TUFRG/LSF-Rig-GT2026-176284/Latest Assembly/Probe Holder Handoff/Documentation/BOM.xls

Bill of Material: Probe Holder Assy
Quantity | Part Number
2 | 94459A769_Heat-Set Inserts for Plastic
2 | Top Clamp
1 | Plunger Holder
1 | 4232N22_Press-Fit Ball-Nose Spring Plunger
1 | Brace
1 | Probe Holder/Turner
8 | 90128A217_Zinc-Plated Alloy Steel Socket Head Screw
8 | 90591A255_Zinc-Plated Steel Hex Nut
Recapitulation of: Probe Holder Assy
Different parts: 8
Total parts: 24
Quantity | Part Number
2 | 94459A769_Heat-Set Inserts for Plastic
2 | Top Clamp
1 | Plunger Holder
1 | 4232N22_Press-Fit Ball-Nose Spring Plunger
1 | Brace
1 | Probe Holder/Turner
8 | 90128A217_Zinc-Plated Alloy Steel Socket Head Screw
8 | 90591A255_Zinc-Plated Steel Hex Nut
