TUFRG/LSF-Rig-GT2026-176284/Latest Assembly/Probe Holder Handoff/90128A217_Zinc-Plated Alloy Steel Socket Head Screw.STEP

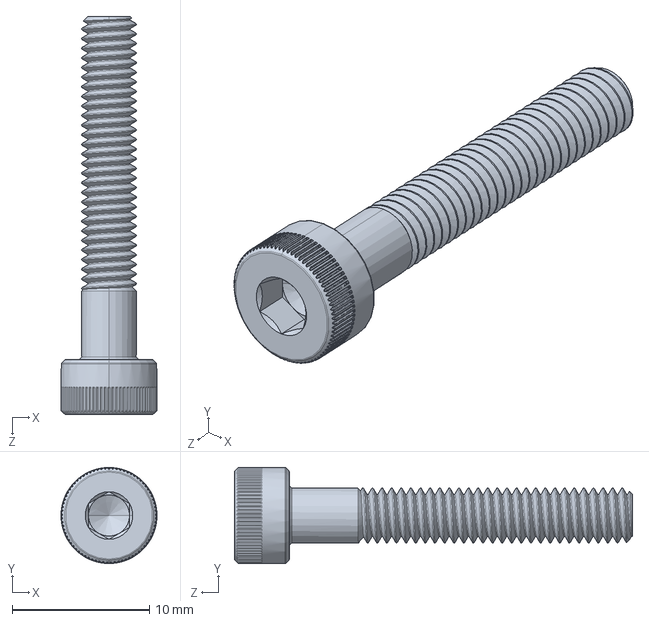
[picture p10: CAD file, 2026-10-14]
Latest Assembly/Probe Holder Handoff/90128A217_Zinc-Plated Alloy Steel Socket Head Screw.STEP
7.00 x 7.00 x 29.0 mm
