TUFRG/LSF-Rig-GT2026-176284/Latest Assembly/Probe Holder Handoff/94459A769_Heat-Set Inserts for Plastic.STEP

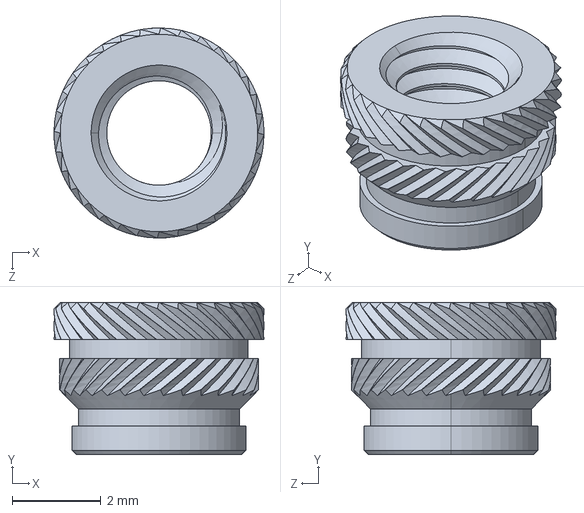
[picture p11: CAD file, 2026-10-14]
Latest Assembly/Probe Holder Handoff/94459A769_Heat-Set Inserts for Plastic.STEP
4.72 x 3.43 x 4.72 mm
