TUFRG/LSF-Rig-GT2026-176284/Latest Assembly/Probe Holder Handoff/90591A255_Zinc-Plated Steel Hex Nut.STEP

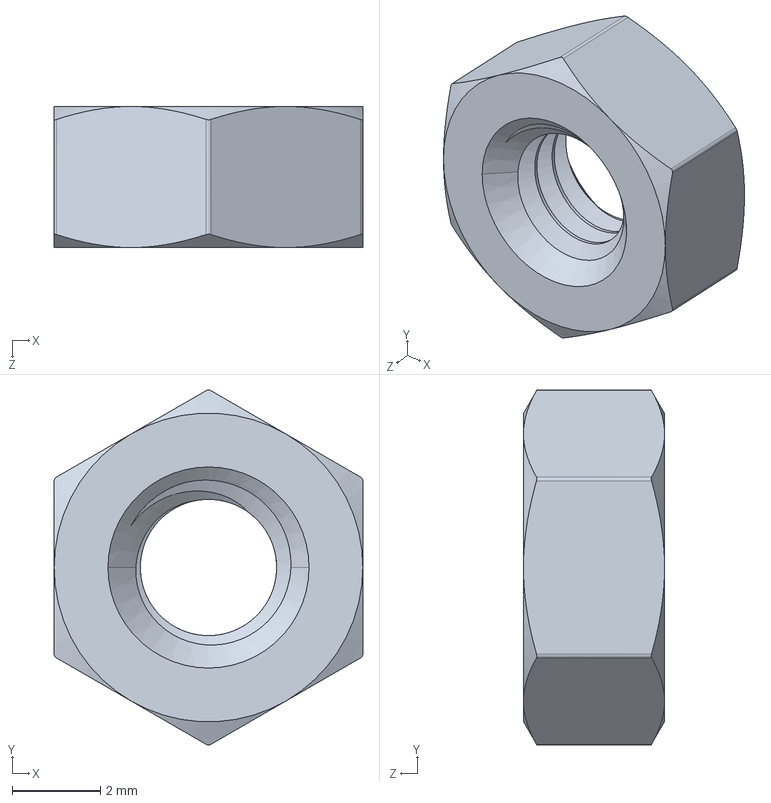
[picture p12: CAD file, 2026-10-14]
Latest Assembly/Probe Holder Handoff/90591A255_Zinc-Plated Steel Hex Nut.STEP
7.00 x 8.05 x 3.20 mm
