TUFRG/LSF-Rig-GT2026-176284/Latest Assembly/Probe Holder Handoff/4232N22_Press-Fit Ball-Nose Spring Plunger.STEP

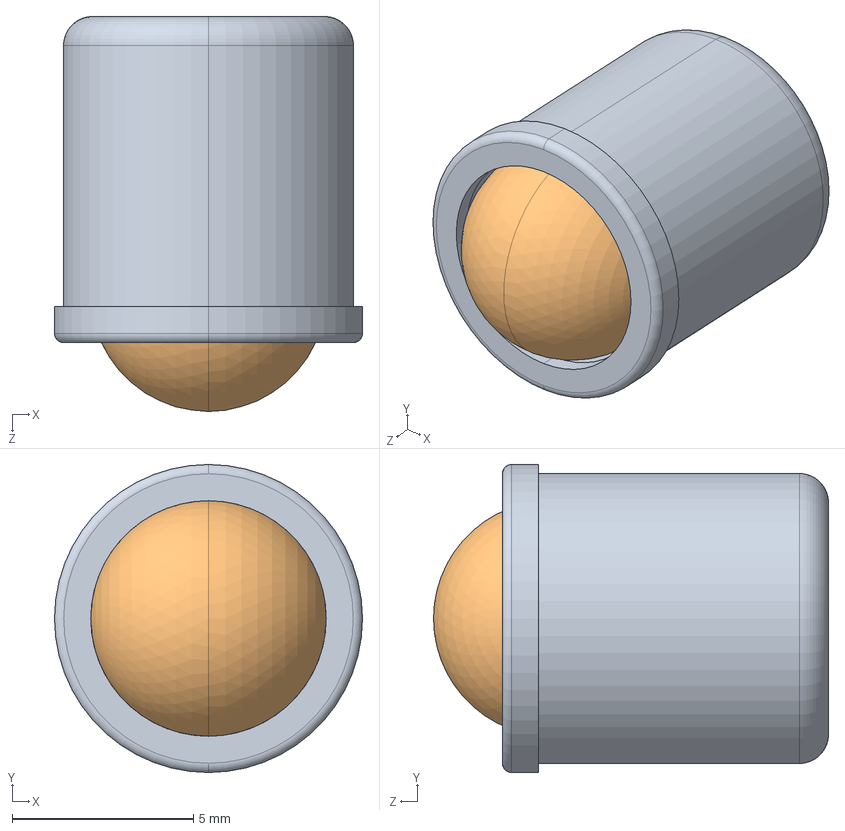
[picture p13: CAD file, 2026-10-14]
Latest Assembly/Probe Holder Handoff/4232N22_Press-Fit Ball-Nose Spring Plunger.STEP
8.50 x 8.50 x 10.9 mm
