TUFRG/LSF-Rig-GT2026-176284/(list of files, cad)

Other CAD files:
Latest Assembly/0_ISO-Bell Mouth.CATPart
Latest Assembly/10_Helical Rack.CATPart
Latest Assembly/11-Traverse Sliding Ring.CATPart
Latest Assembly/13-Rotor Hub Abradable - 2.CATPart
Latest Assembly/13-Rotor Hub Abradable 1.CATPart
Latest Assembly/14-Strut Hub Abradable - 2.CATPart
Latest Assembly/14-Strut Hub Abradable 1.CATPart
Latest Assembly/15-Upstream Traverse Plugs.CATPart
Latest Assembly/16-Downstream Traverse Plugs.CATPart
Latest Assembly/1_Distortion Screen Casing Ring.CATPart
Latest Assembly/2_Rotor Casing Ring.CATPart
Latest Assembly/3_Stator_Casing_Ring.CATPart
Latest Assembly/4_Strut Casing Ring.CATPart
Latest Assembly/5_Hub.CATPart
Latest Assembly/6391K332_Oil-Embedded 841 Bronze Sleeve Bearing.1.CATPart
Latest Assembly/6627T923_Stepper Motor.CATPart
Latest Assembly/6_Spinner.CATPart
Latest Assembly/8-Stator Sector 1.CATPart
Latest Assembly/8-Stator Sector 2.CATPart
Latest Assembly/8-Stator Sector 3.CATPart
Latest Assembly/9-Traverse Base Plate.CATPart
Latest Assembly/91860A030_17-7 PH Stainless Steel Washer.1.CATPart
Latest Assembly/92620A540_Zinc Yellow-Chromate Plated Hex Head Screw.3.CATPart
Latest Assembly/94033A426_Male-Female Pillar Post.1.CATPart
Latest Assembly/9657K495_Compression Spring.1.CATPart
Latest Assembly/97042A172_18-8 Stainless Steel Threaded on One End Stud.2.CATPart
Latest Assembly/Assembly.CATProduct
Latest Assembly/Base.CATPart
Latest Assembly/Collar Thrsut Bearing.CATPart
Latest Assembly/Delrin Sheet.CATPart
Latest Assembly/Extrusion Support/Motor Support/1000.CATPart
Latest Assembly/Extrusion Support/Motor Support/1000mm.CATPart
Latest Assembly/Extrusion Support/Motor Support/460.CATPart
Latest Assembly/Extrusion Support/Motor Support/5537T946_T-Slotted Framing.CATPart
Latest Assembly/Extrusion Support/Motor Support/Base for Extrusion.CATPart
Latest Assembly/Extrusion Support/Motor Support/Motor Support base.CATPart
Latest Assembly/Extrusion Support/Motor Support/Motor Support.CATProduct
Latest Assembly/Extrusion Support/Motor Support/Motor base.CATPart
Latest Assembly/Extrusion Support/Motor Support/Motor.CATPart
Latest Assembly/Extrusion Support/Motor Support/Part1.CATPart
Latest Assembly/Extrusion Support/Motor Support/Plenum Leg Block.CATPart
Latest Assembly/Extrusion Support/Motor Support/QF100AssemblyWRed.CATPart
Latest Assembly/Extrusion Support/Motor Support/Support Leg Block.CATPart
Latest Assembly/Extrusion Support/Motor Support/Support Mockup.CATPart
Latest Assembly/Extrusion Support/Support 1 Base/12in brace.CATPart
Latest Assembly/Extrusion Support/Support 1 Base/200mm.CATPart
Latest Assembly/Extrusion Support/Support 1 Base/23595T17_Zinc-Plated Steel Wheel Axle (1).CATPart
Latest Assembly/Extrusion Support/Support 1 Base/2781T52_Polypropylene Wheel (1).CATPart
Latest Assembly/Extrusion Support/Support 1 Base/440mm.CATPart
Latest Assembly/Extrusion Support/Support 1 Base/5537T201_T-Slotted Framing.CATPart
Latest Assembly/Extrusion Support/Support 1 Base/570mm.CATPart
Latest Assembly/Extrusion Support/Support 1 Base/6in Brace.CATPart
Latest Assembly/Extrusion Support/Support 1 Base/94639A263_Off-White Nylon Unthreaded Spacer (1).CATPart
Latest Assembly/Extrusion Support/Support 1 Base/960mm.CATPart
Latest Assembly/Extrusion Support/Support 1 Base/Base Plate.CATPart
Latest Assembly/Extrusion Support/Support 1 Base/Connector.CATPart
Latest Assembly/Extrusion Support/Support 1 Base/Feet.CATPart
Latest Assembly/Extrusion Support/Support 1 Base/Gusset.CATPart
Latest Assembly/Extrusion Support/Support 1 Base/Part1.CATPart
Latest Assembly/Extrusion Support/Support 1 Base/Part2.CATPart
Latest Assembly/Extrusion Support/Support 1 Base/Support-1.CATProduct
Latest Assembly/Extrusion Support/Support 2/340mm.CATPart
Latest Assembly/Extrusion Support/Support 2/5537T373_T-Slotted Framing.CATPart
Latest Assembly/Extrusion Support/Support 2/5537T621_T-Slotted Framing.CATPart
Latest Assembly/Extrusion Support/Support 2/5537T671_T-Slotted Framing.CATPart
Latest Assembly/Extrusion Support/Support 2/560.CATPart
Latest Assembly/Extrusion Support/Support 2/650.CATPart
Latest Assembly/Extrusion Support/Support 2/760.CATPart
Latest Assembly/Extrusion Support/Support 2/90 connect.CATPart
Latest Assembly/Extrusion Support/Support 2/90 dbl feet.CATPart
Latest Assembly/Extrusion Support/Support 2/Connectpor.CATPart
Latest Assembly/Extrusion Support/Support 2/Part1.CATPart
Latest Assembly/Extrusion Support/Support 2/Part2.CATPart
Latest Assembly/Extrusion Support/Support 2/Support 2.CATProduct
Latest Assembly/Extrusion Support/Support 2/feet 45.CATPart
Latest Assembly/Extrusion Support/Support 3/12in brace.CATPart
Latest Assembly/Extrusion Support/Support 3/210mm.CATPart
Latest Assembly/Extrusion Support/Support 3/23595T17_Zinc-Plated Steel Wheel Axle (1).CATPart
Latest Assembly/Extrusion Support/Support 3/2781T52_Polypropylene Wheel (1).CATPart
Latest Assembly/Extrusion Support/Support 3/340mm.CATPart
Latest Assembly/Extrusion Support/Support 3/460mm.CATPart
Latest Assembly/Extrusion Support/Support 3/47065T121_T-Slotted Framing.CATPart
Latest Assembly/Extrusion Support/Support 3/47065T121_T-Slotted Framing_1.CATPart
Latest Assembly/Extrusion Support/Support 3/47065T121_T-Slotted Framing_2.CATPart
Latest Assembly/Extrusion Support/Support 3/47065T121_T-Slotted Framing_3.CATPart
Latest Assembly/Extrusion Support/Support 3/47065T121_T-Slotted Framing_4.CATPart
Latest Assembly/Extrusion Support/Support 3/47065T329_T-Slotted Framing.CATPart
Latest Assembly/Extrusion Support/Support 3/47065T841_T-Slotted Framing.CATPart
Latest Assembly/Extrusion Support/Support 3/4844N136_T-Slotted Framing Structural Bracket.CATPart
Latest Assembly/Extrusion Support/Support 3/570mm.CATPart
Latest Assembly/Extrusion Support/Support 3/6in Brace.CATPart
Latest Assembly/Extrusion Support/Support 3/760mm.CATPart
Latest Assembly/Extrusion Support/Support 3/94639A263_Off-White Nylon Unthreaded Spacer (1).CATPart
Latest Assembly/Extrusion Support/Support 3/BASE.CATPart
Latest Assembly/Extrusion Support/Support 3/BAse palte.CATPart
Latest Assembly/Extrusion Support/Support 3/Base mount.CATPart
Latest Assembly/Extrusion Support/Support 3/Connector.CATPart
Latest Assembly/Extrusion Support/Support 3/Feet.CATPart
Latest Assembly/Extrusion Support/Support 3/Gusset.CATPart
Latest Assembly/Extrusion Support/Support 3/RS BASE PLATE.CATPart
Latest Assembly/Extrusion Support/Support 3/Support Structure.CATProduct
Latest Assembly/Extrusion Support/Support 3/Support-3.CATProduct
Latest Assembly/Extrusion Support/Support Structure Updates/1.5ft.CATPart
Latest Assembly/Extrusion Support/Support Structure Updates/100.CATPart
Latest Assembly/Extrusion Support/Support Structure Updates/1000.CATPart
Latest Assembly/Extrusion Support/Support Structure Updates/1000mm.CATPart
Latest Assembly/Extrusion Support/Support Structure Updates/12in brace.CATPart
Latest Assembly/Extrusion Support/Support Structure Updates/18in brace.CATPart
Latest Assembly/Extrusion Support/Support Structure Updates/210mm.CATPart
Latest Assembly/Extrusion Support/Support Structure Updates/2ft.CATPart
Latest Assembly/Extrusion Support/Support Structure Updates/2x1_Frame.CATPart
Latest Assembly/Extrusion Support/Support Structure Updates/2x4_Slit_Frame.CATPart
Latest Assembly/Extrusion Support/Support Structure Updates/340mm.CATPart
Latest Assembly/Extrusion Support/Support Structure Updates/420.CATPart
Latest Assembly/Extrusion Support/Support Structure Updates/460.CATPart
Latest Assembly/Extrusion Support/Support Structure Updates/460mm.CATPart
Latest Assembly/Extrusion Support/Support Structure Updates/47065T121_T-Slotted Framing.CATPart
Latest Assembly/Extrusion Support/Support Structure Updates/47065T121_T-Slotted Framing_1.CATPart
Latest Assembly/Extrusion Support/Support Structure Updates/47065T121_T-Slotted Framing_2.CATPart
Latest Assembly/Extrusion Support/Support Structure Updates/47065T121_T-Slotted Framing_3.CATPart
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
