TUFRG/LSF-Rig-GT2026-176284/Latest Assembly/Probe Holder Handoff/Documentation/Drawings/Proble Holder-Turner.pdf

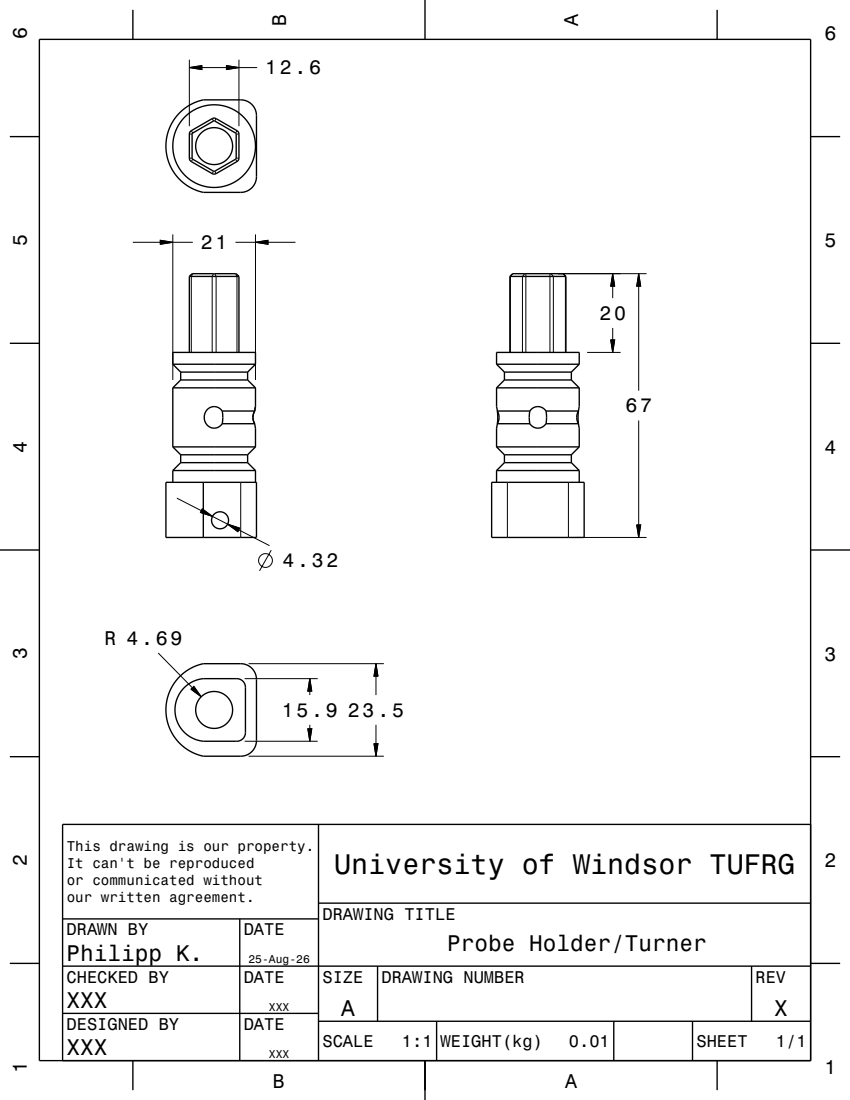
[picture p14: page 1]
DRAWING TITLE

This drawing is our property.
It can't be reproduced
or communicated without
our written agreement.

University of Windsor TUFRG

DRAWN BY Philipp K. | DATE 25-Aug-26

Probe Holder/Turner

CHECKED BY XXX | DATE XXX | SIZE A | DRAWING NUMBER | REV X

DESIGNED BY XXX | DATE XXX

SCALE 1:1 | WEIGHT(kg) 0.01 | SHEET 1/1
