TUFRG/LSF-Rig-GT2026-176284/Engineering Drawings/12-Venturi Meter.pdf

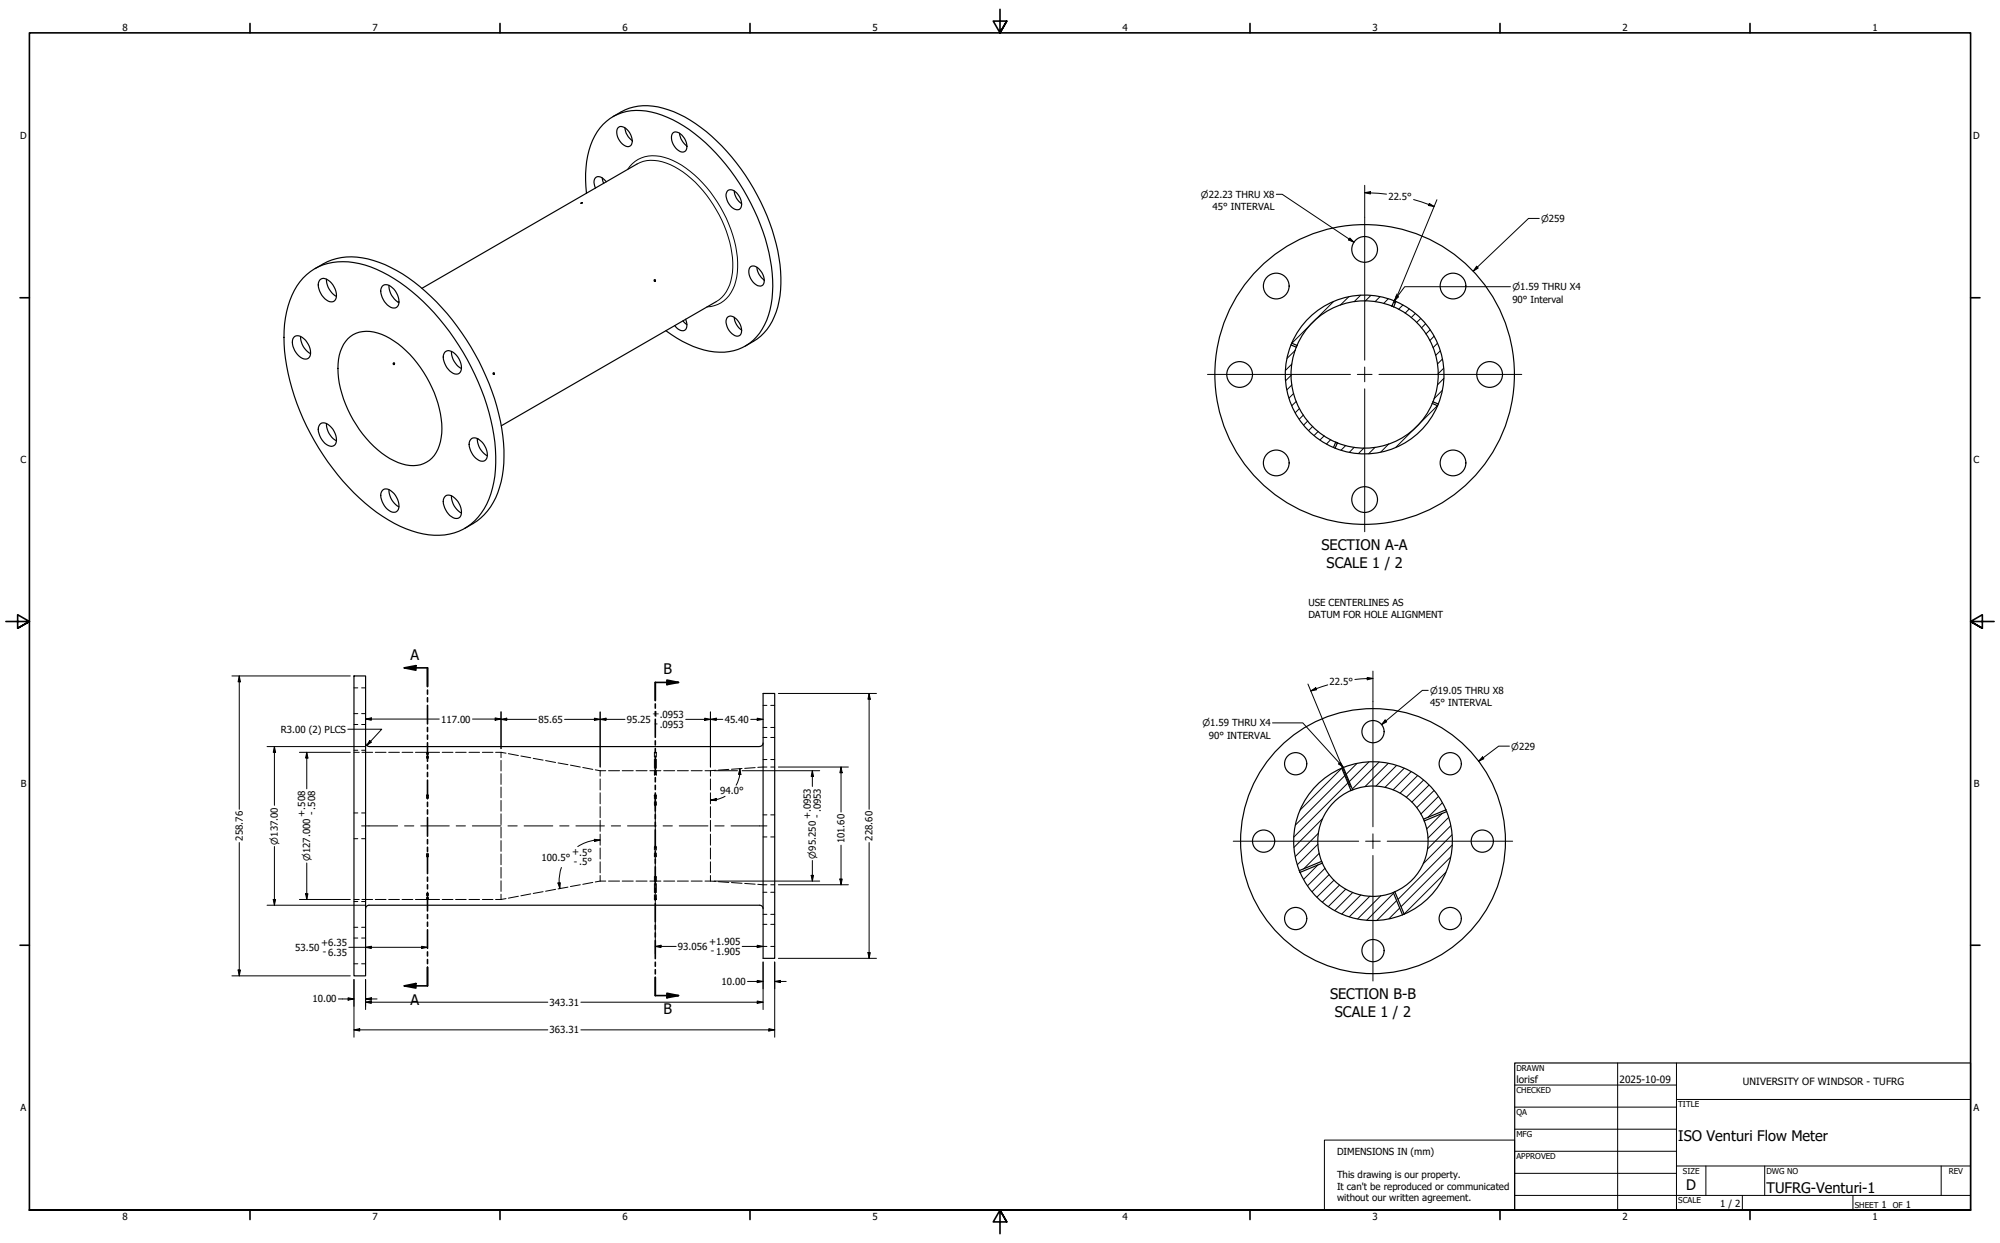
[picture p16: page 1]
SECTION A-A SCALE 1 / 2; SECTION B-B SCALE 1 / 2; R3.00 (2) PLCS; ⌀1.59 THRU X4; 90° Interval; 90° INTERVAL; ⌀22.23 THRU X8; 45° INTERVAL; ⌀19.05 THRU X8

USE CENTERLINES AS
DATUM FOR HOLE ALIGNMENT

DRAWN lorisf | 2025-10-09 | UNIVERSITY OF WINDSOR - TUFRG

CHECKED

MFG

ISO Venturi Flow Meter

DIMENSIONS IN (mm)

APPROVED

SIZE D | DWG NO TUFRG-Venturi-1 | REV

This drawing is our property.
It can't be reproduced or communicated
without our written agreement.

SCALE 1 / 2 | | SHEET 1 OF 1
