TUFRG/LSF-Rig-GT2026-176284/Engineering Drawings/PlexiStrip.pdf

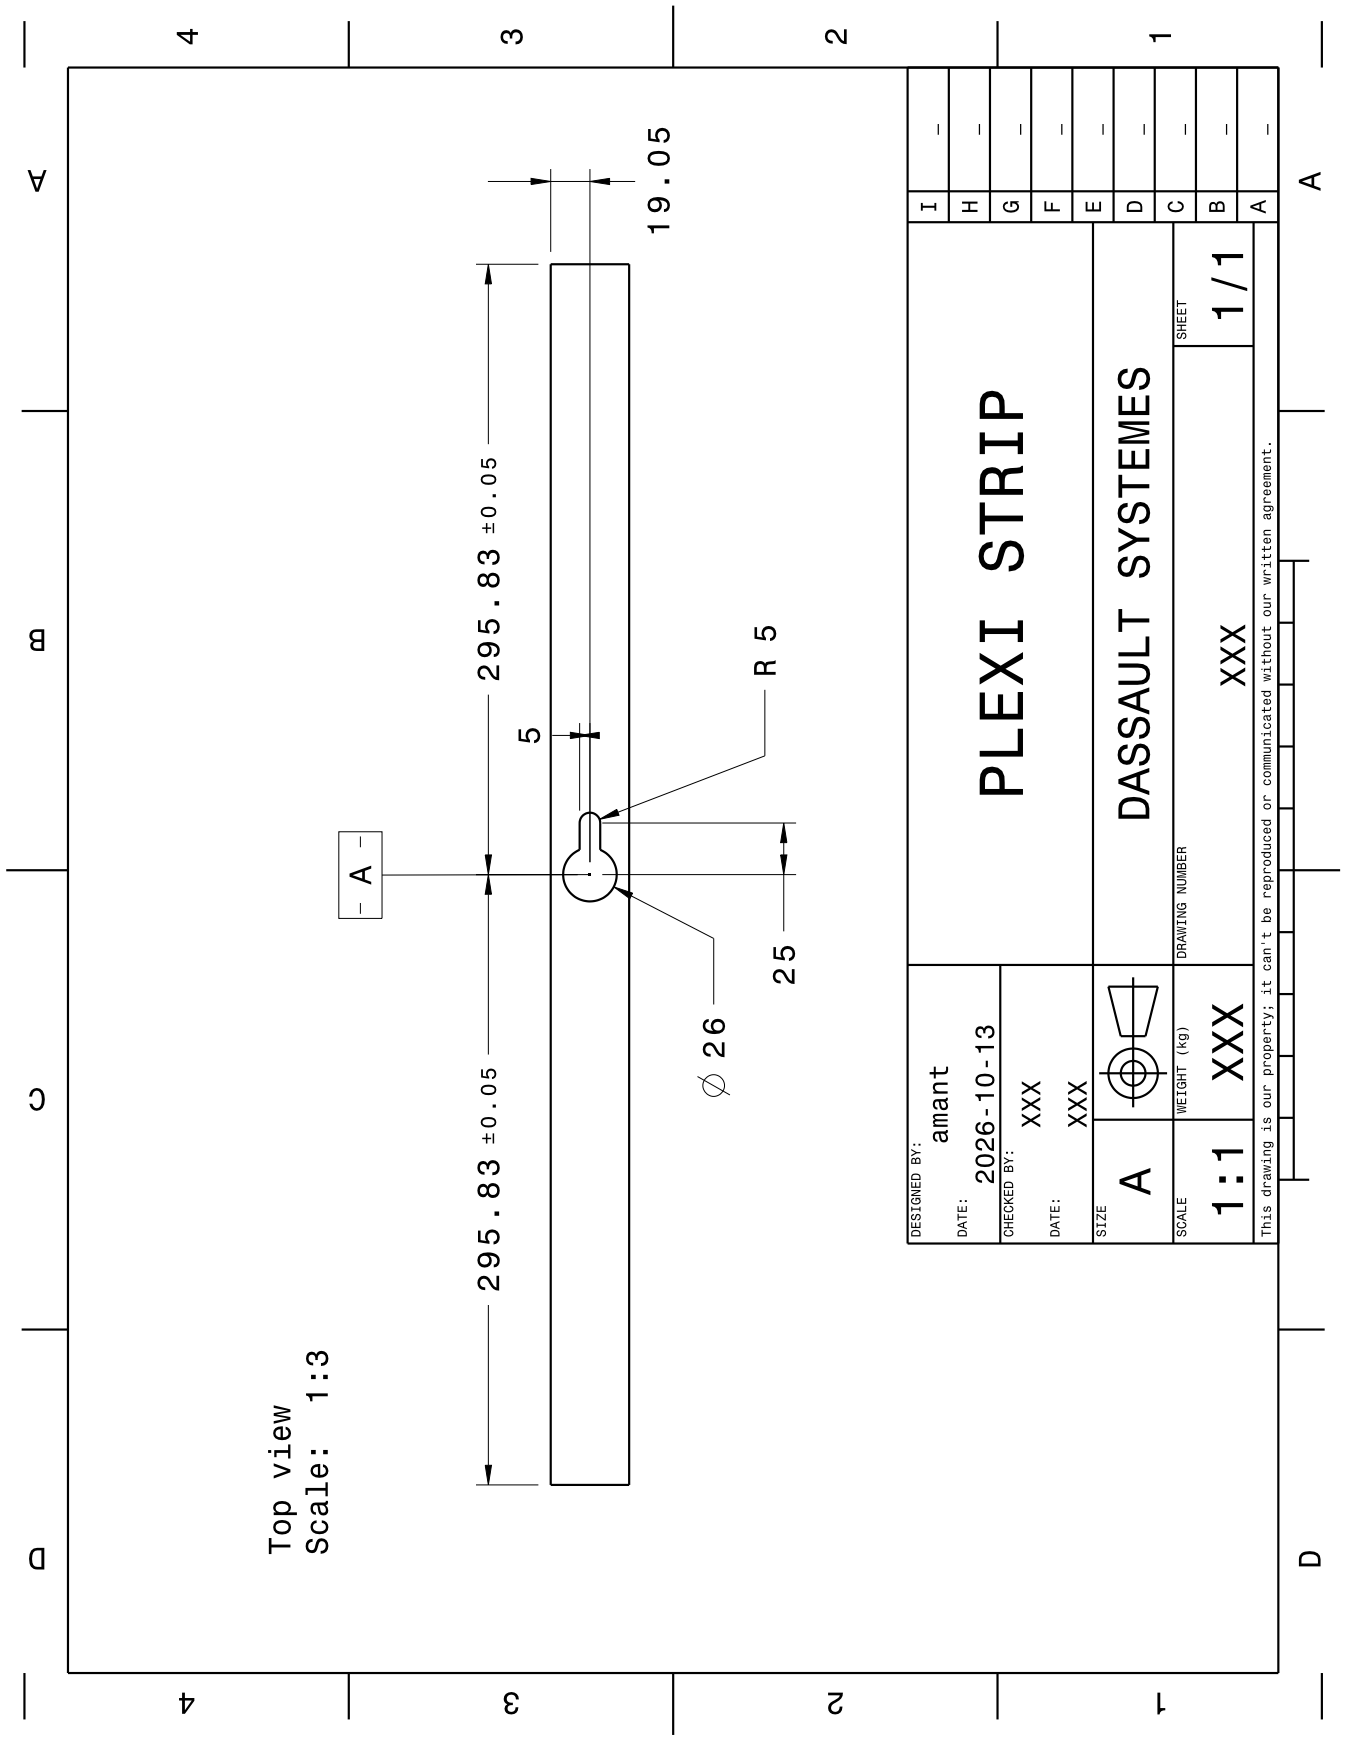
[picture p17: page 1]
