TUFRG/LSF-Rig-GT2026-176284/Engineering Drawings/Axial Support Base Plate Drawing.pdf

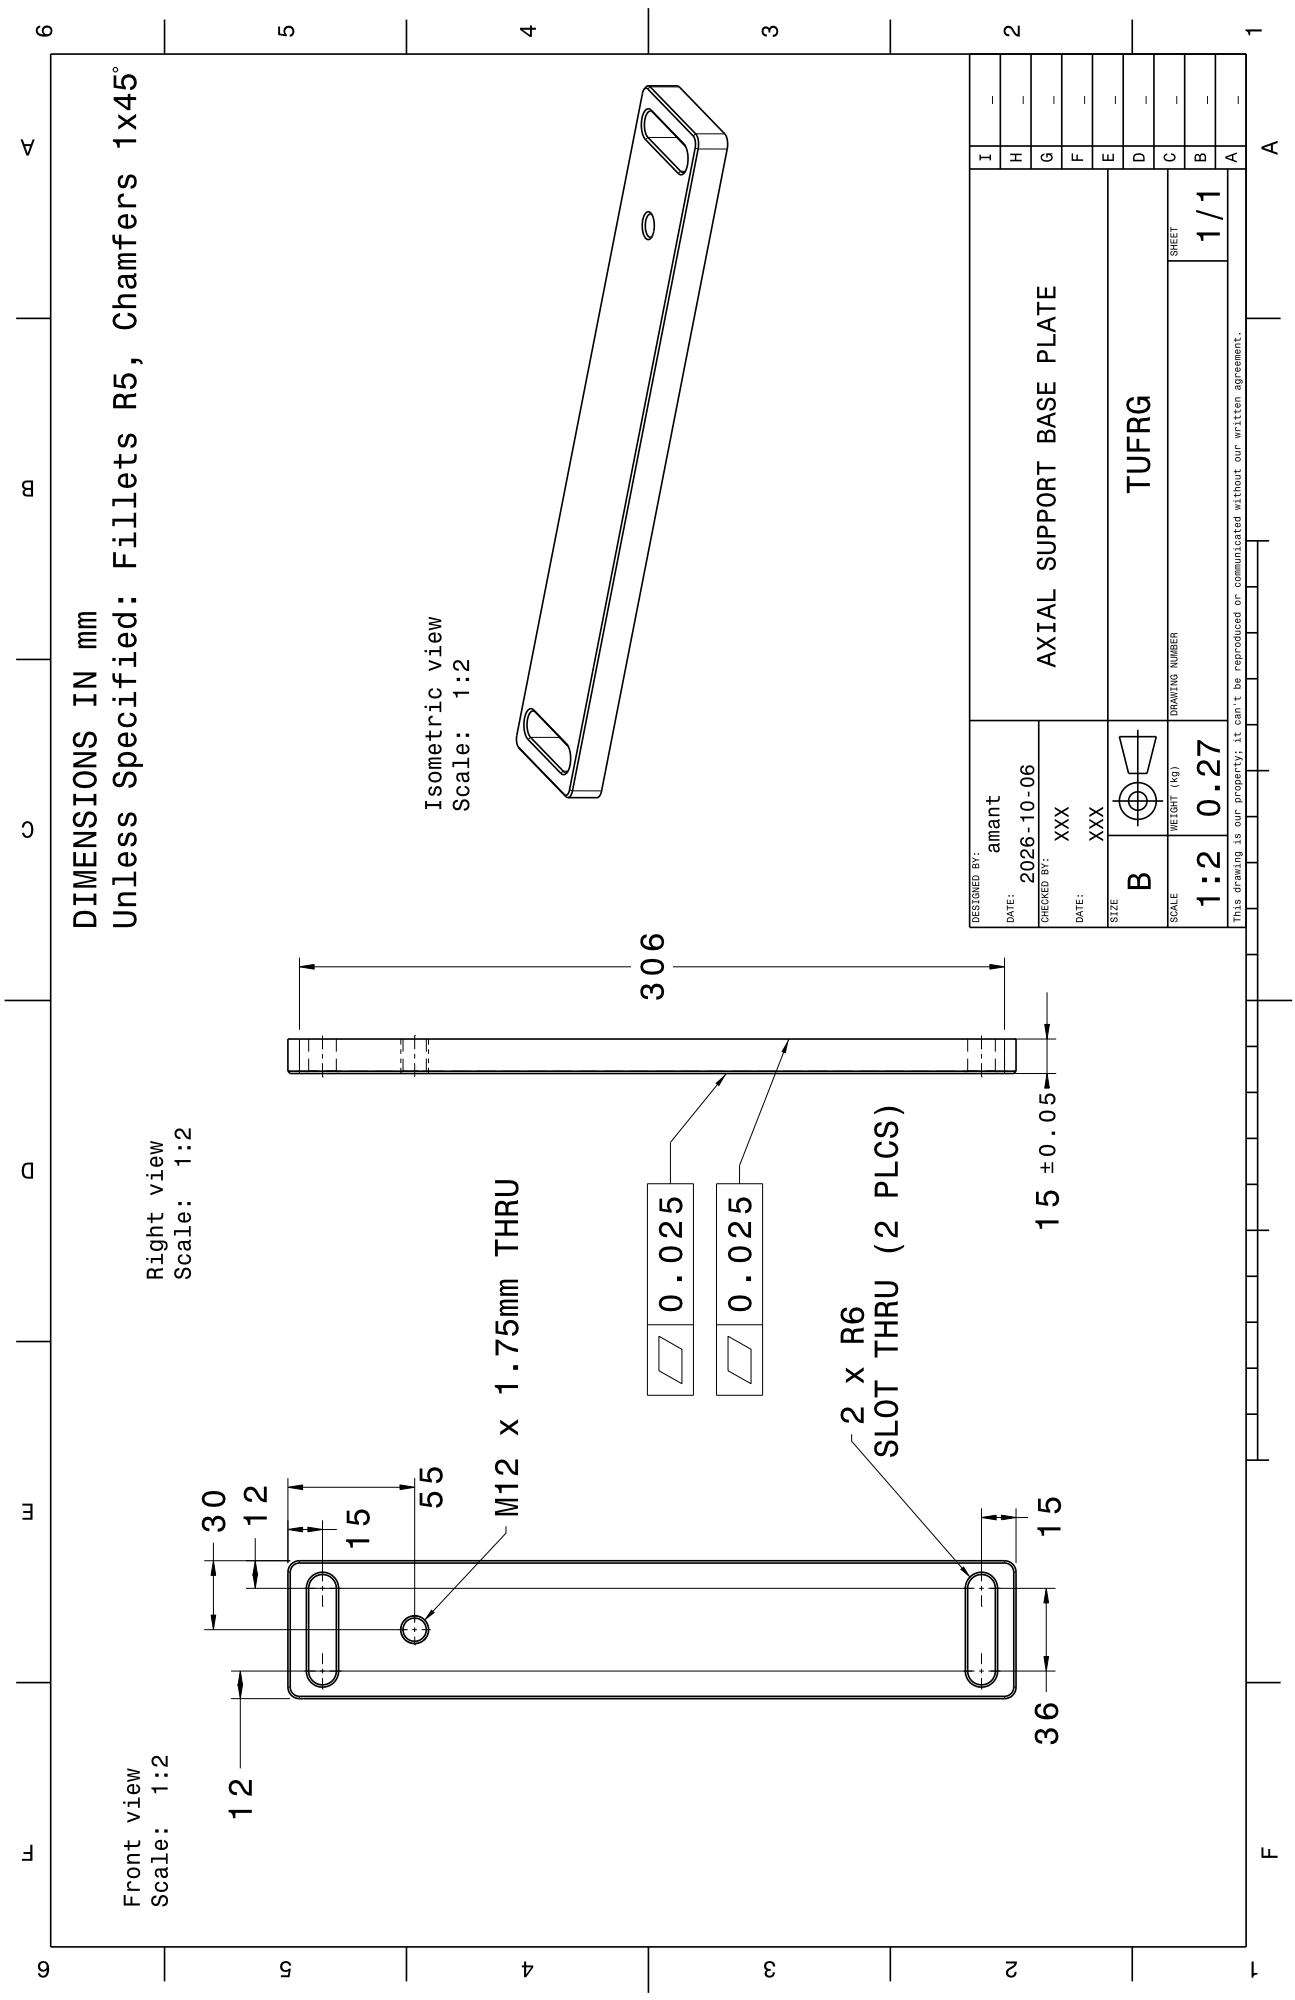
[picture p18: page 1]
