TUFRG/LSF-Rig-GT2026-176284/Engineering Drawings/Lateral Support Base Plate Drawing.pdf

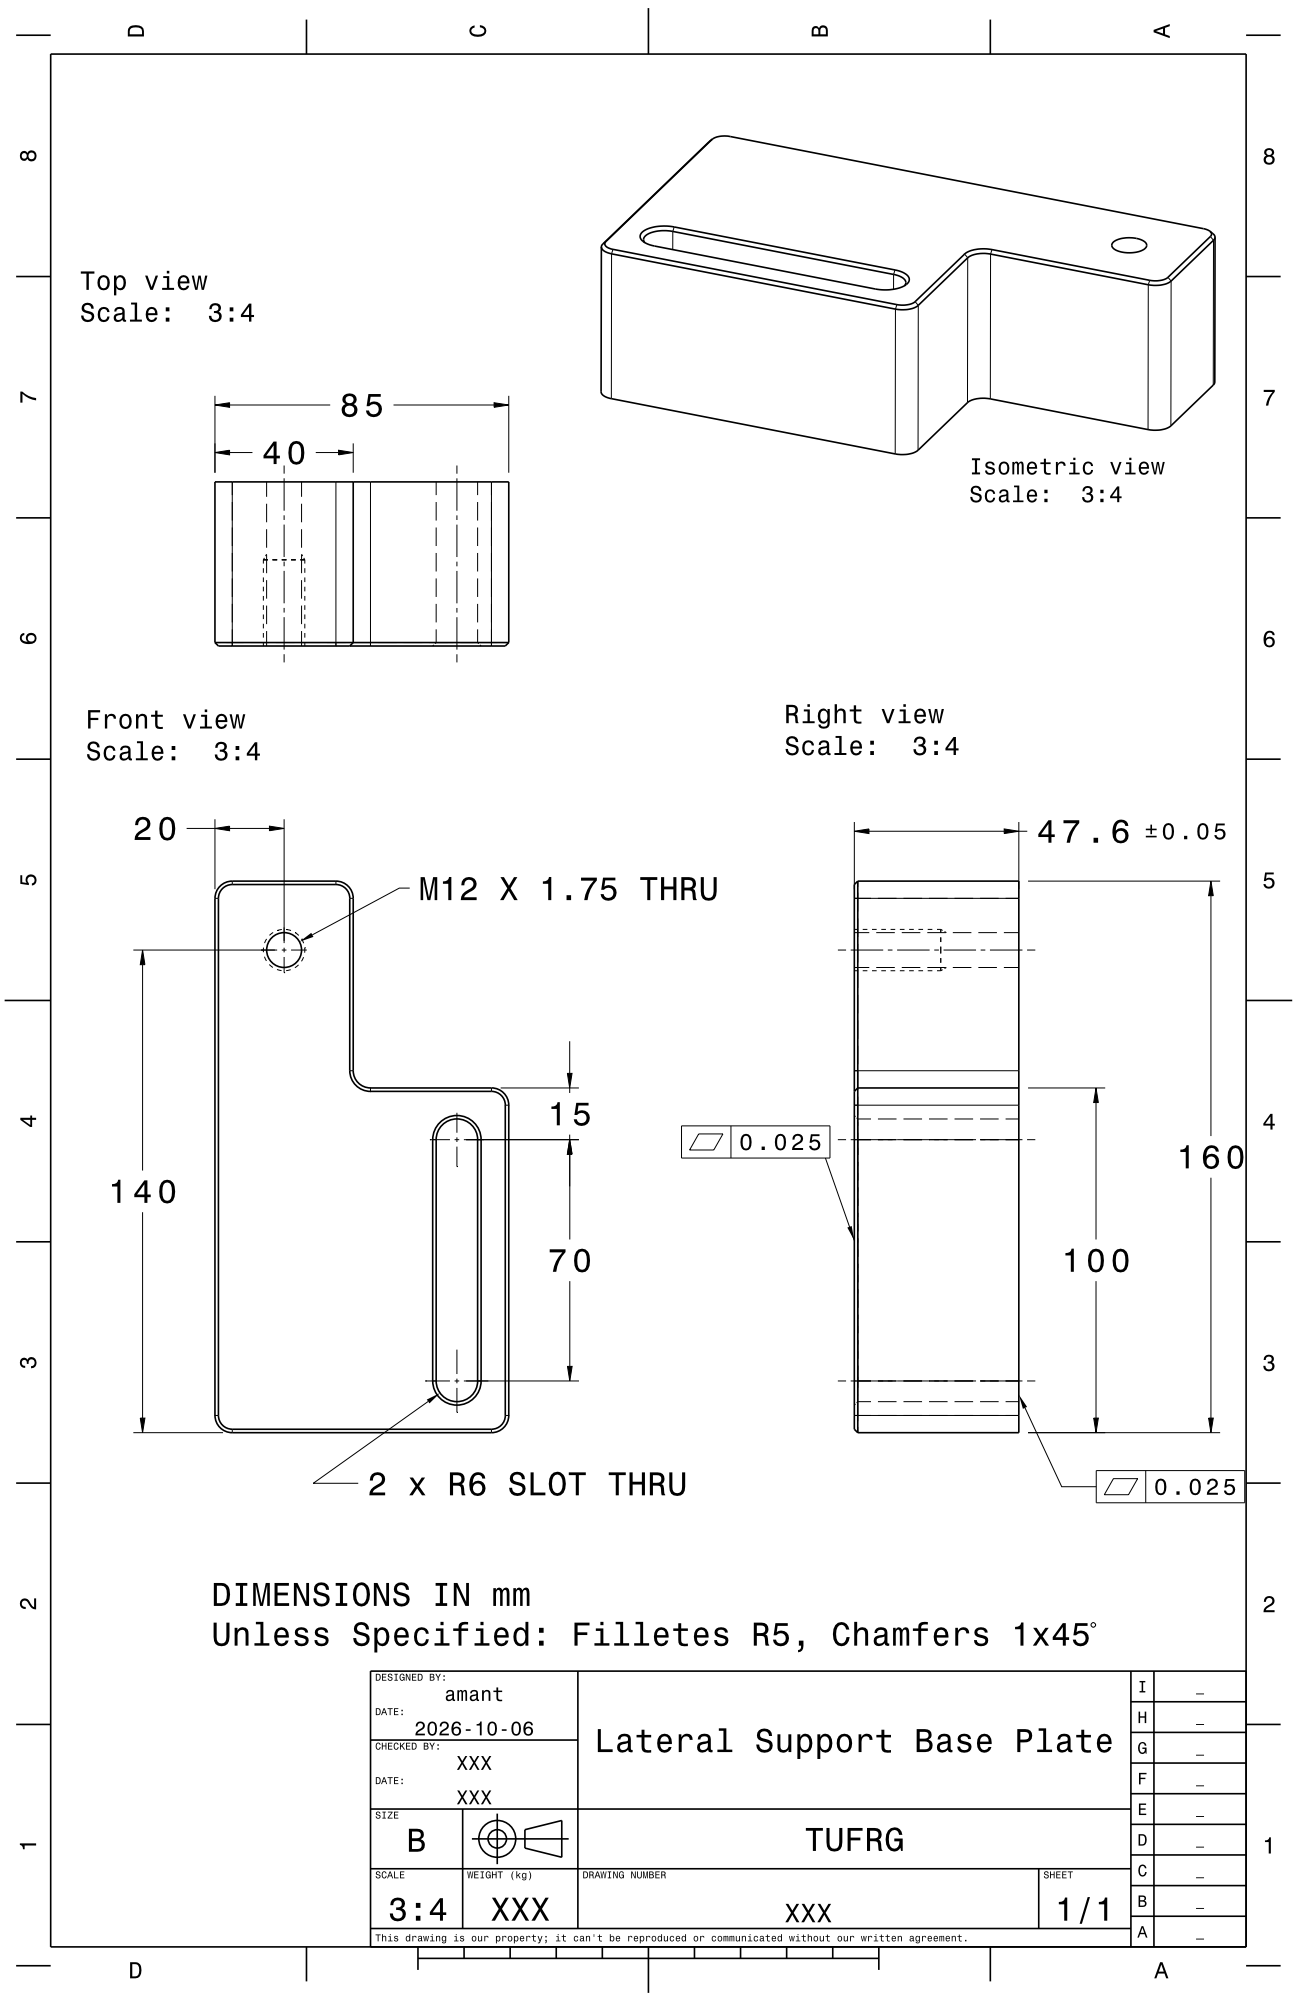
[picture p19: page 1]
