TUFRG/LSF-Rig-GT2026-176284/Engineering Drawings/Lateral Support Base Plate Updated Drawing.pdf

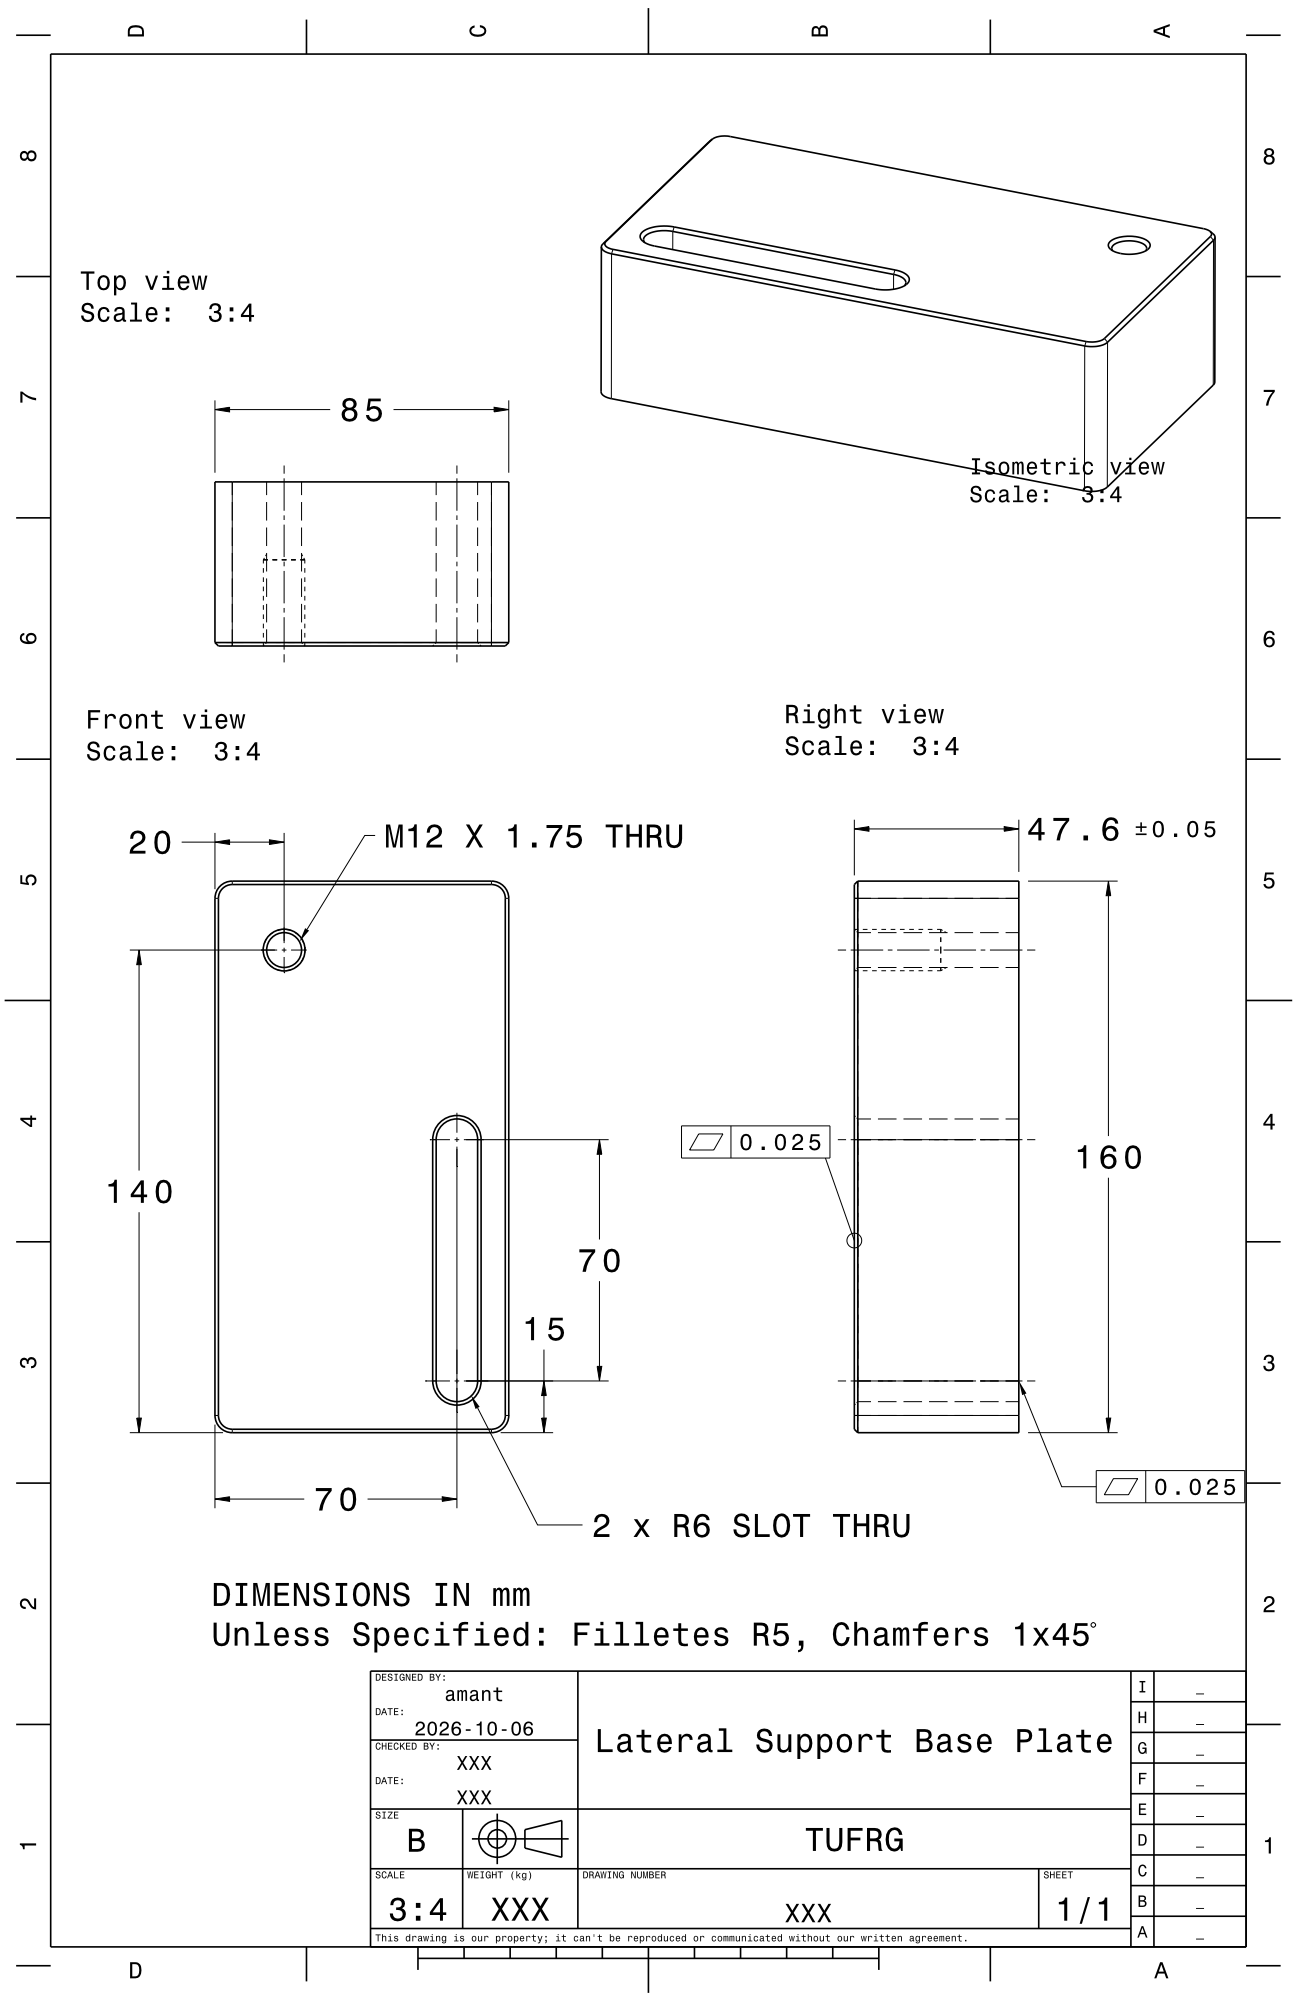
[picture p20: page 1]
