TUFRG/LSF-Rig-GT2026-176284/Engineering Drawings/Wood Base Replacement.pdf

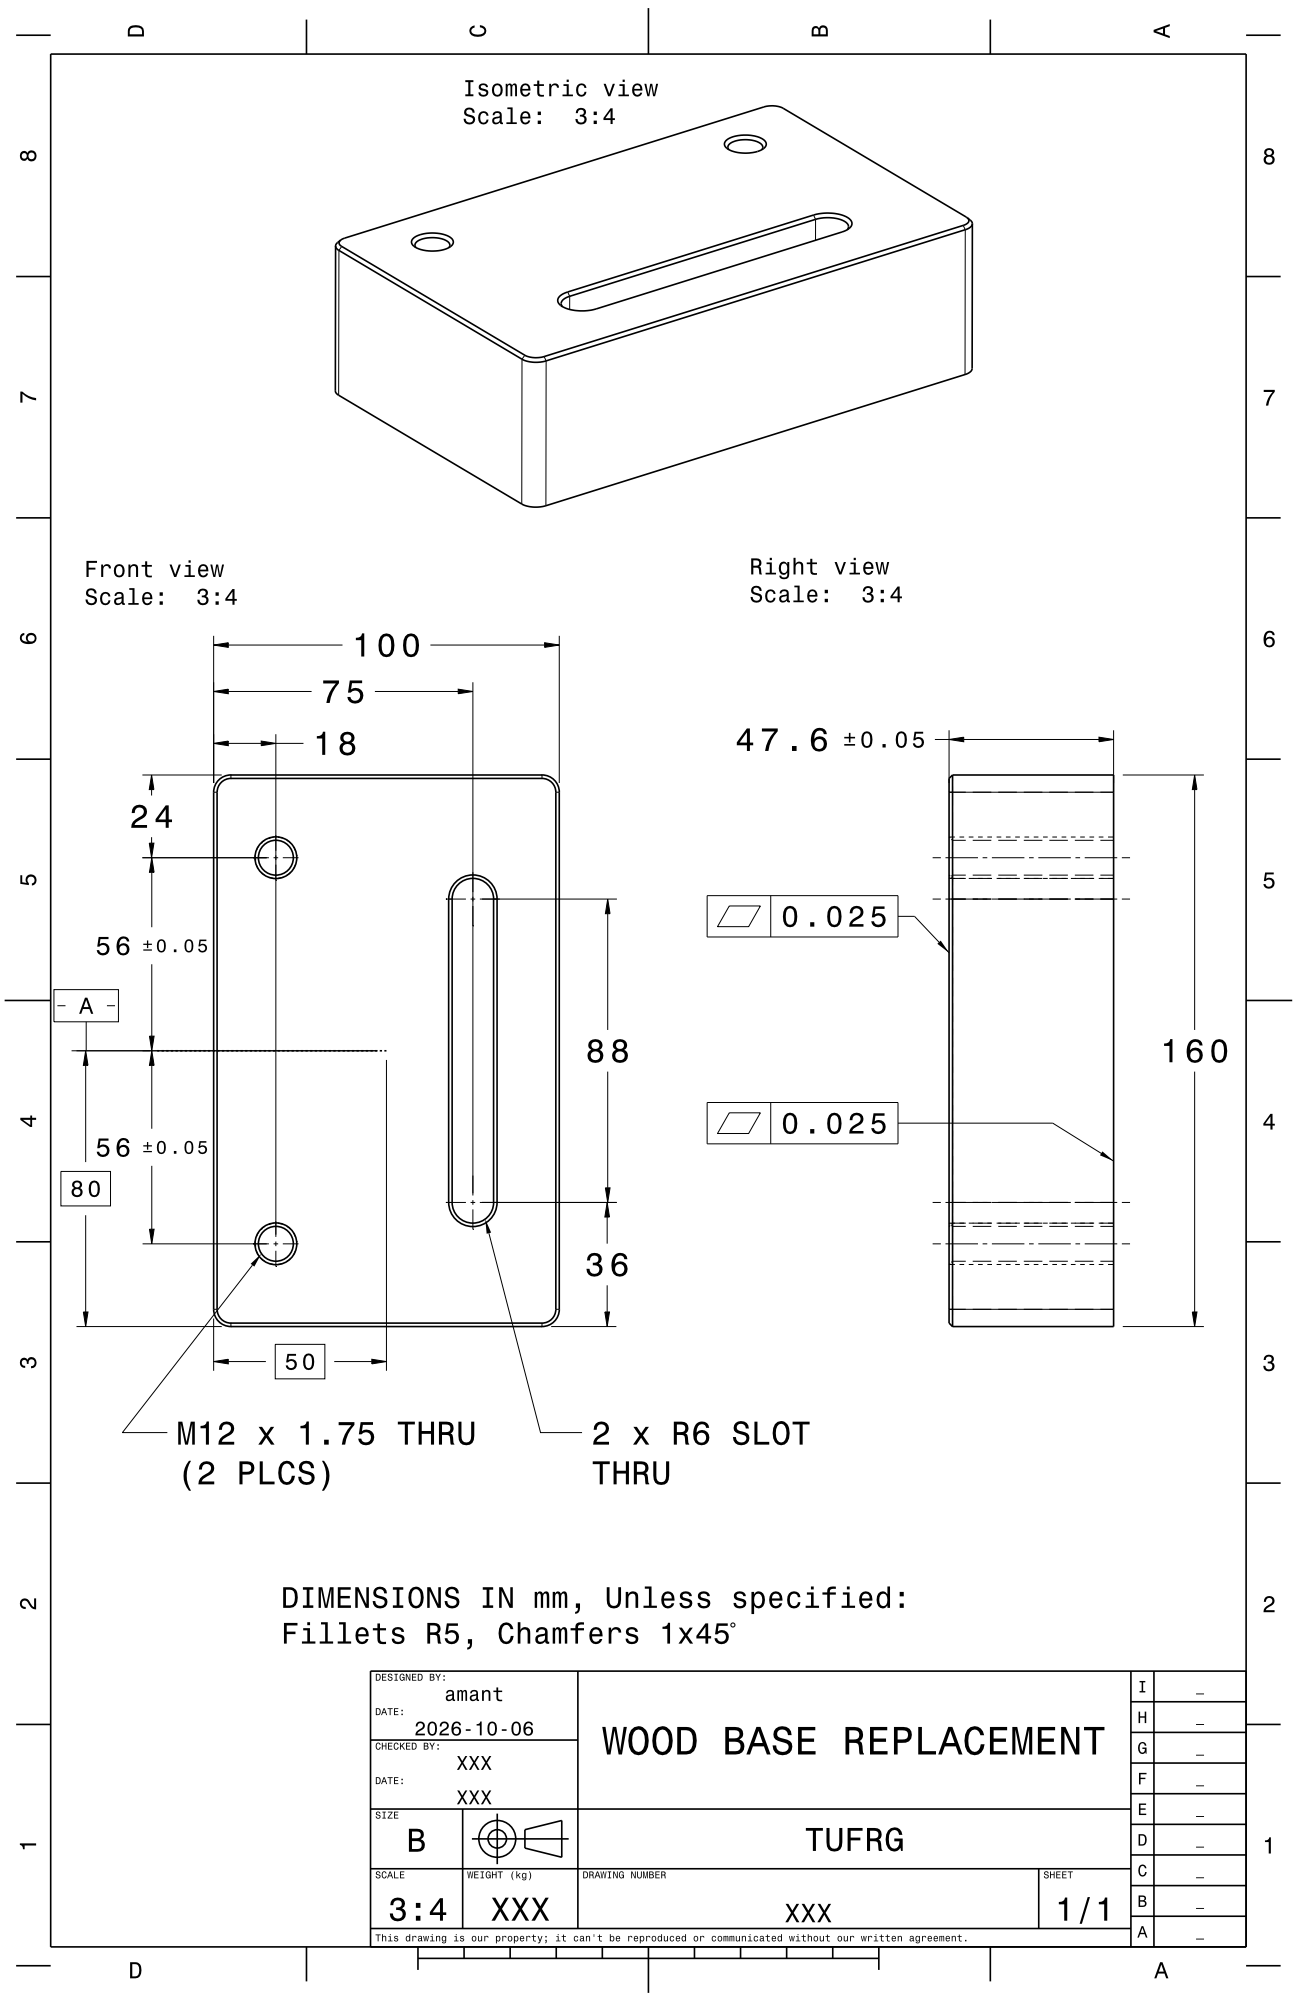
[picture p21: page 1]
