TUFRG/LSF-Rig-GT2026-176284/Engineering Drawings/0-BELLMOUTH.pdf

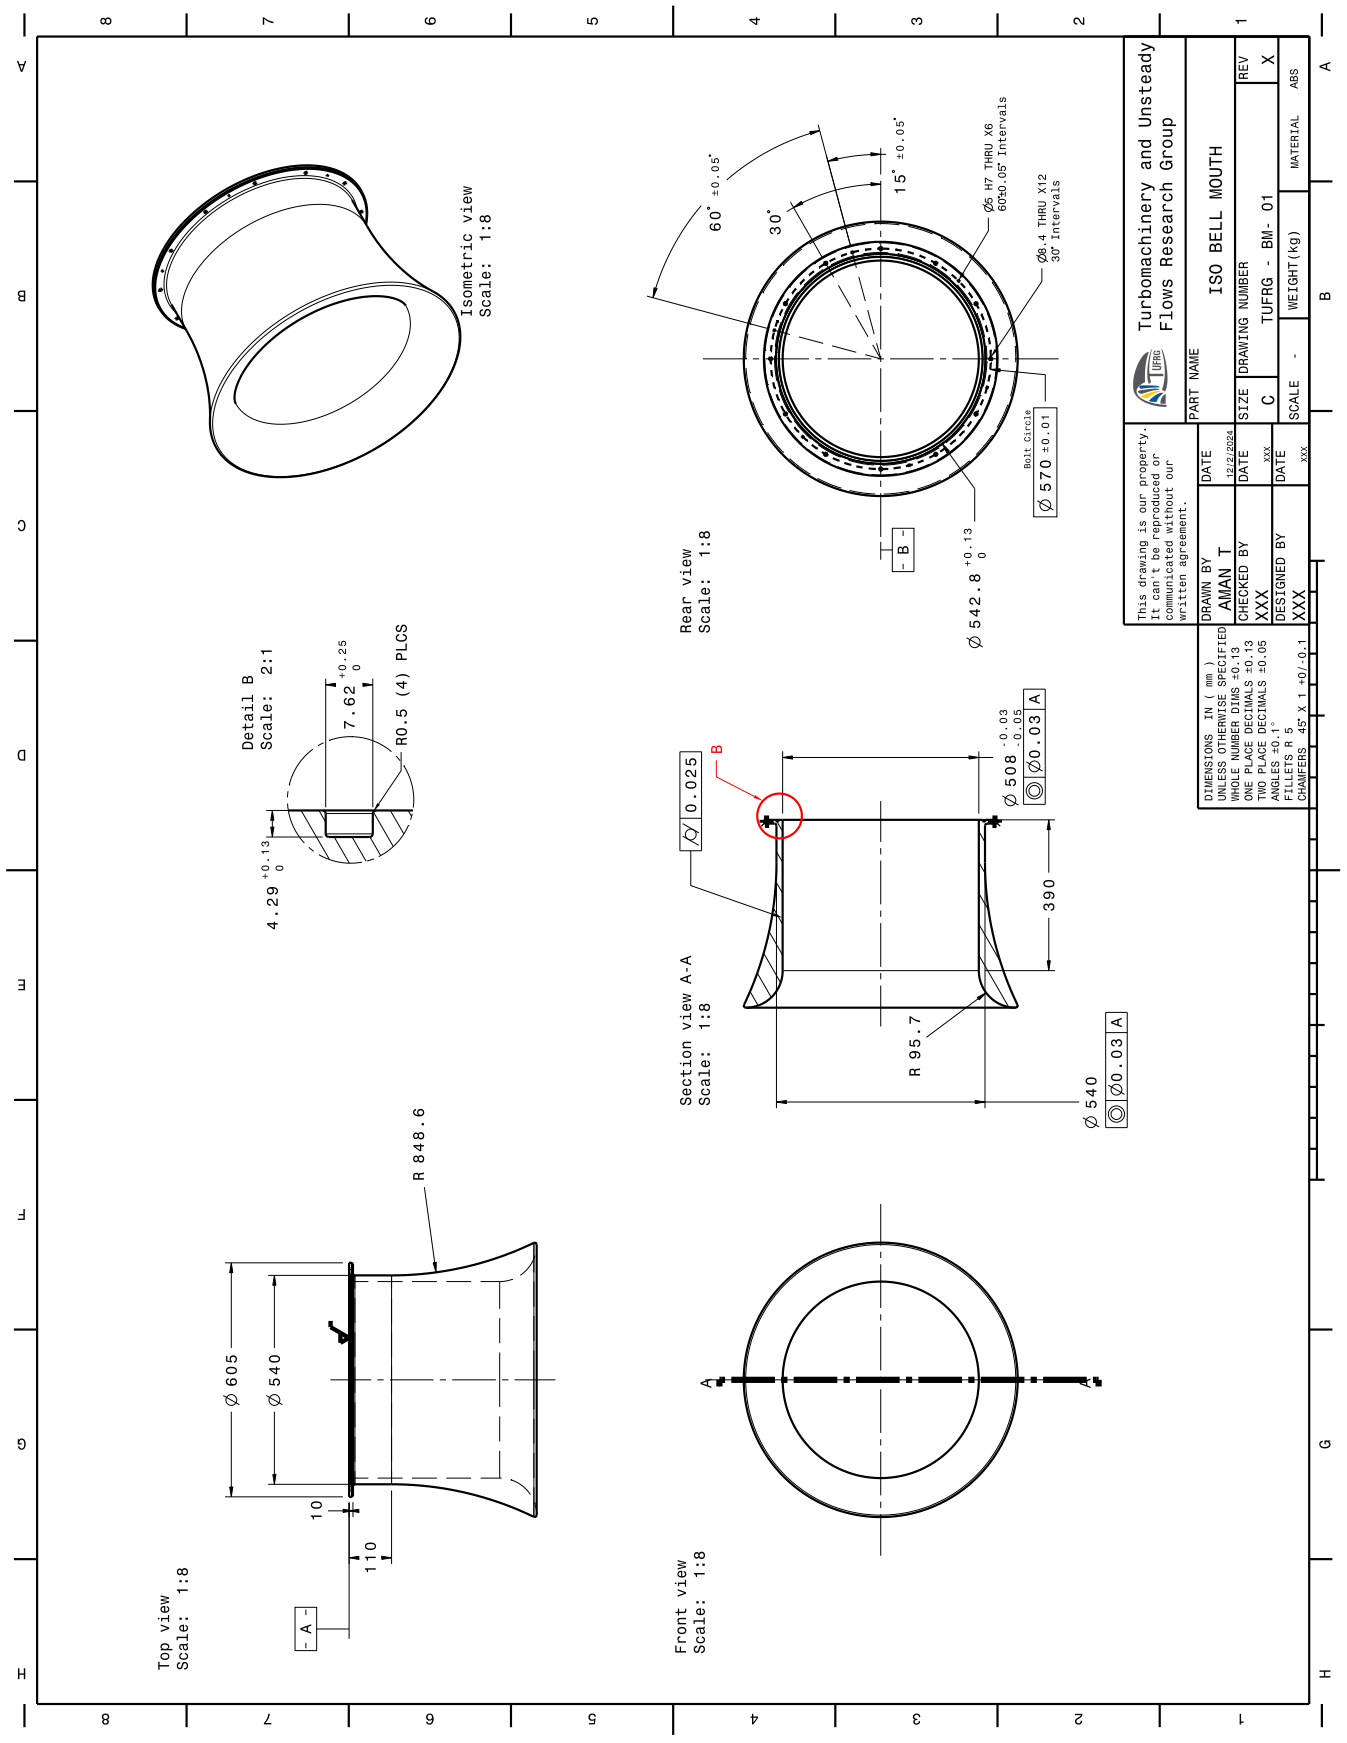
[picture p22: page 1]
