TUFRG/LSF-Rig-GT2026-176284/Engineering Drawings/1-CASING RING.pdf

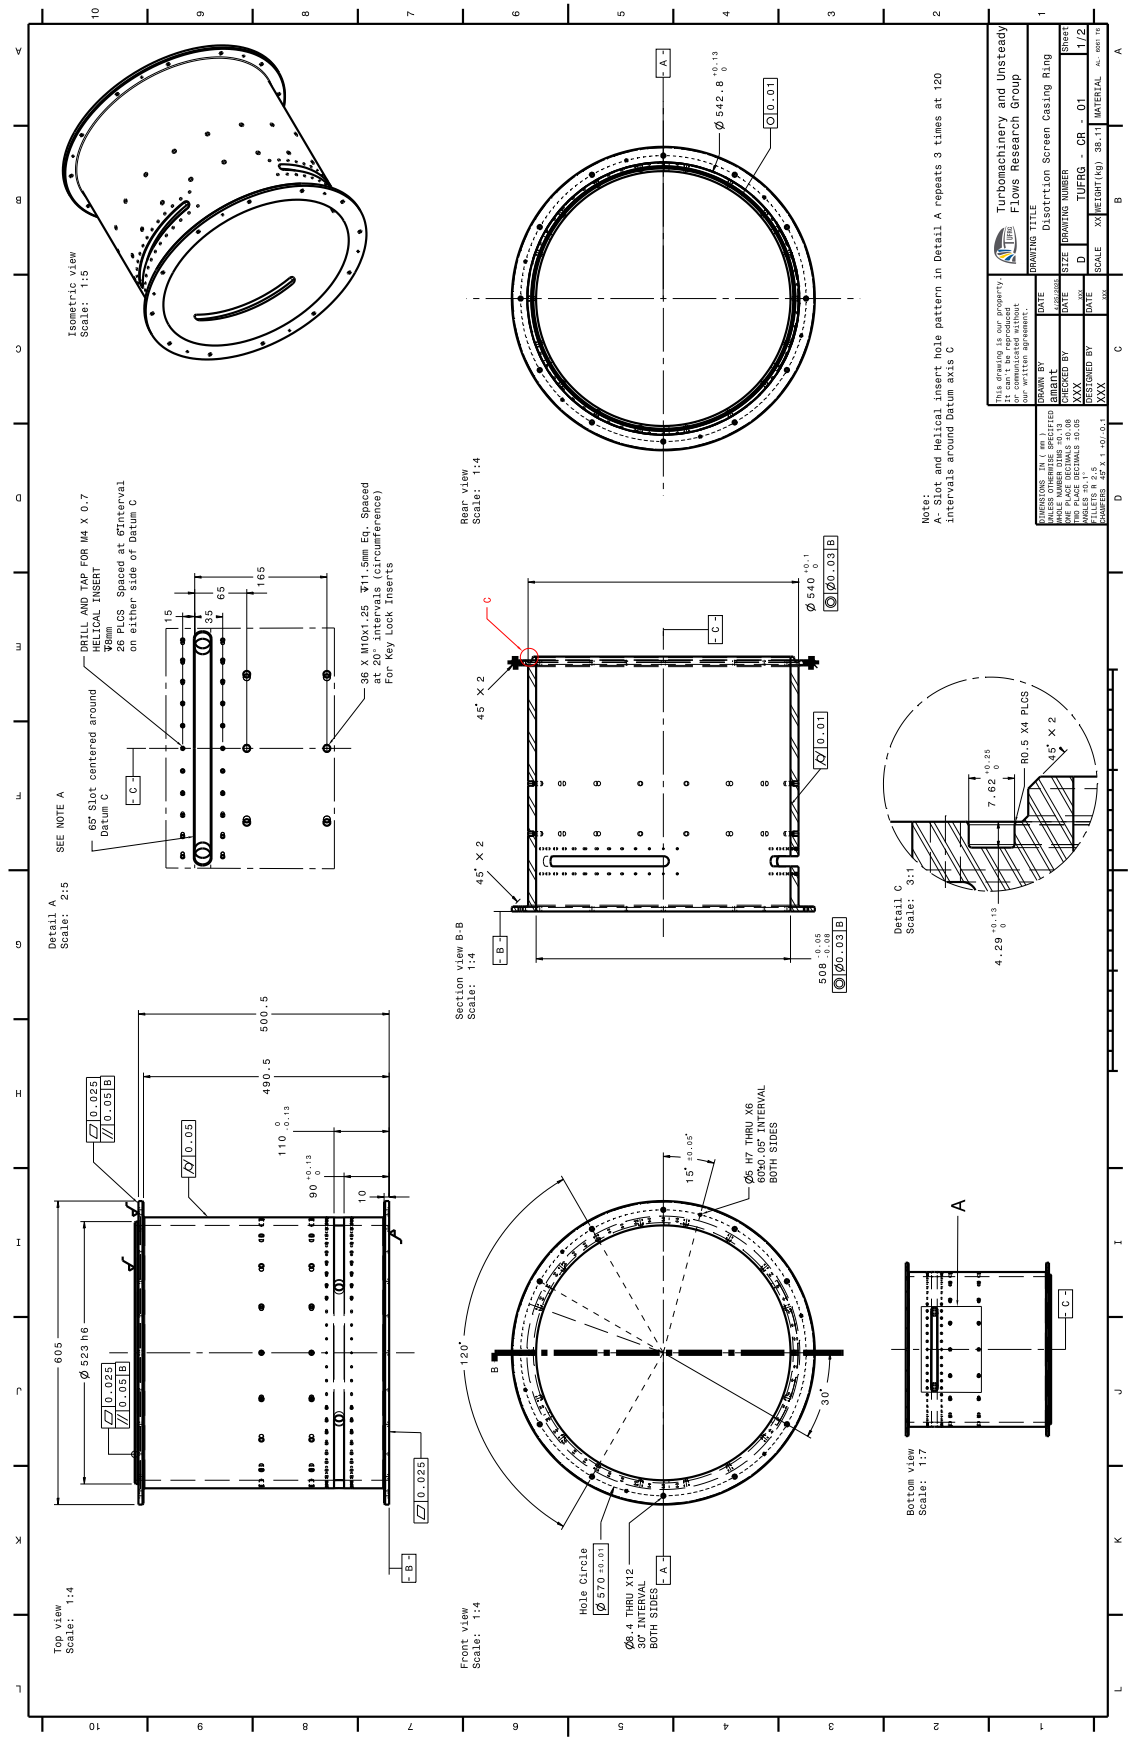
[picture p23: page 1]

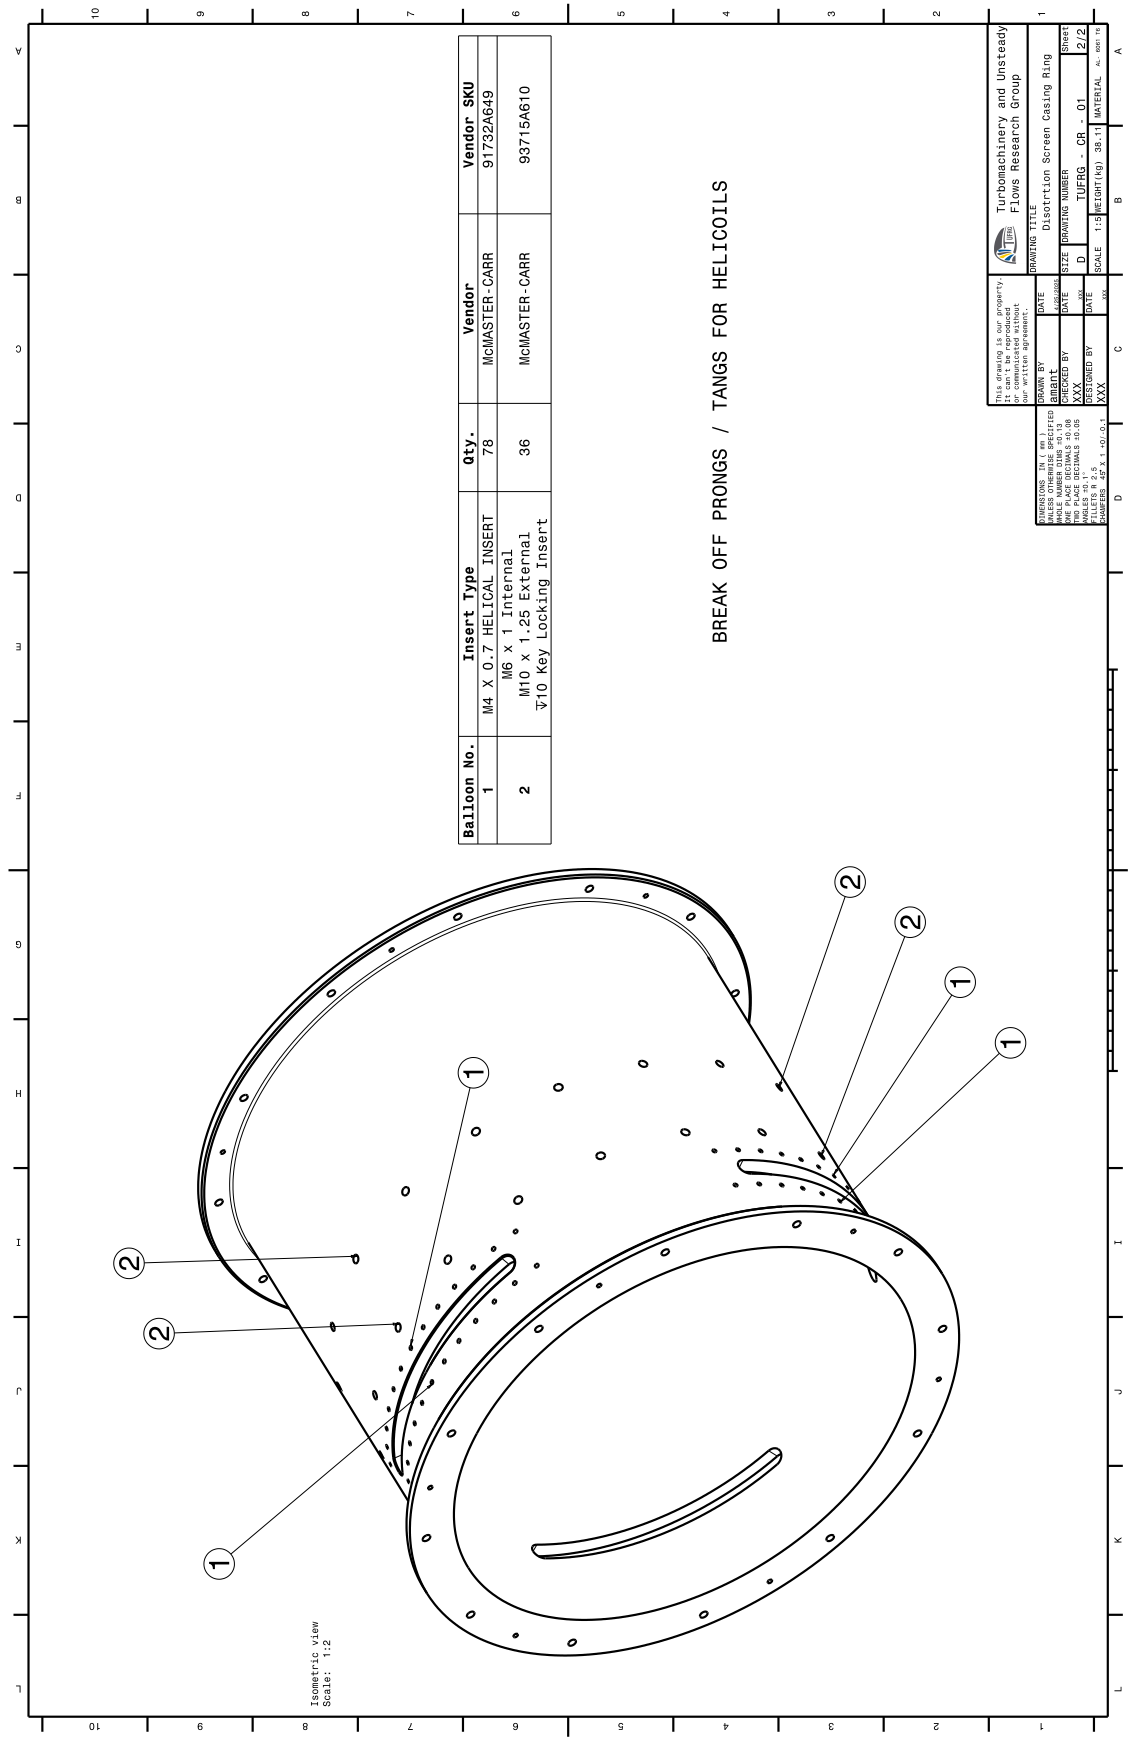
[picture p24: page 2]
