TUFRG/LSF-Rig-GT2026-176284/Engineering Drawings/10-HELICAL RACK.pdf

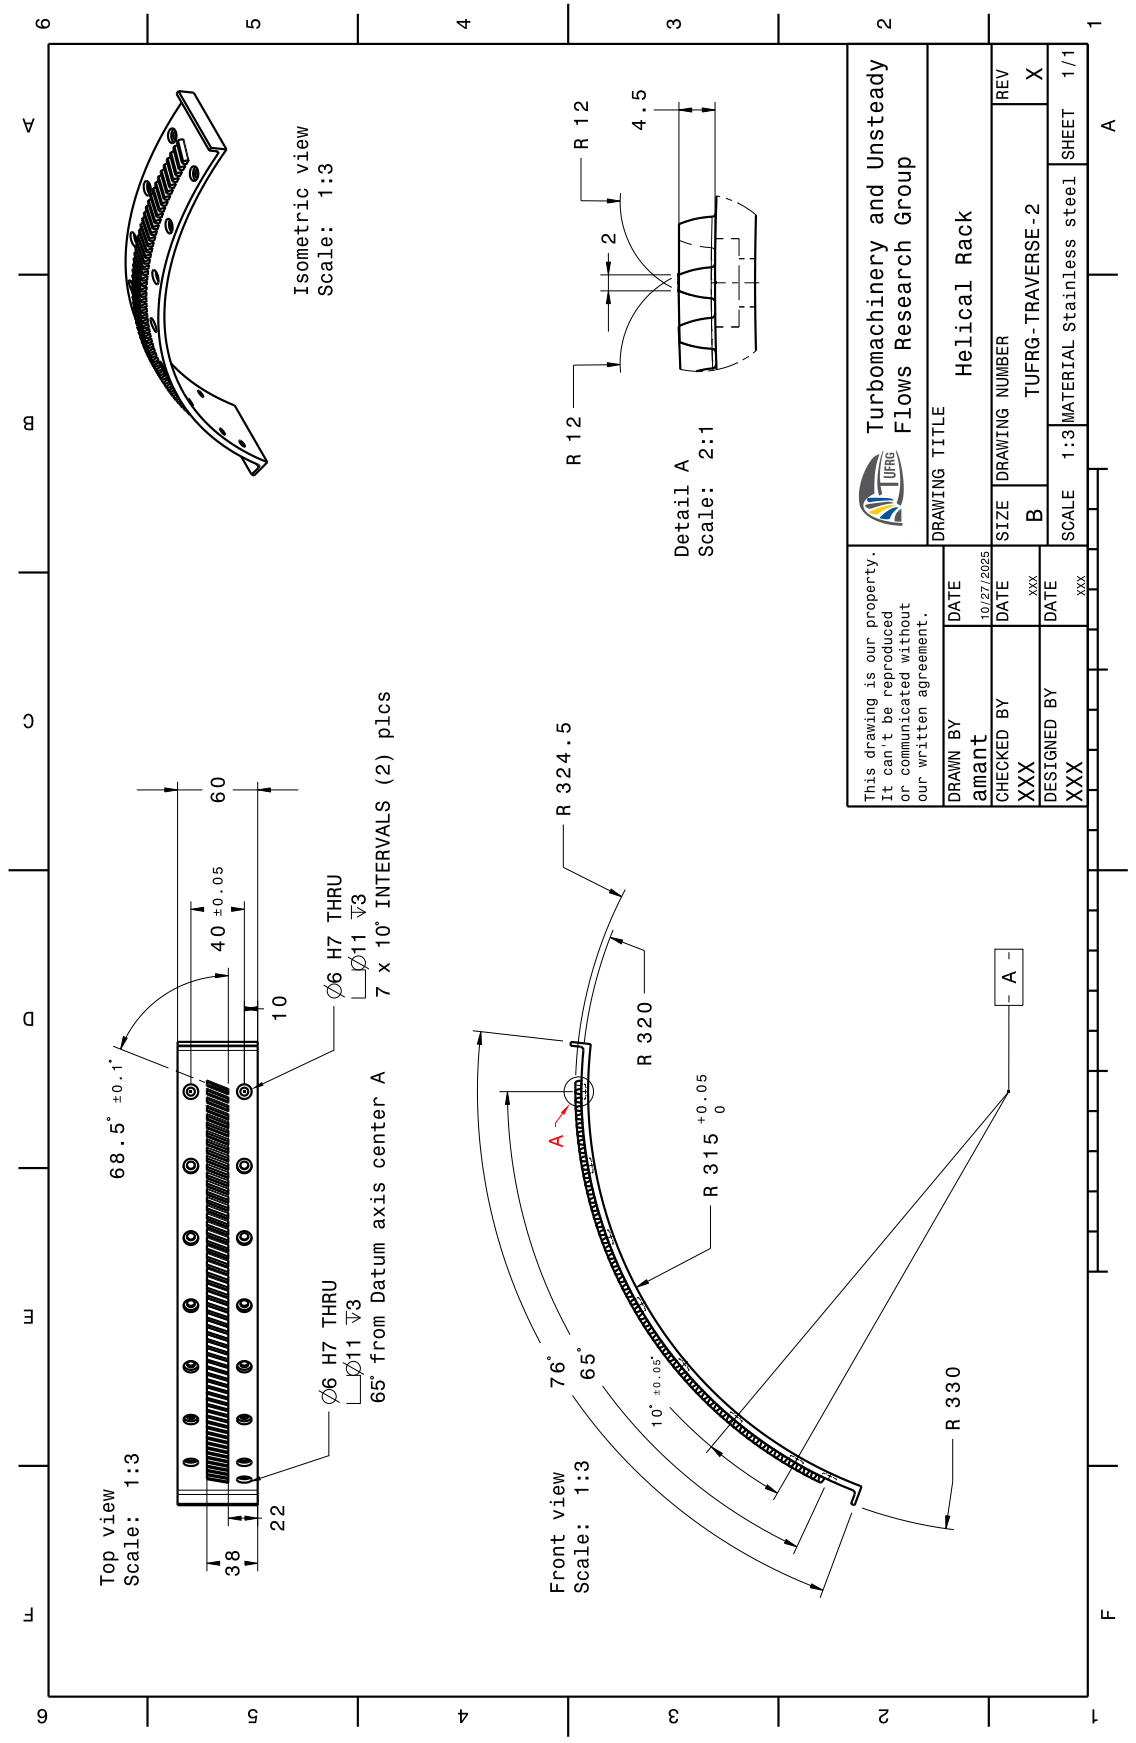
[picture p25: page 1]
