TUFRG/LSF-Rig-GT2026-176284/Engineering Drawings/11-TRAVERSE SLIDING RING.pdf

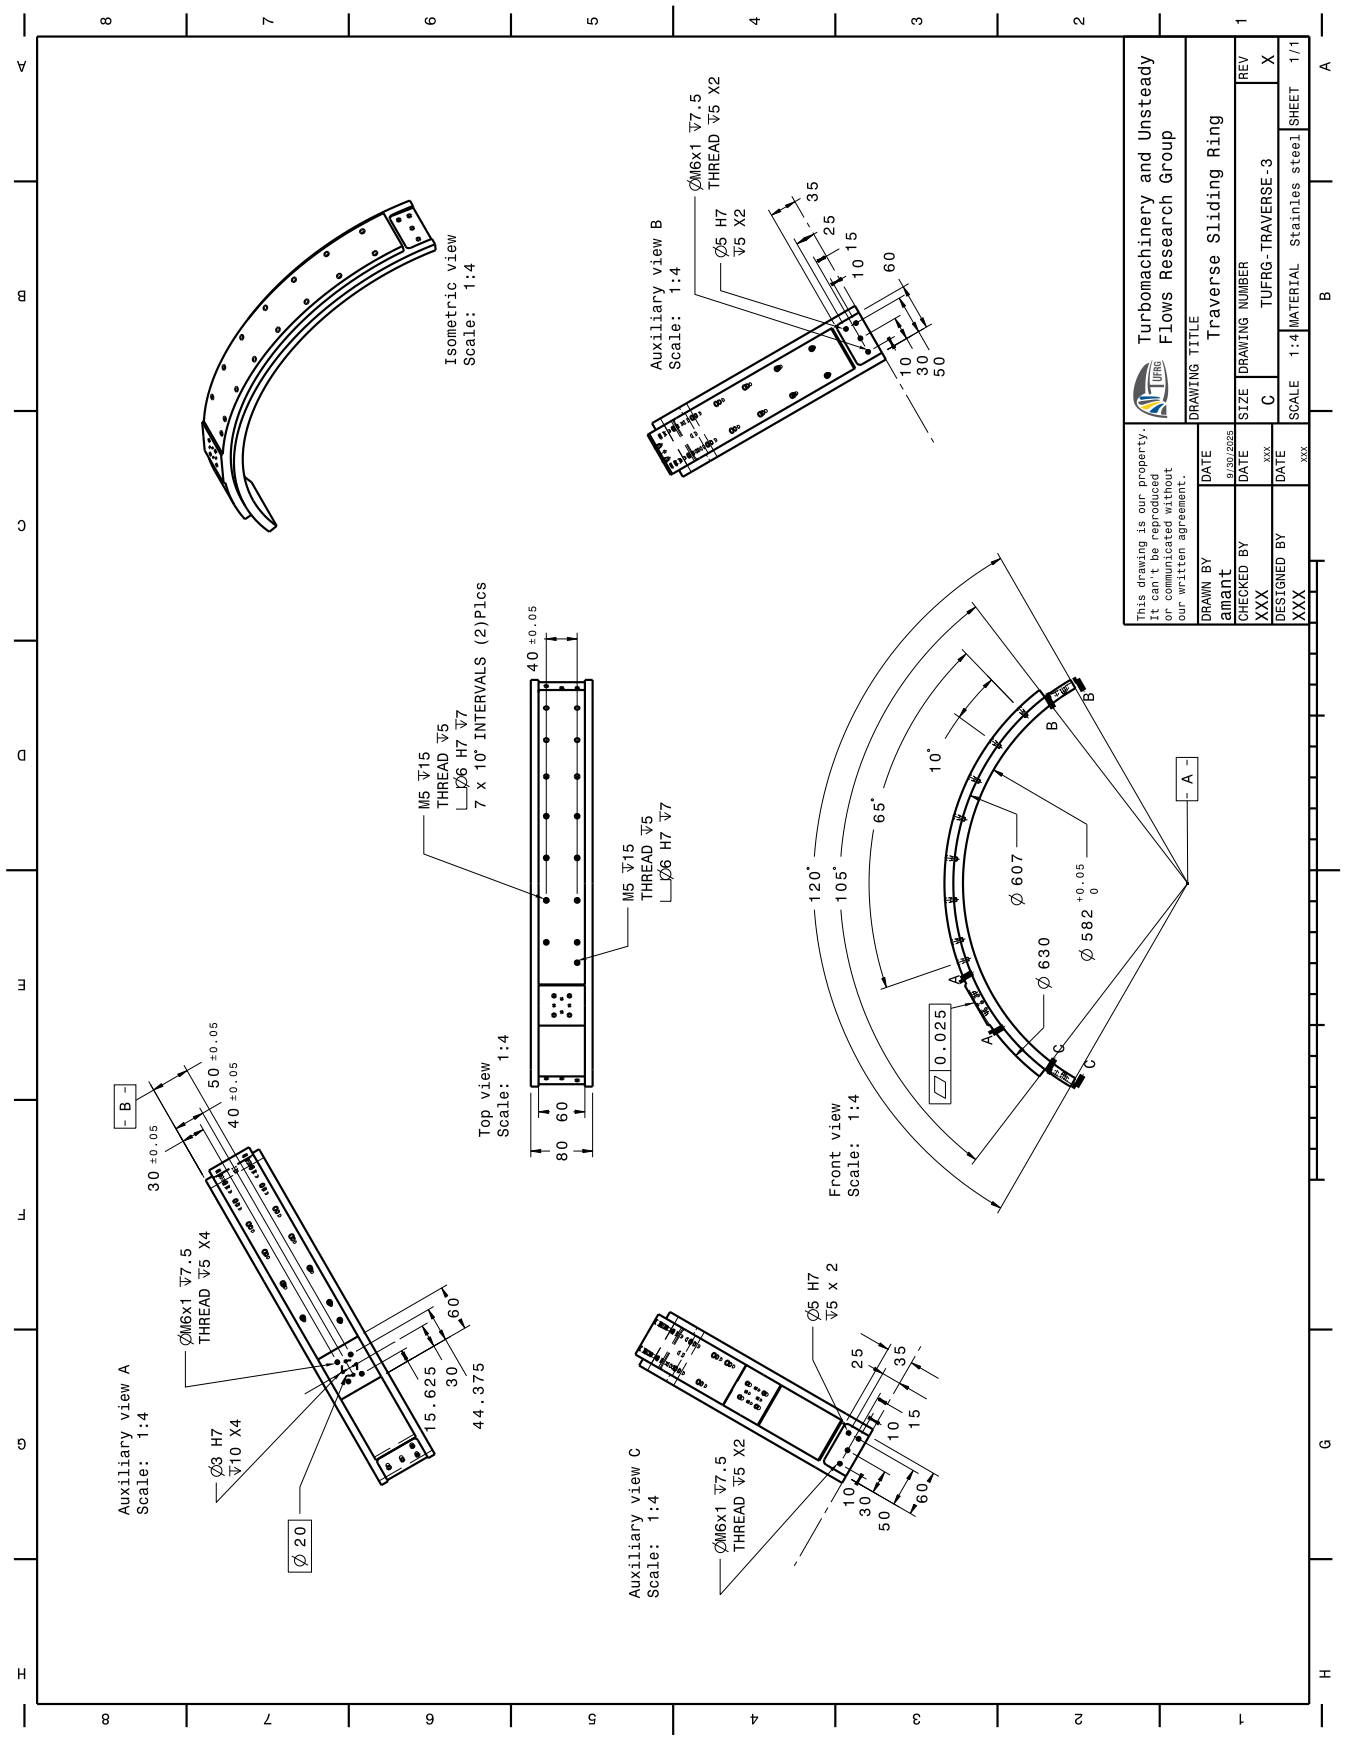
[picture p26: page 1]
