TUFRG/LSF-Rig-GT2026-176284/Engineering Drawings/13-Rotor Hub Abradable.pdf

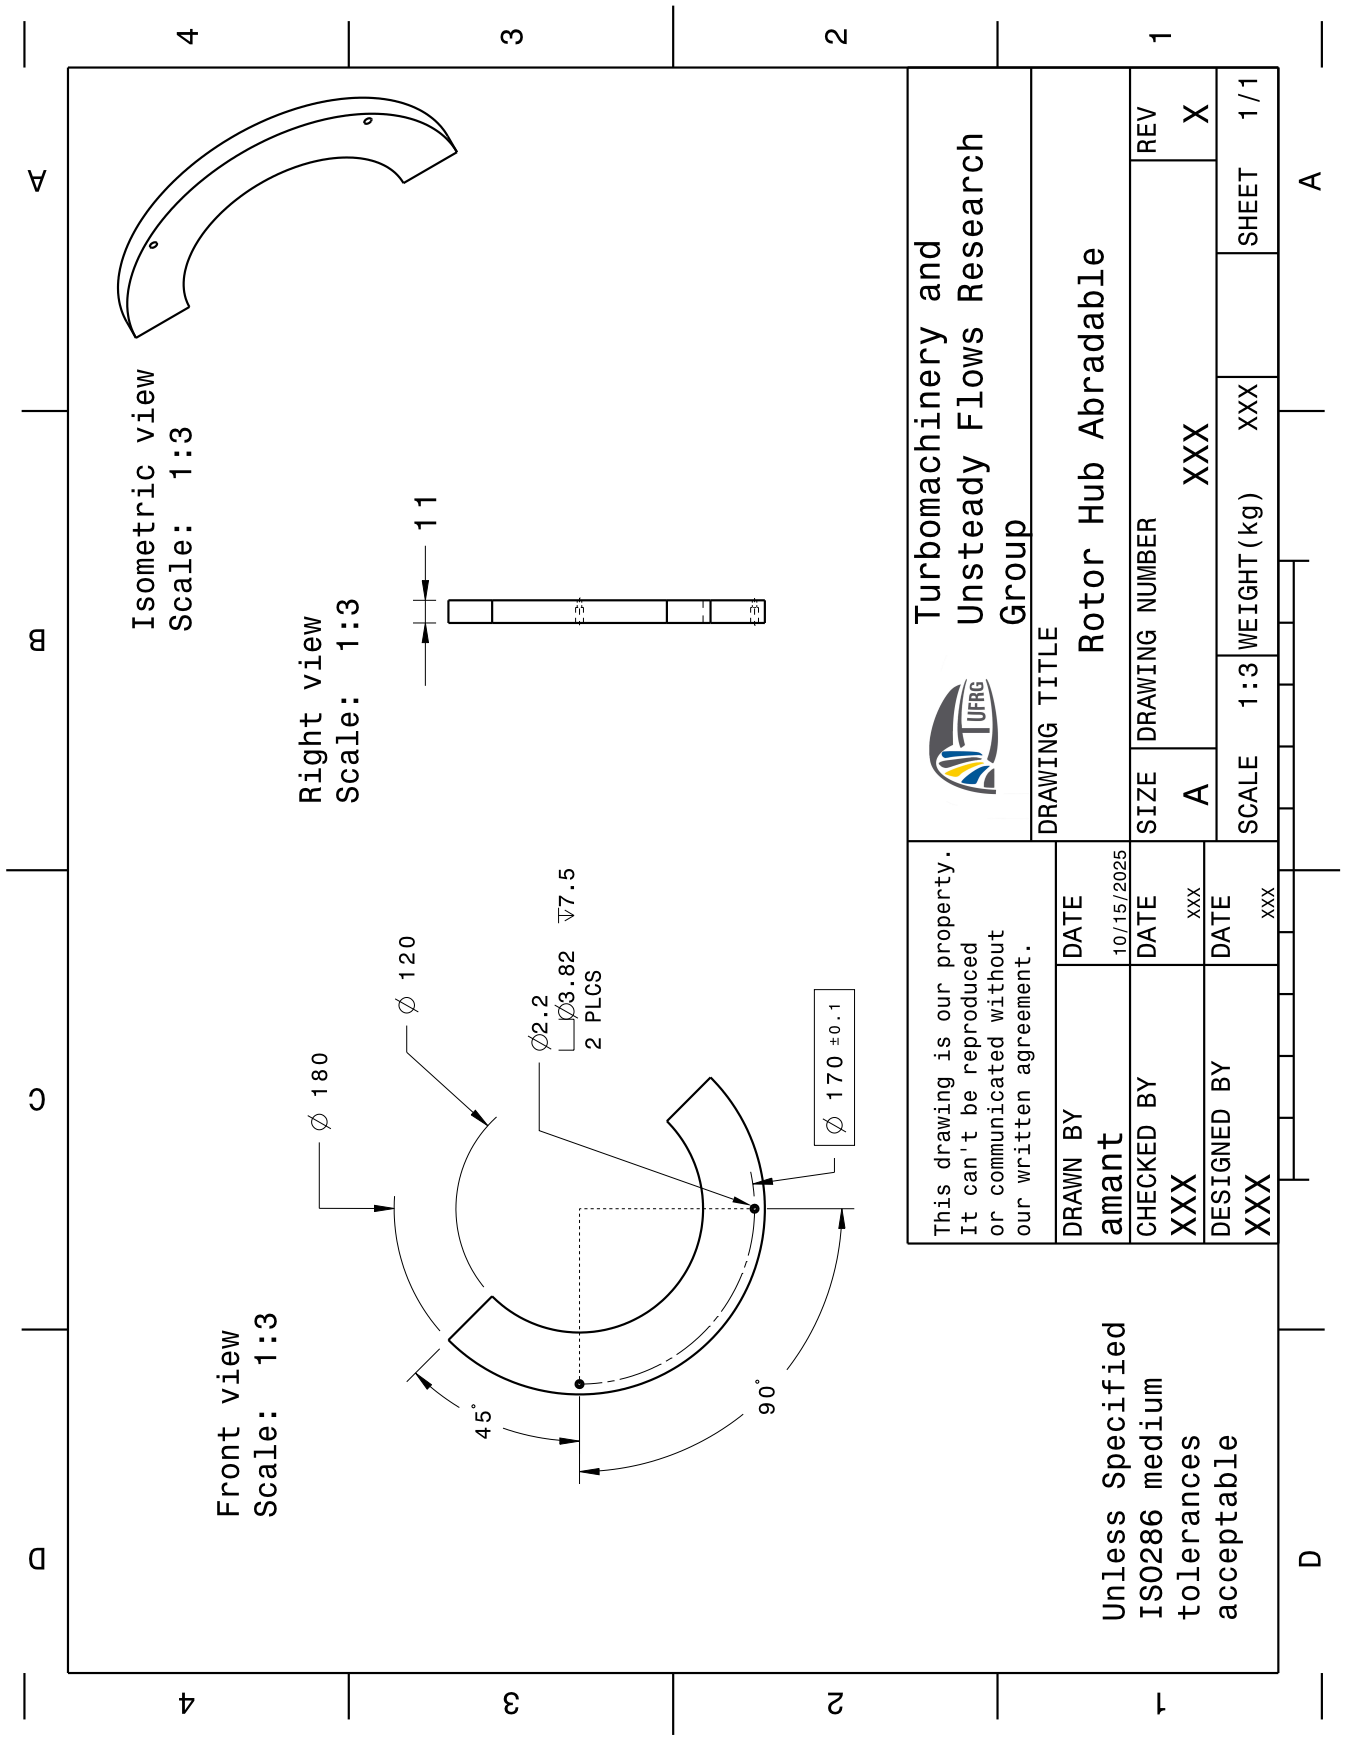
[picture p27: page 1]
