TUFRG/LSF-Rig-GT2026-176284/Engineering Drawings/14-Strut Hub Abradable.pdf

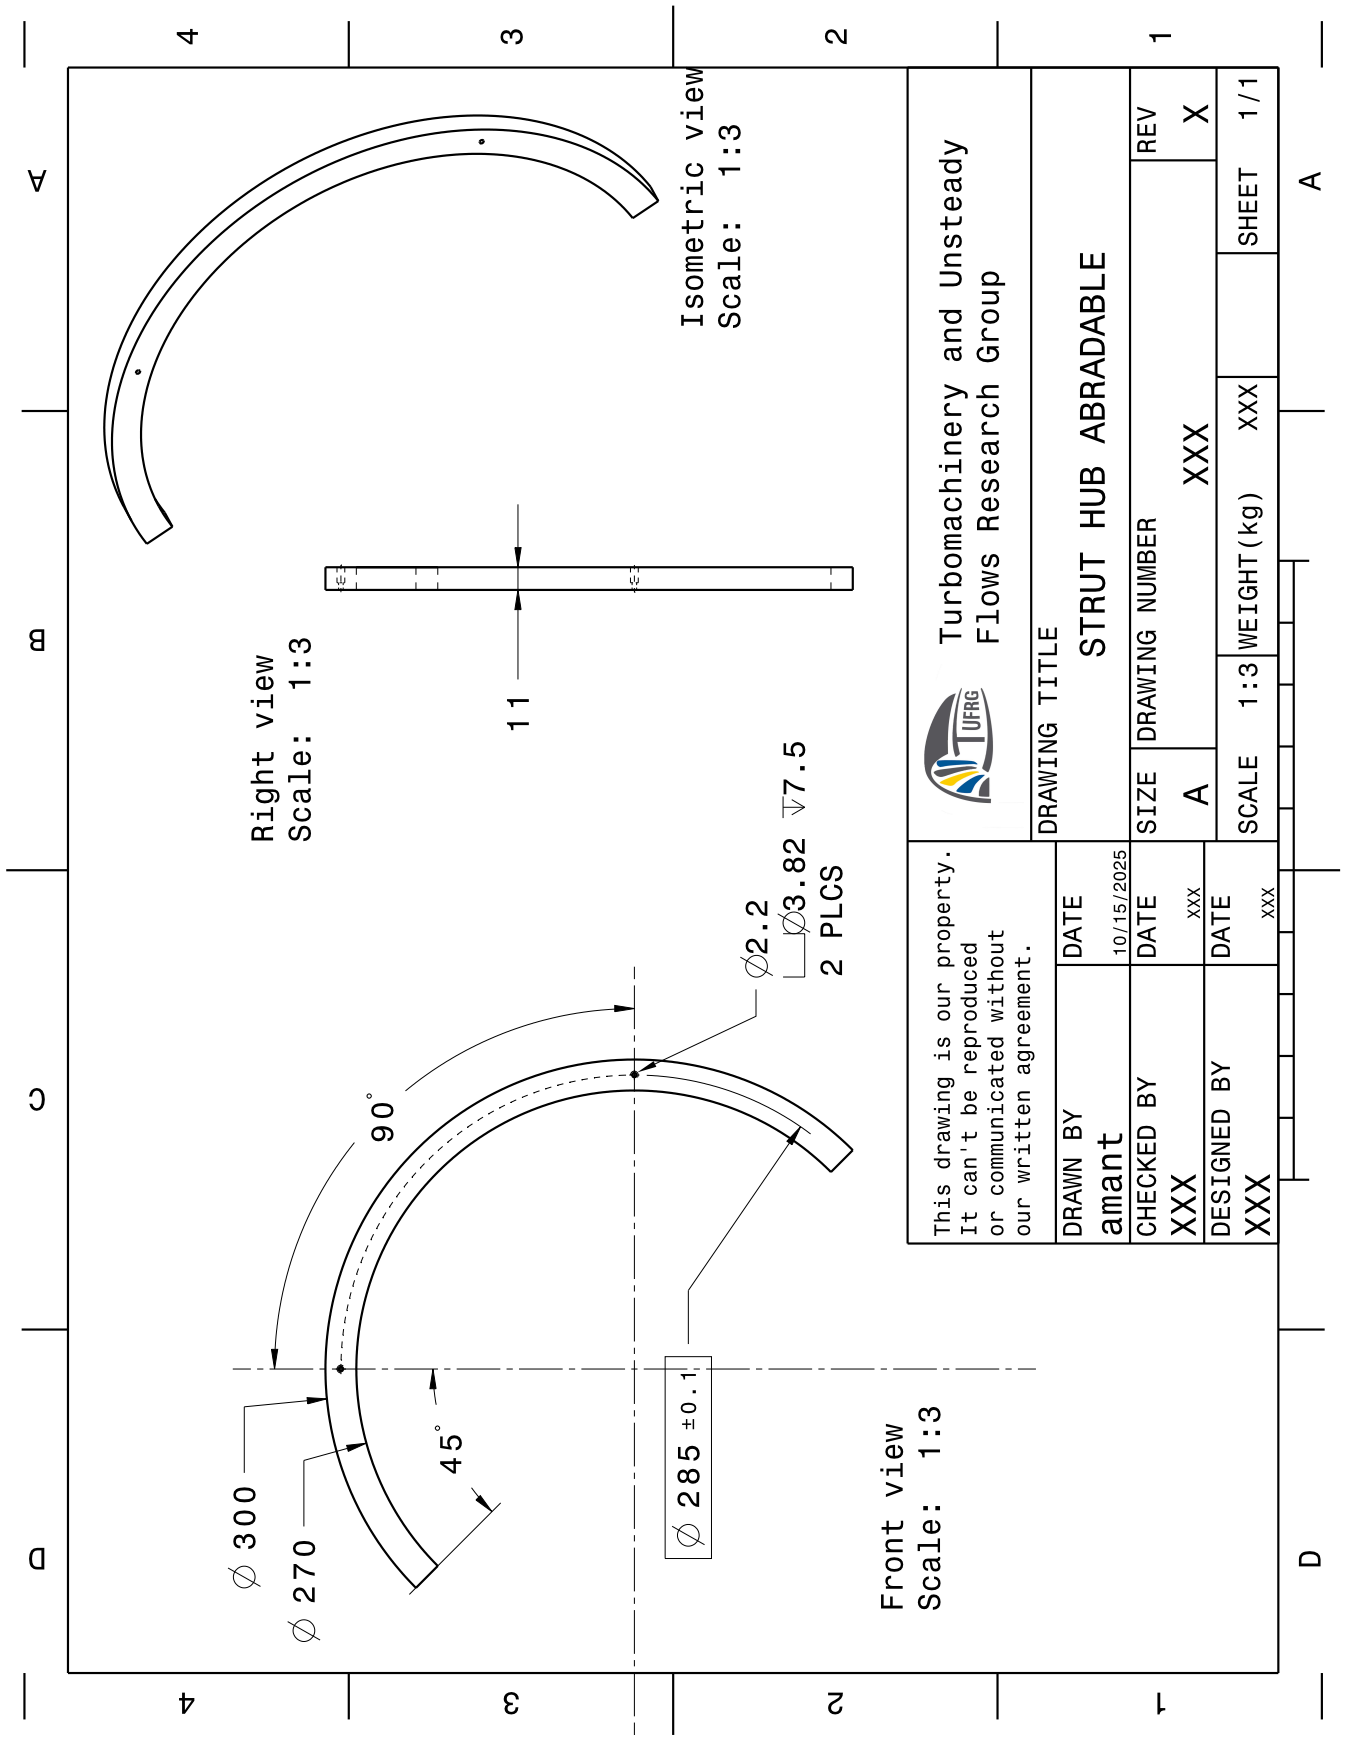
[picture p28: page 1]
