TUFRG/LSF-Rig-GT2026-176284/Engineering Drawings/15-Upstream Traverse Plugs.pdf

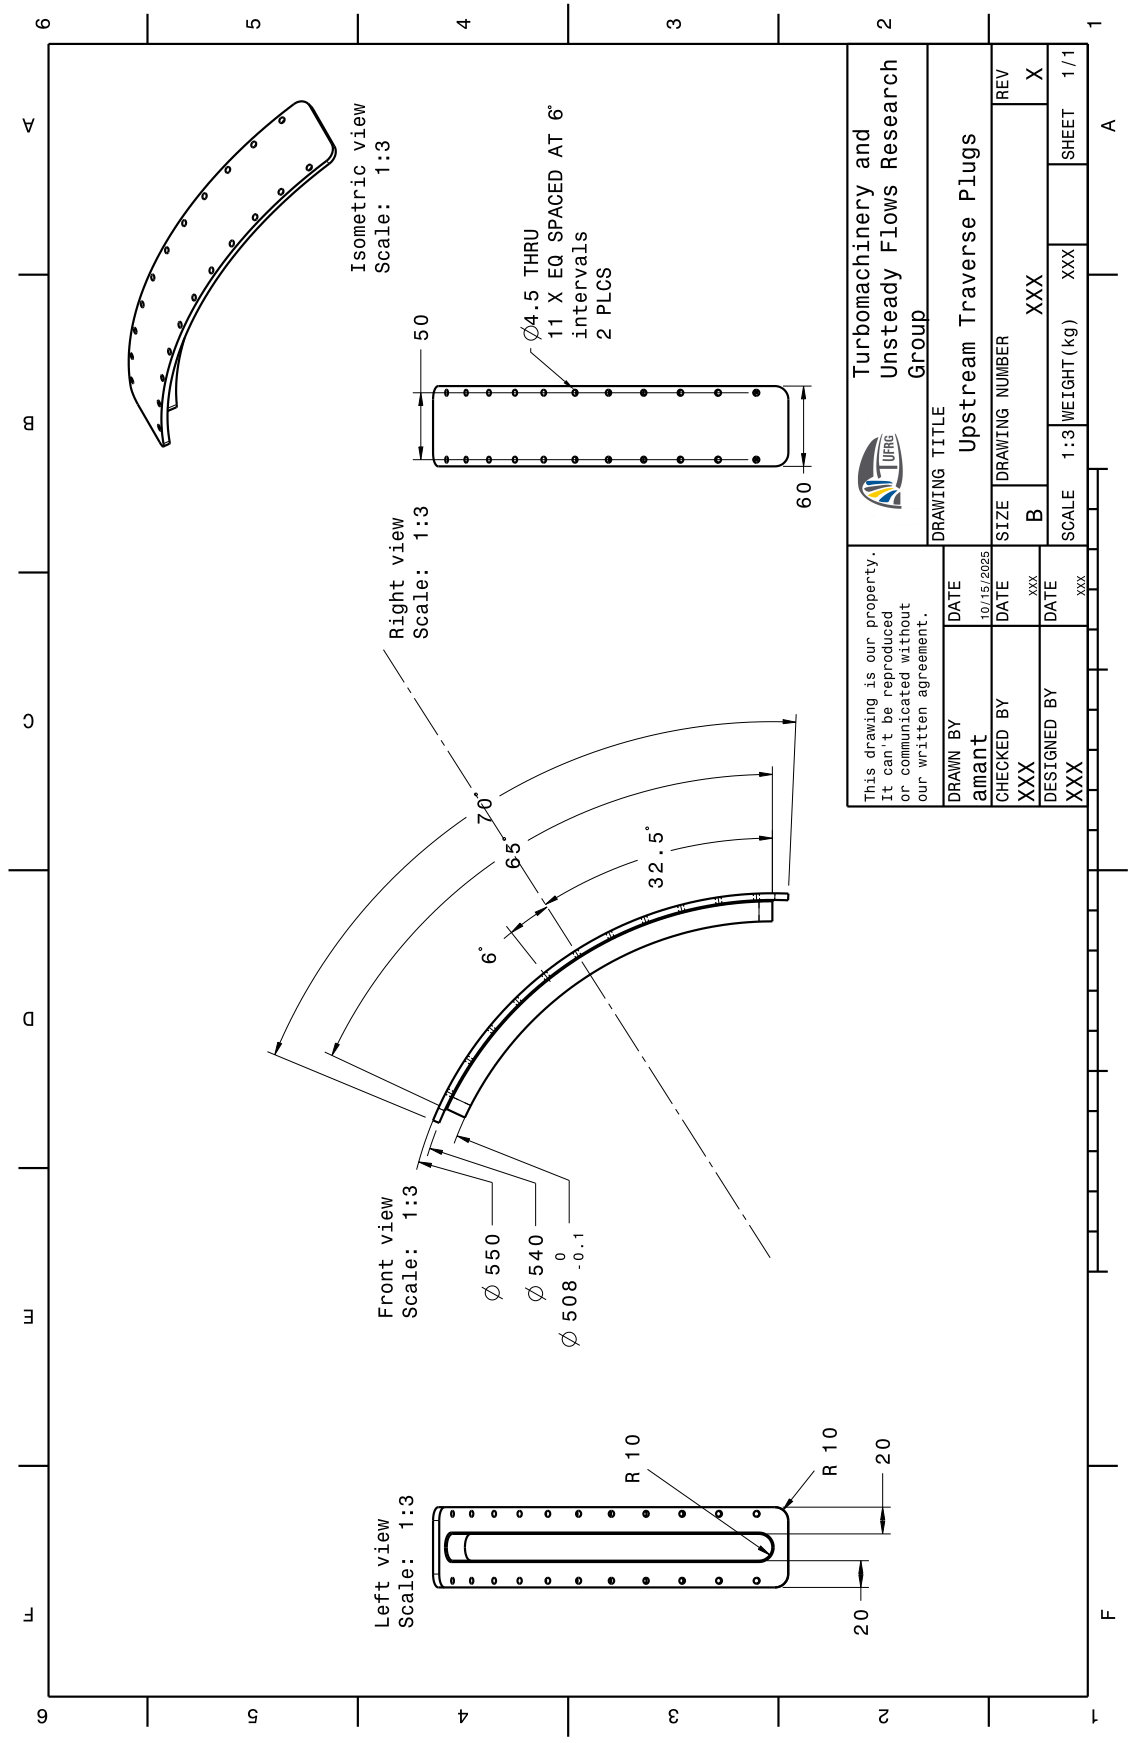
[picture p29: page 1]
