TUFRG/LSF-Rig-GT2026-176284/Engineering Drawings/16-Downstream Traverse Plugs.pdf

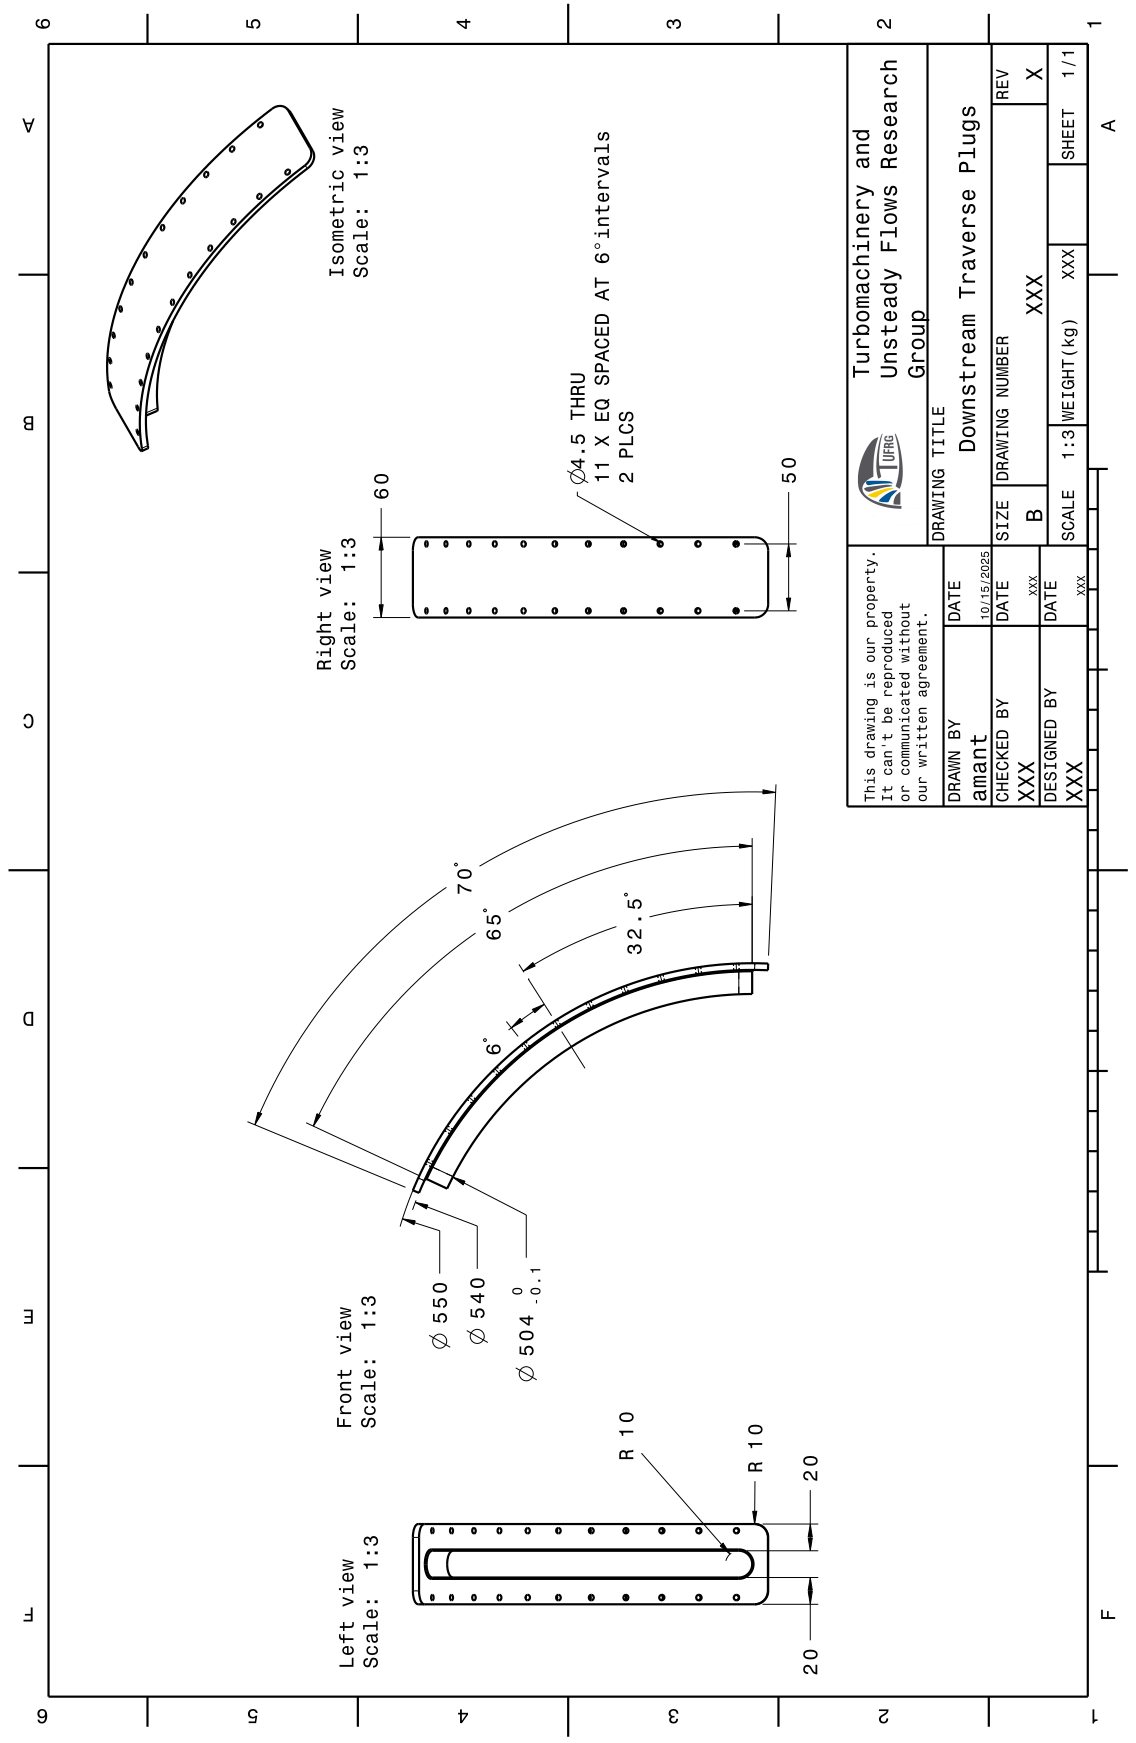
[picture p30: page 1]
