TUFRG/LSF-Rig-GT2026-176284/Engineering Drawings/2- ROTOR CASING RING.pdf

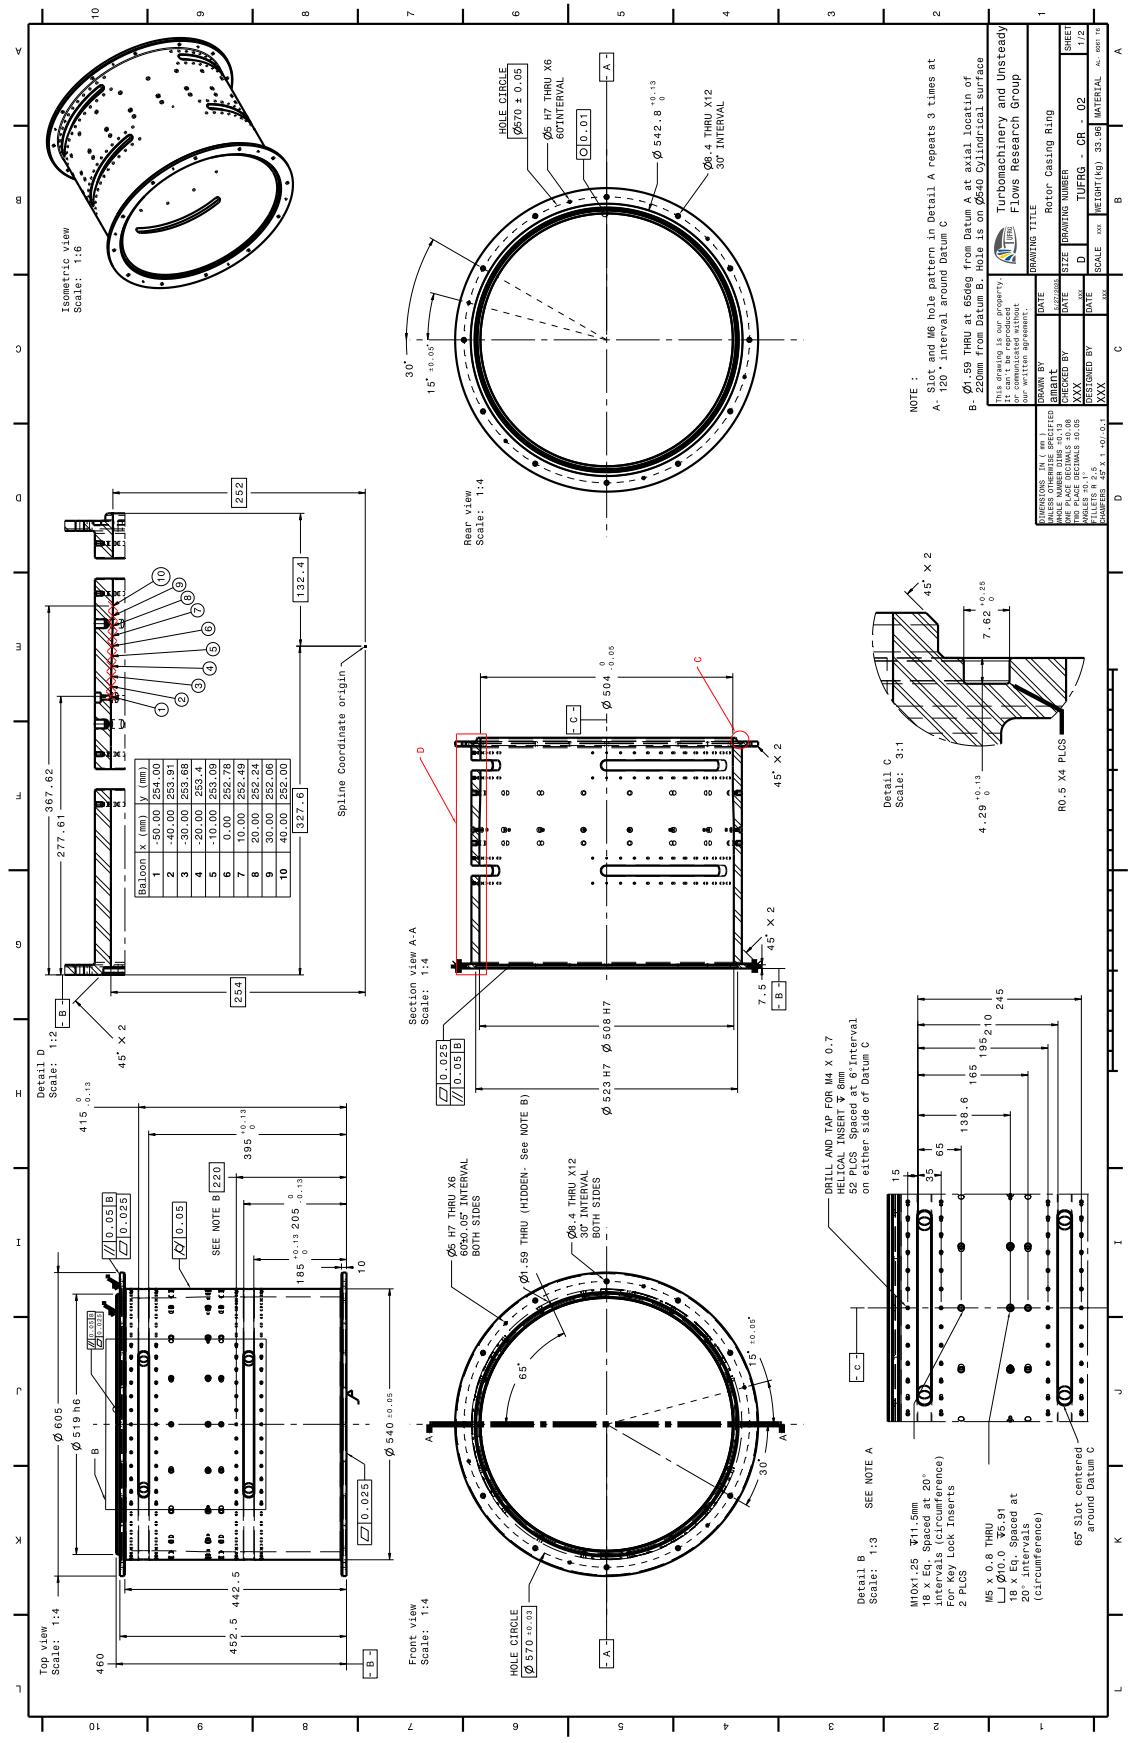
[picture p31: page 1]

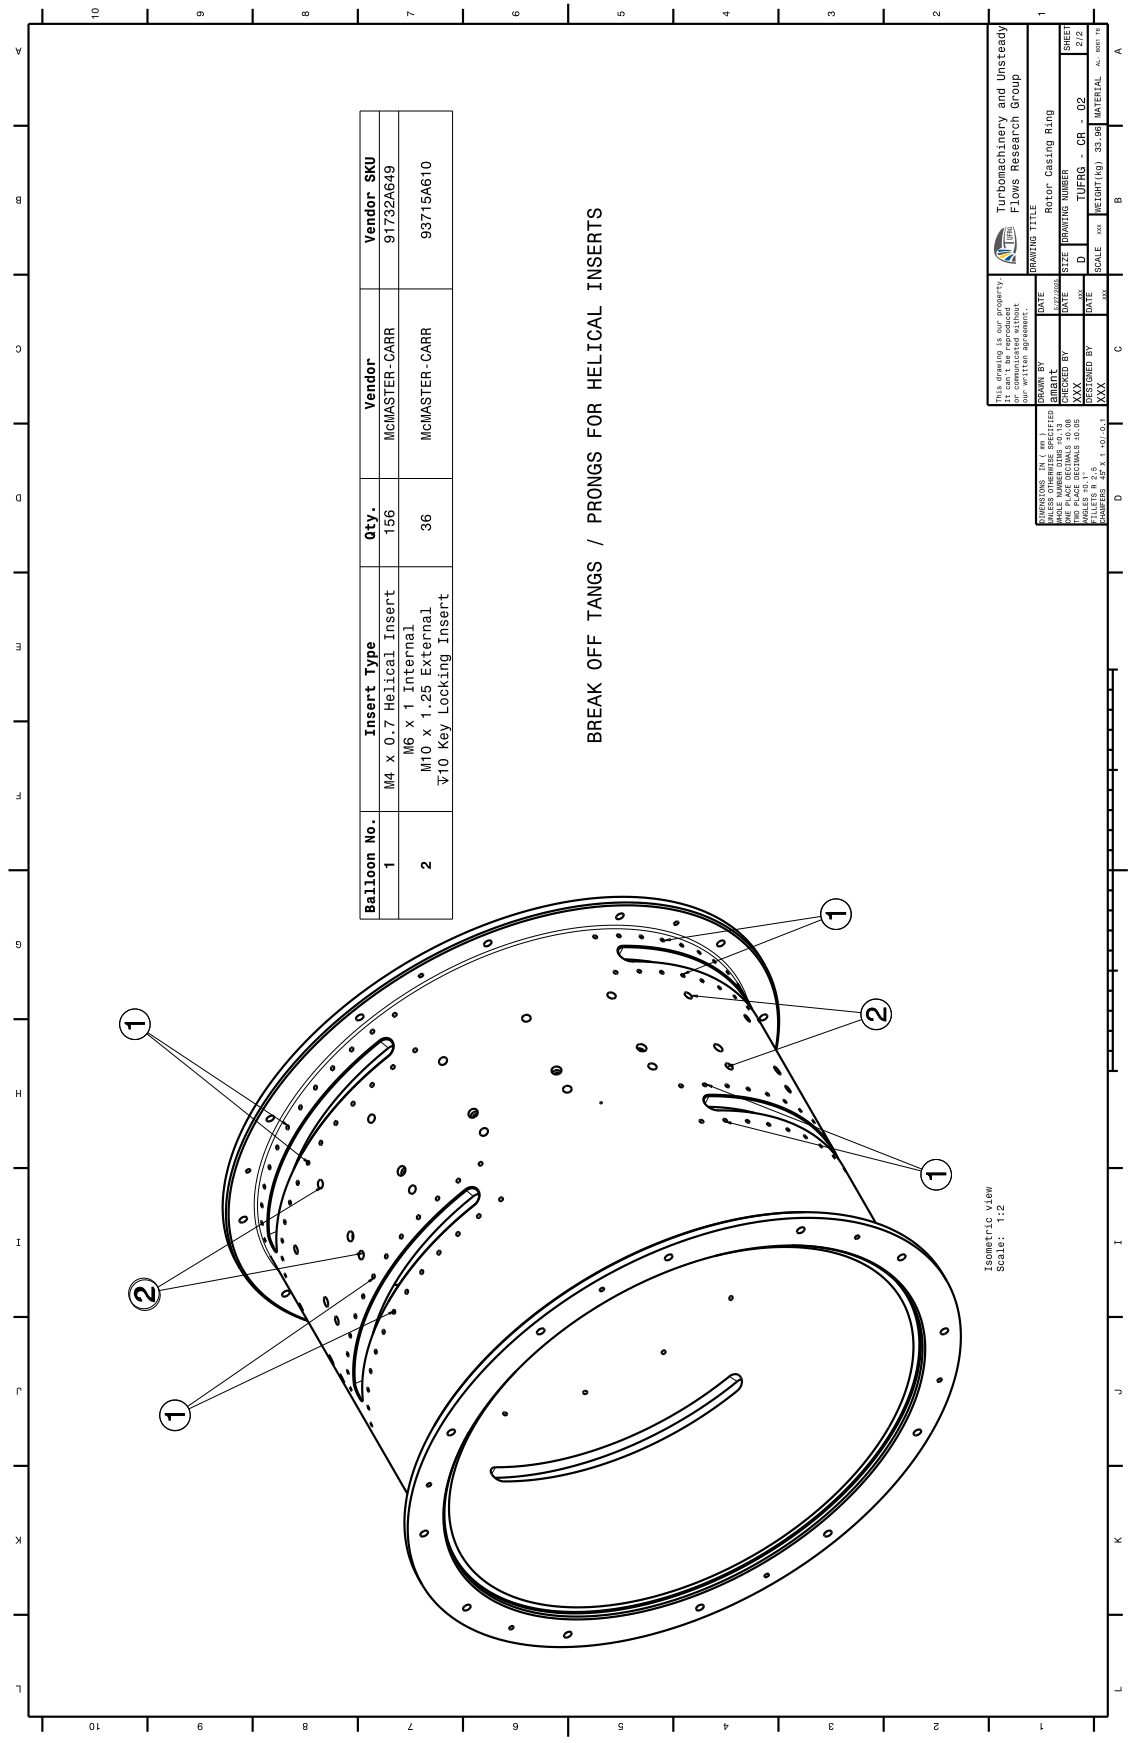
[picture p32: page 2]
