TUFRG/LSF-Rig-GT2026-176284/Engineering Drawings/3-STATOR CASING RING.pdf

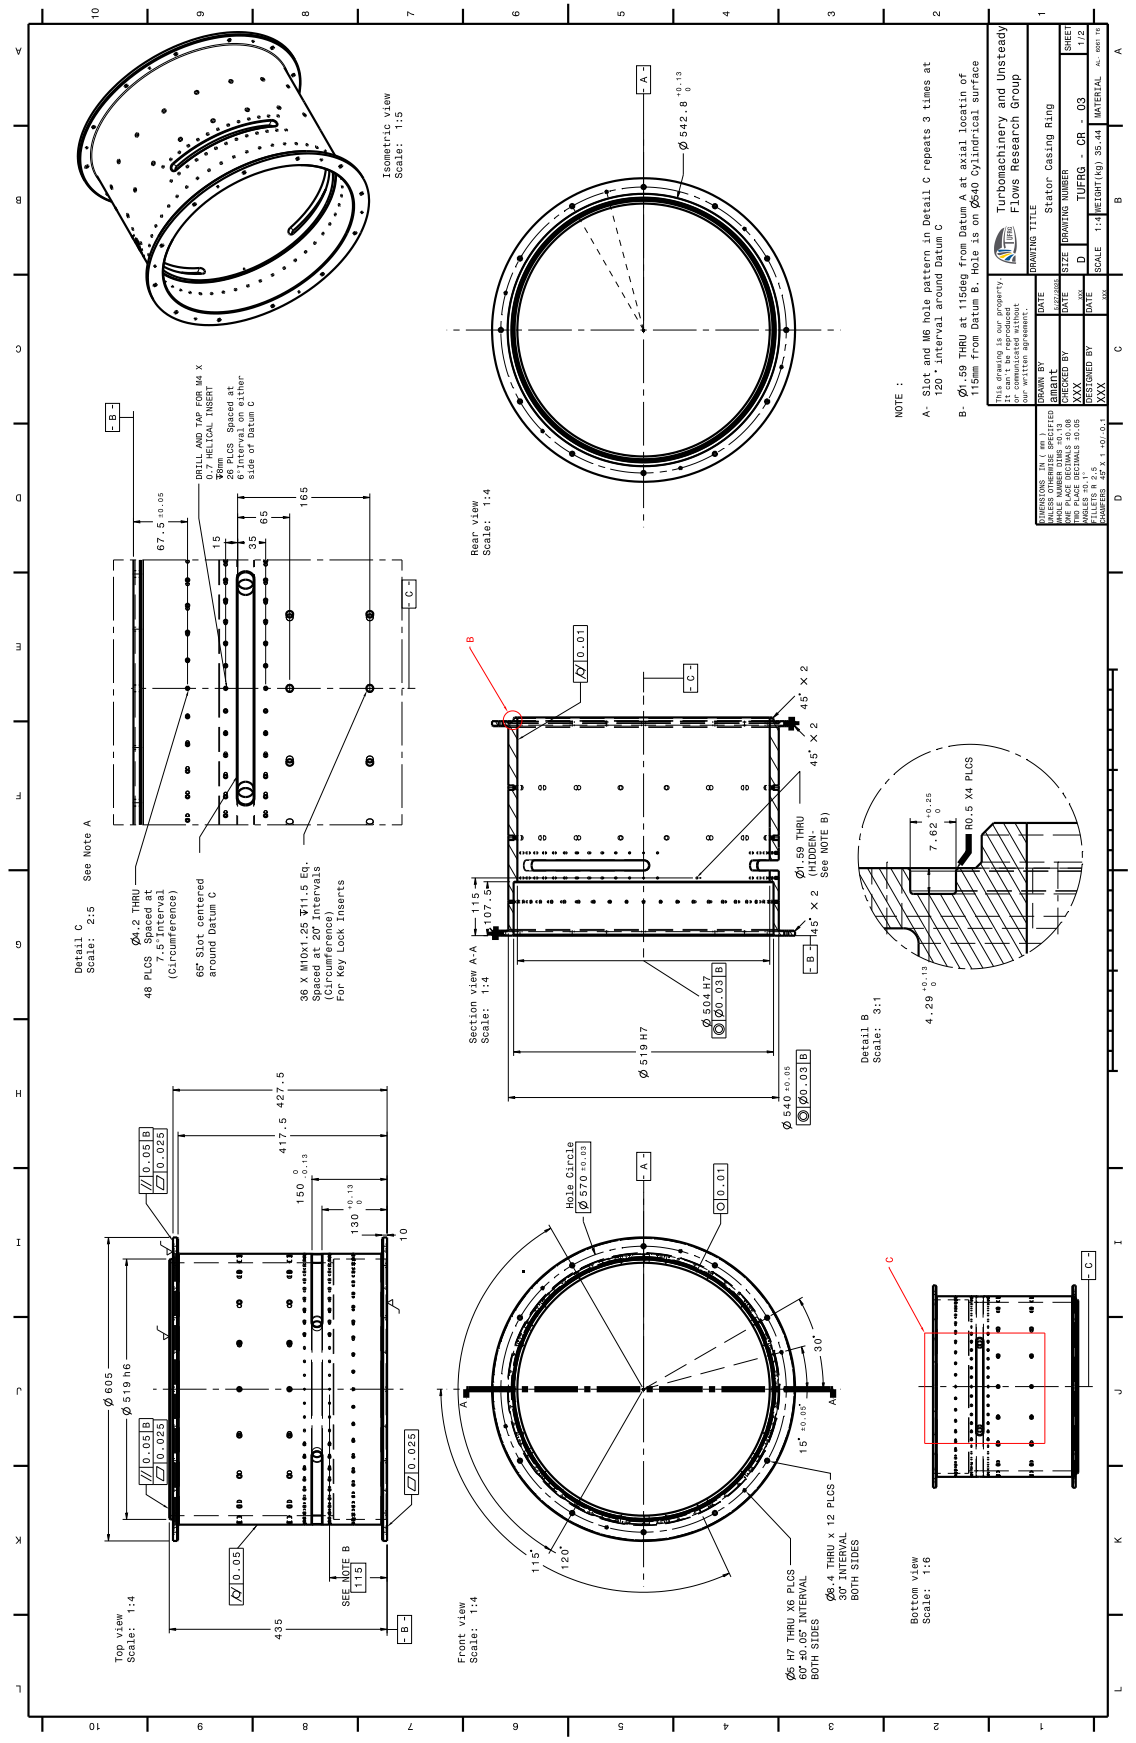
[picture p33: page 1]

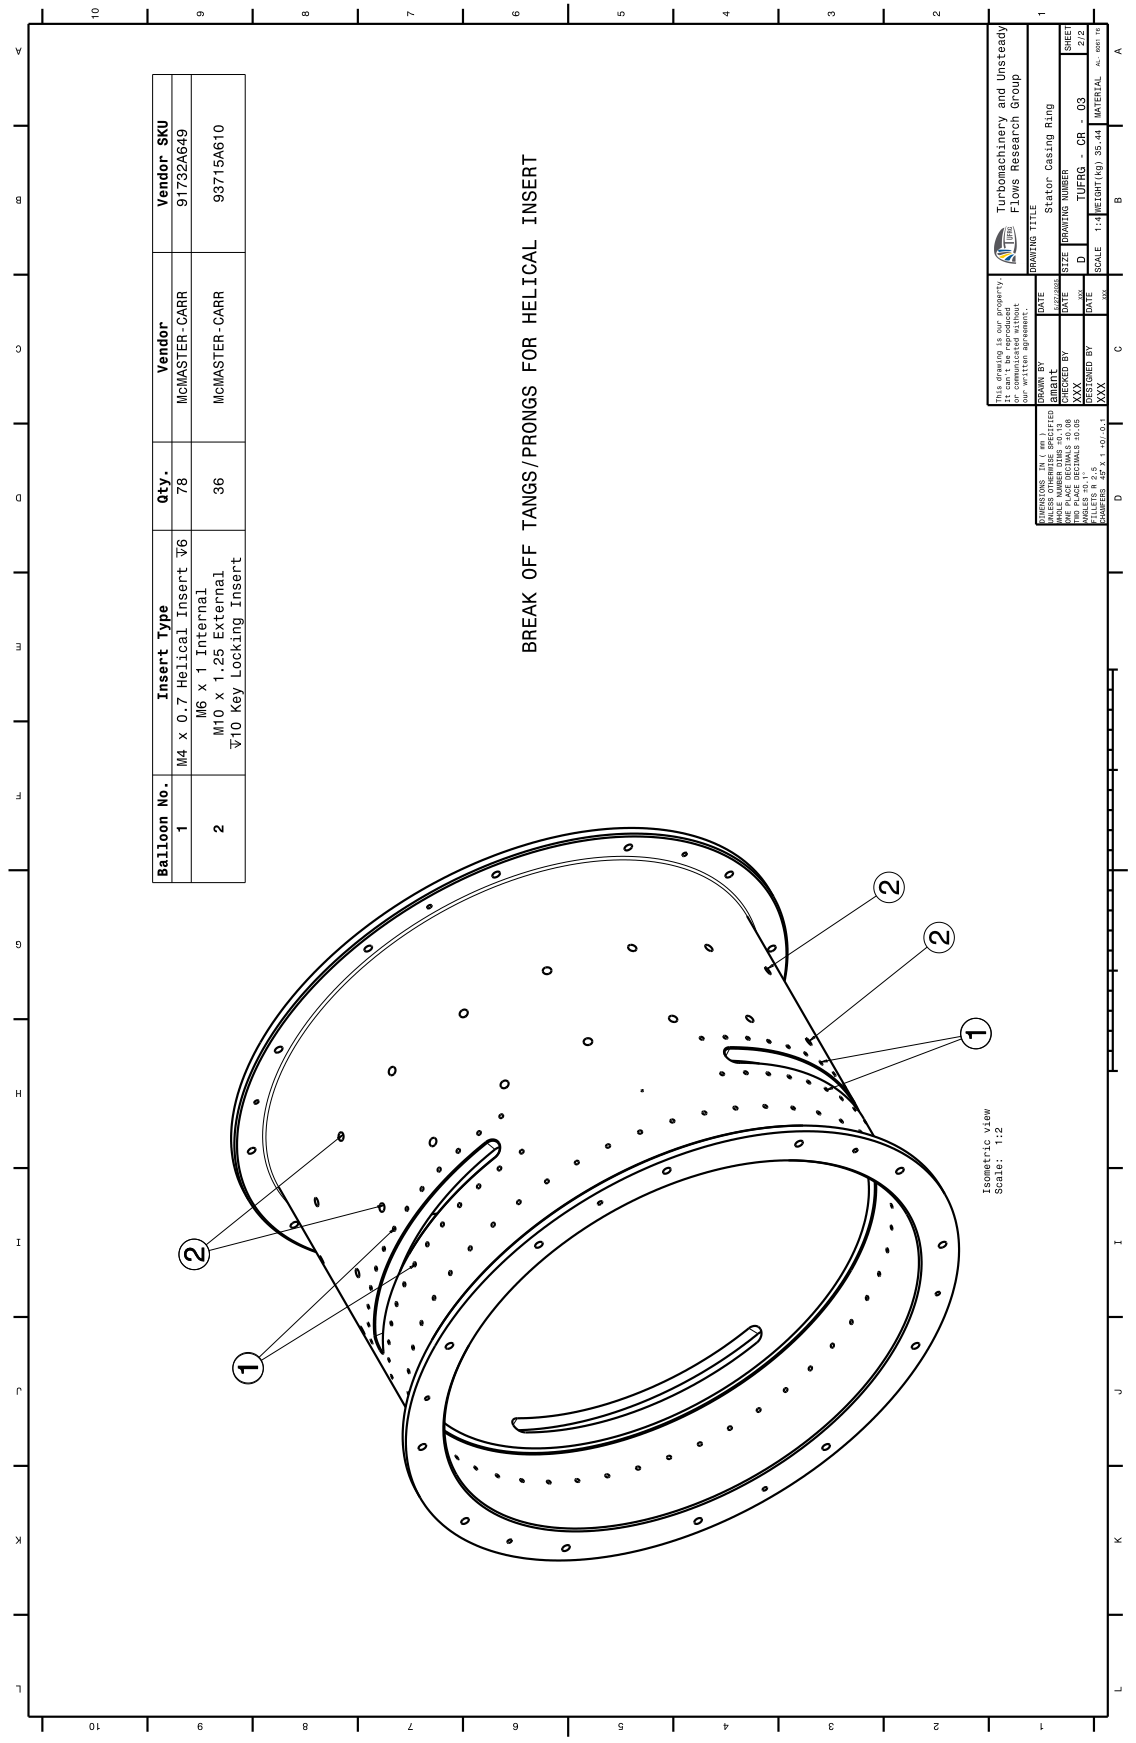
[picture p34: page 2]
