TUFRG/LSF-Rig-GT2026-176284/Engineering Drawings/6-SPINNER NOSE.pdf

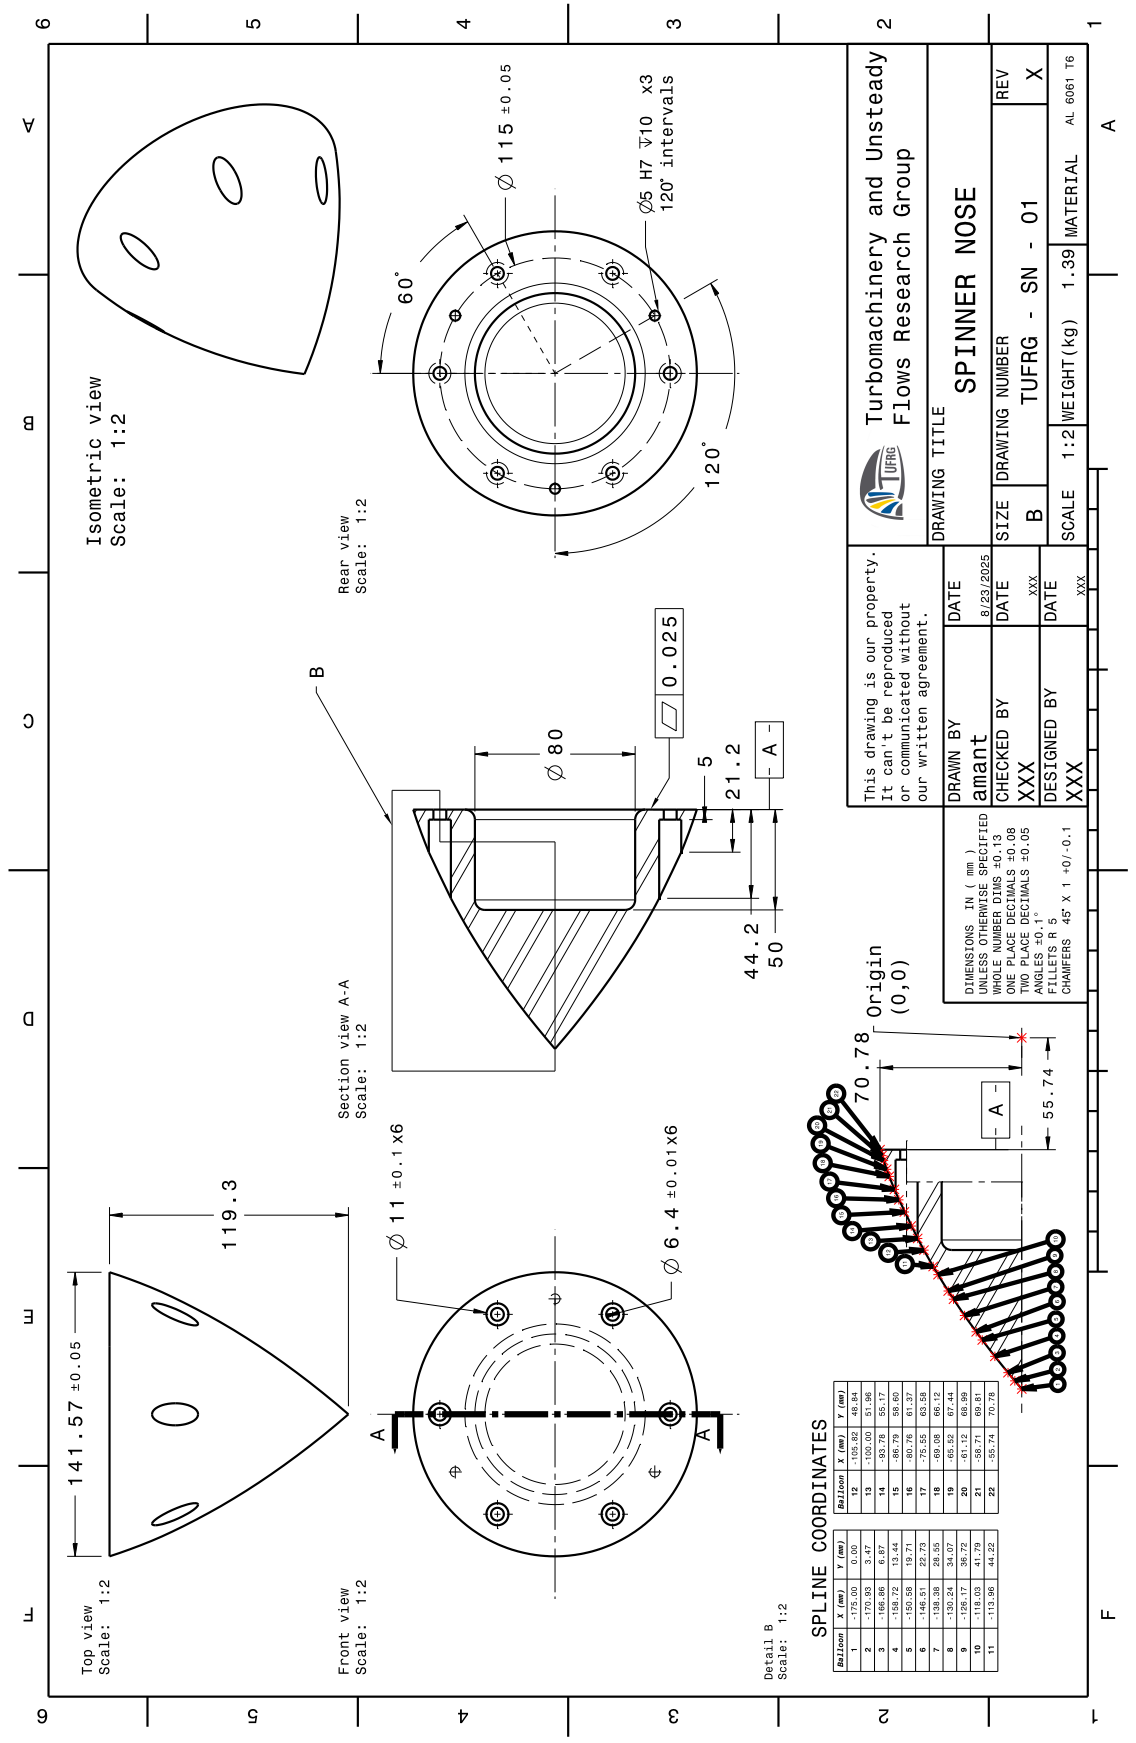
[picture p35: page 1]
