TUFRG/LSF-Rig-GT2026-176284/Engineering Drawings/8-STATOR SECTOR.pdf

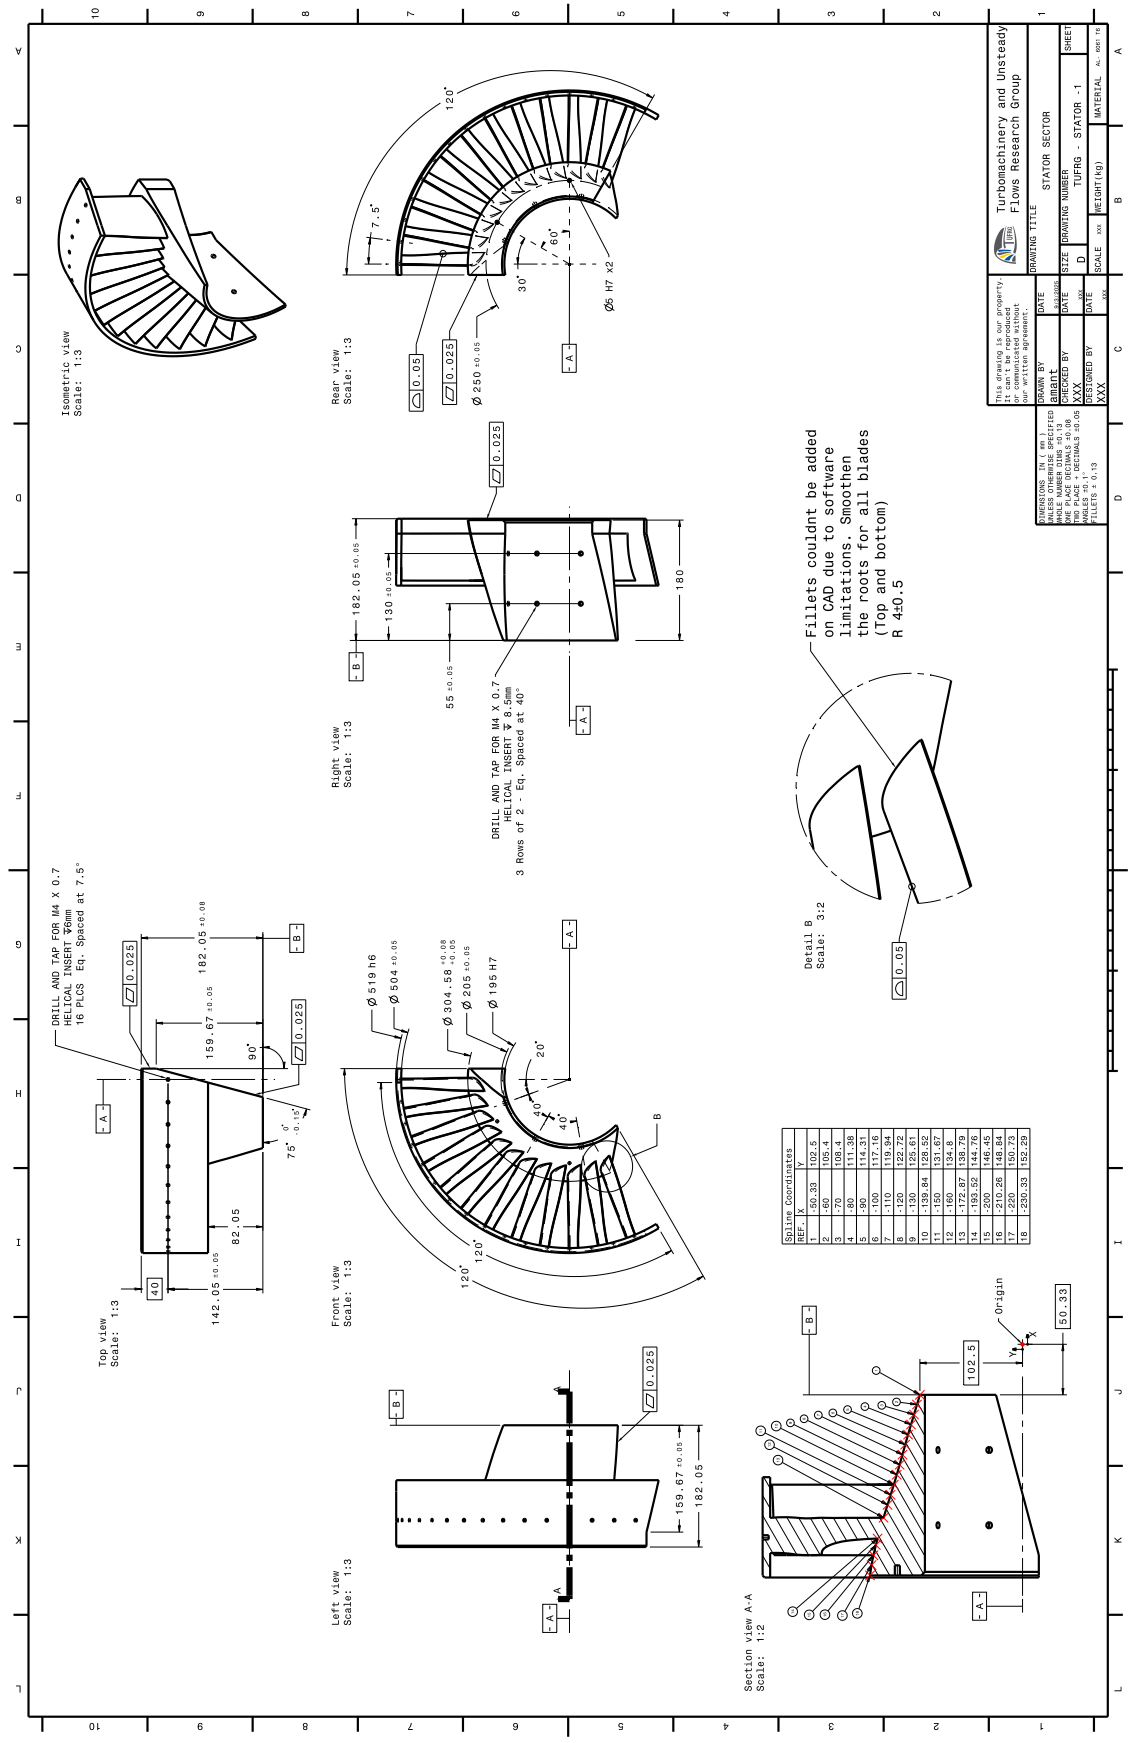
[picture p36: page 1]

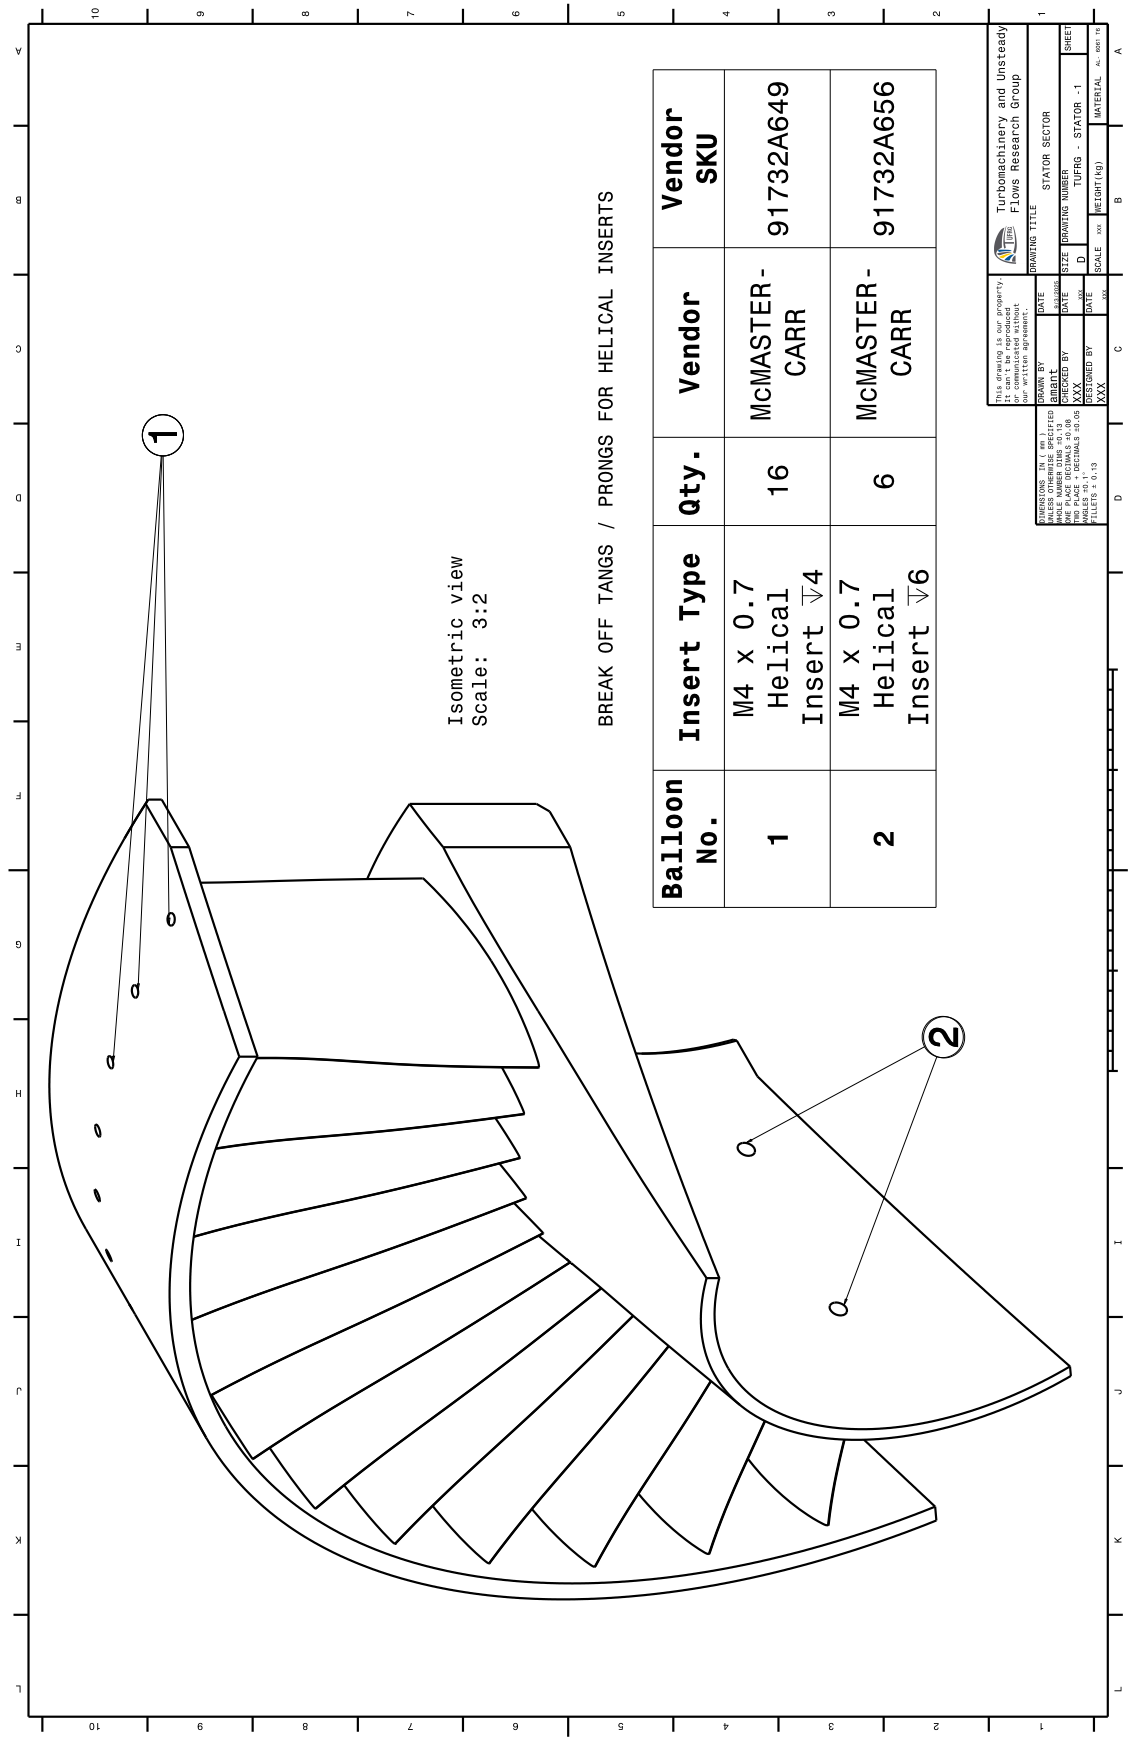
[picture p37: page 2]
