TUFRG/LSF-Rig-GT2026-176284/Engineering Drawings/9-TRAVERSE BASE PLATE.pdf

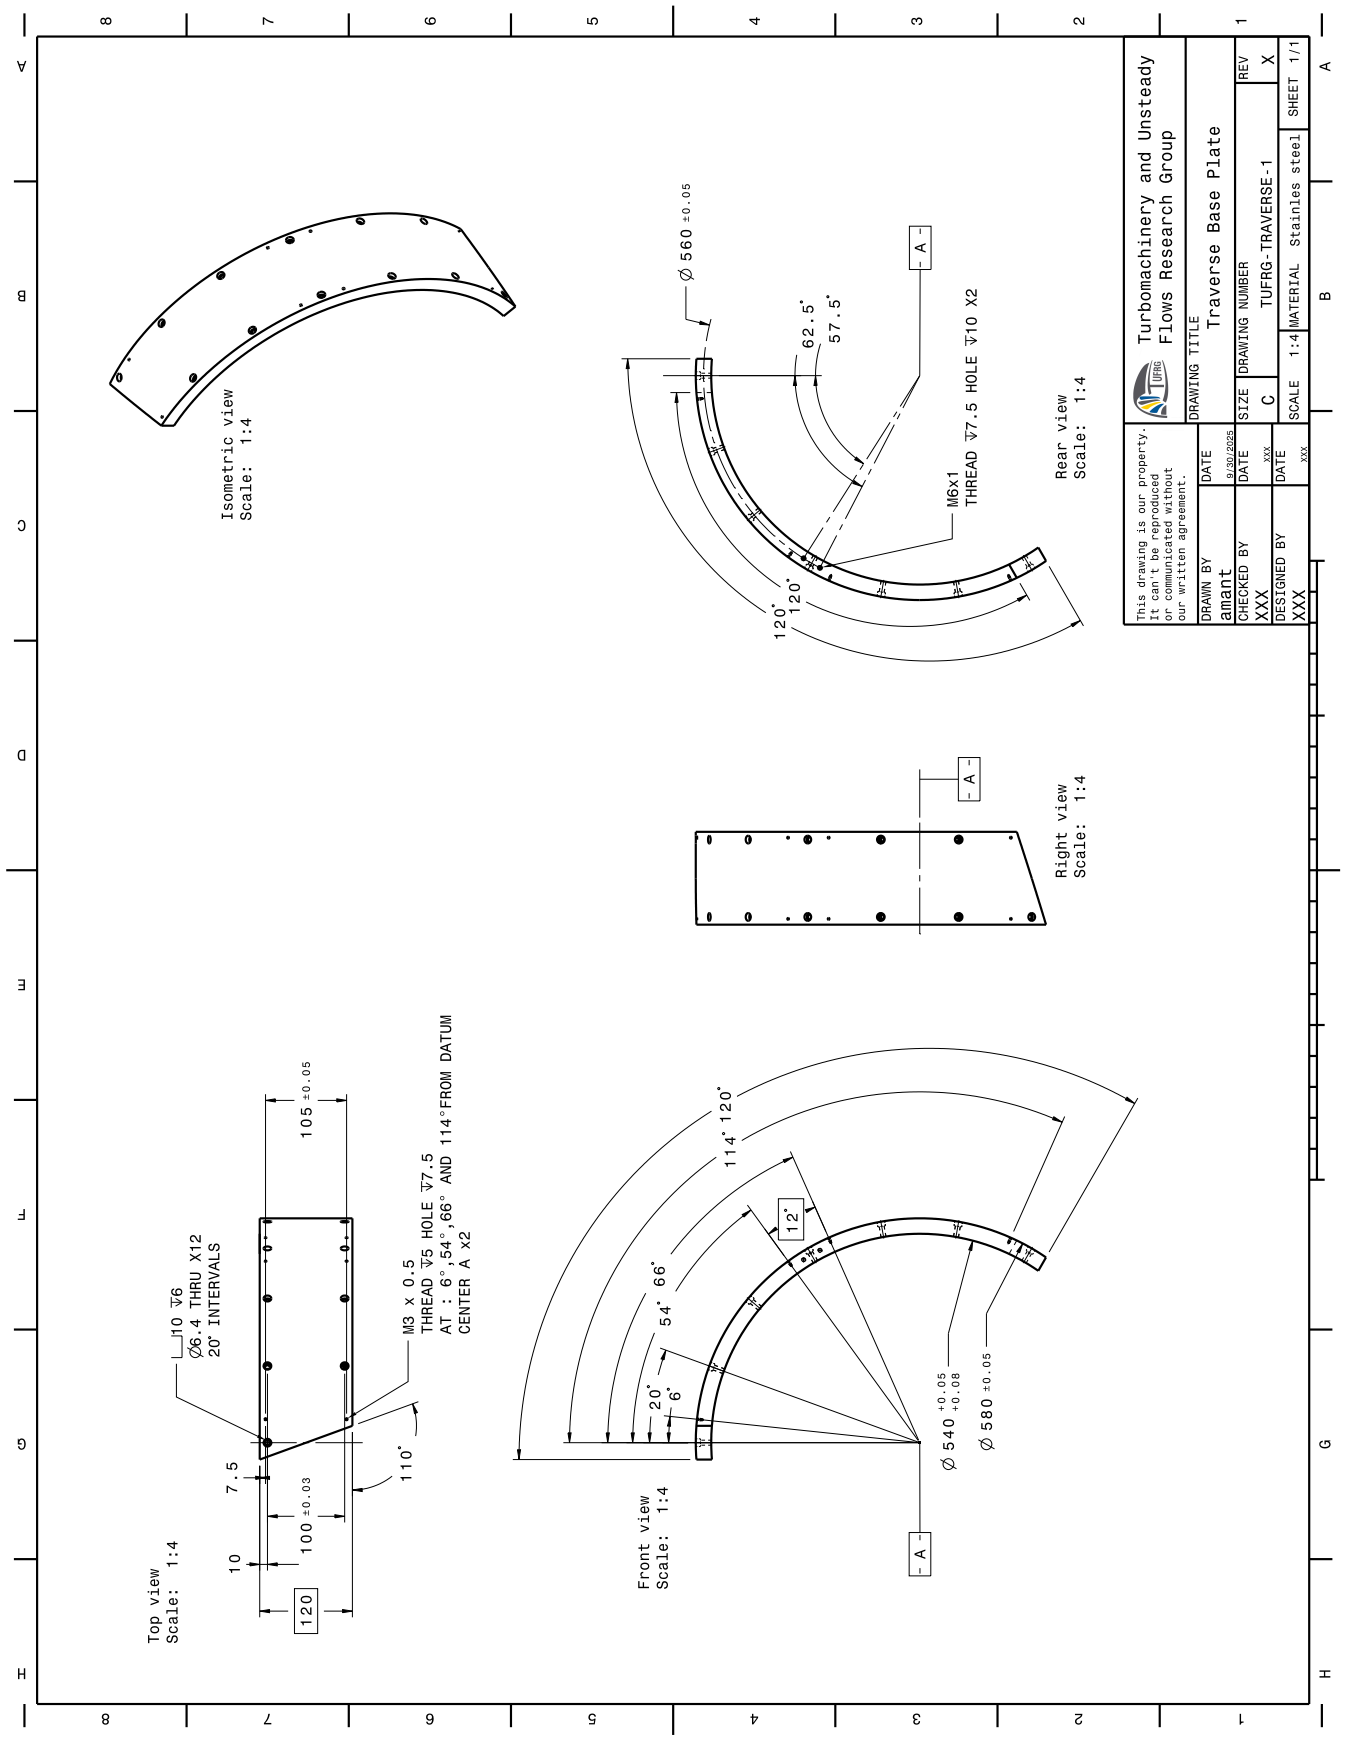
[picture p38: page 1]
