TUFRG/LSF-Rig-GT2026-176284/Engineering Drawings/Blower Inlet Duct Face 1 Drawing.pdf

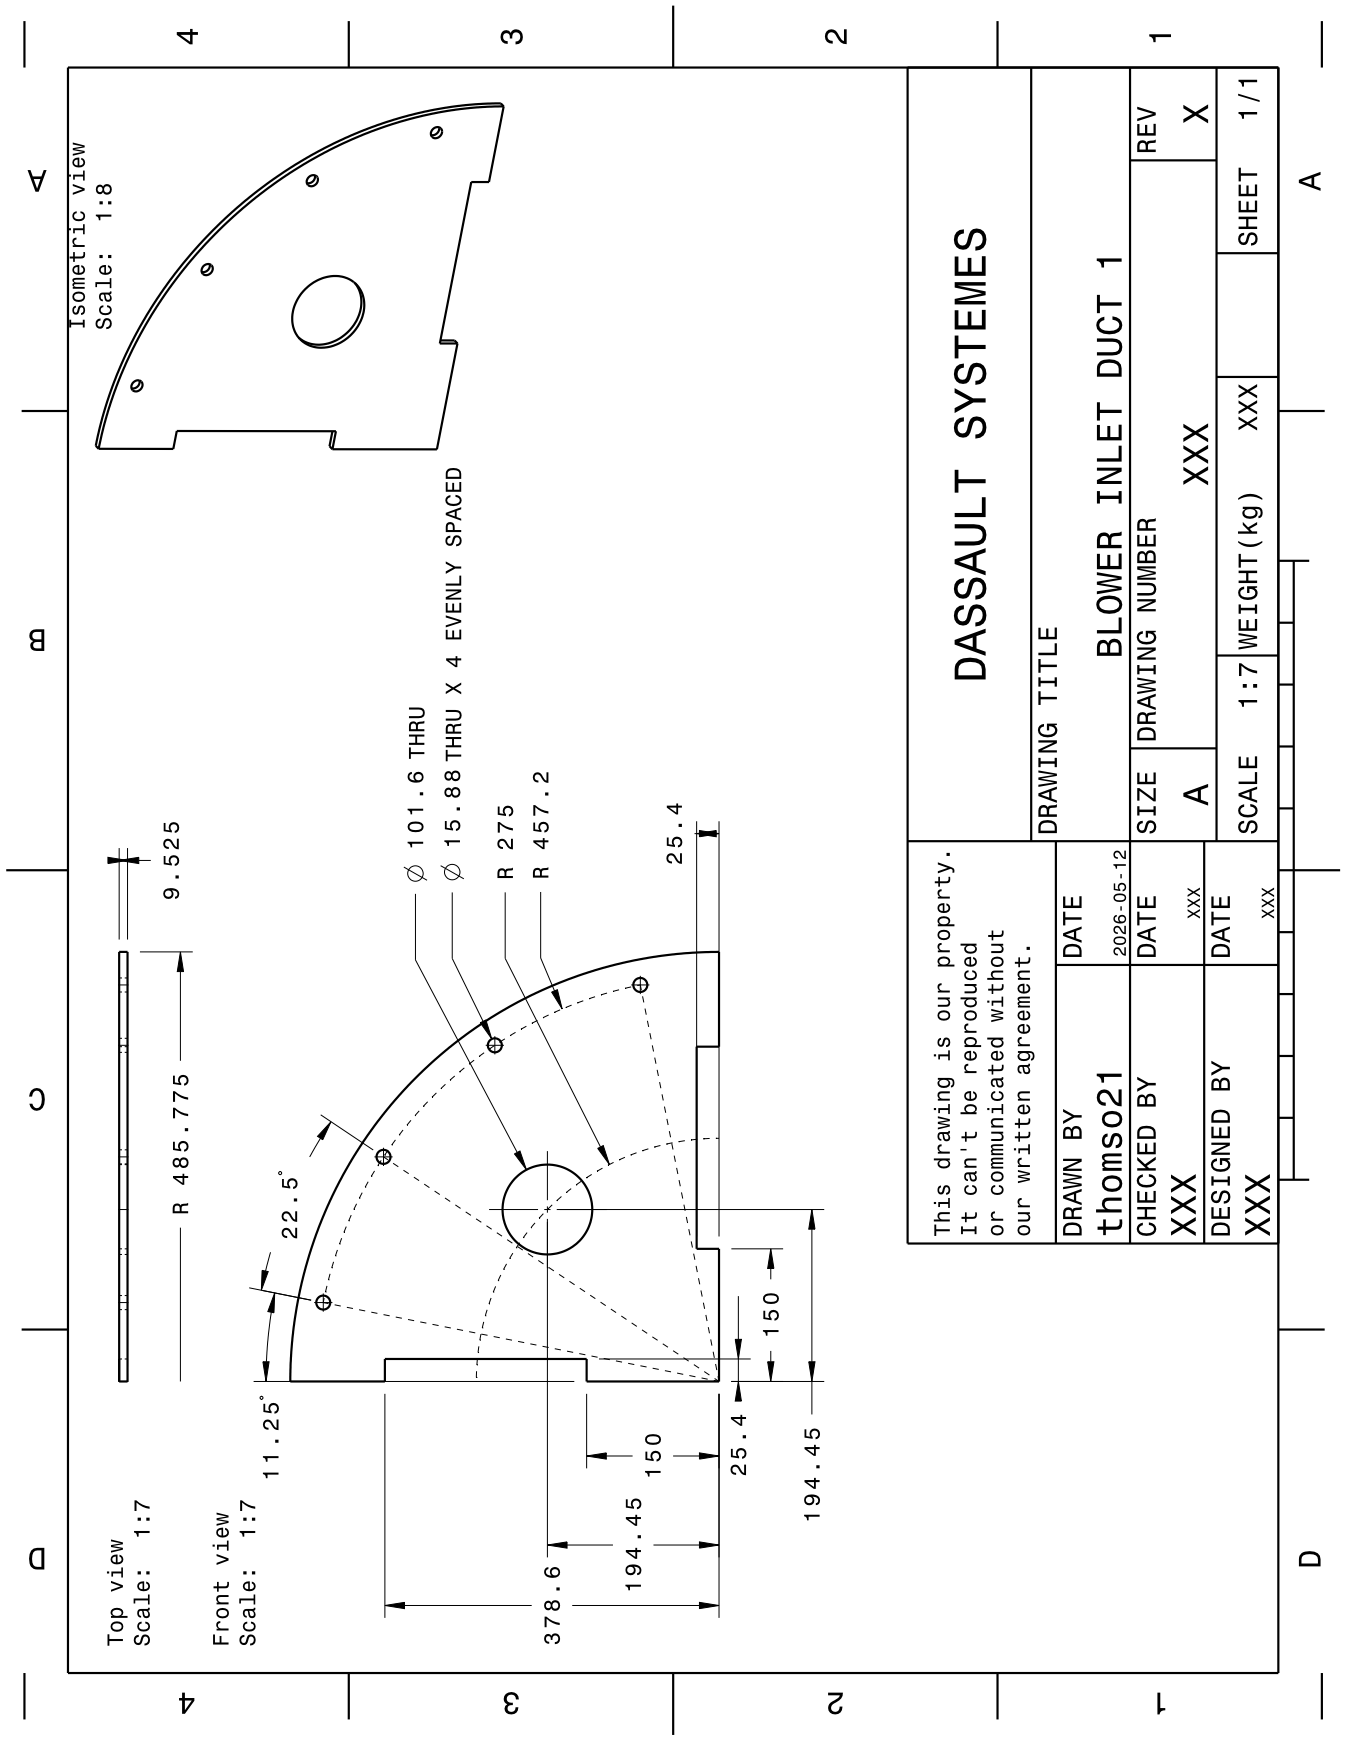
[picture p39: page 1]
