TUFRG/LSF-Rig-GT2026-176284/Engineering Drawings/Blower Inlet Duct Face 2 Drawing.pdf

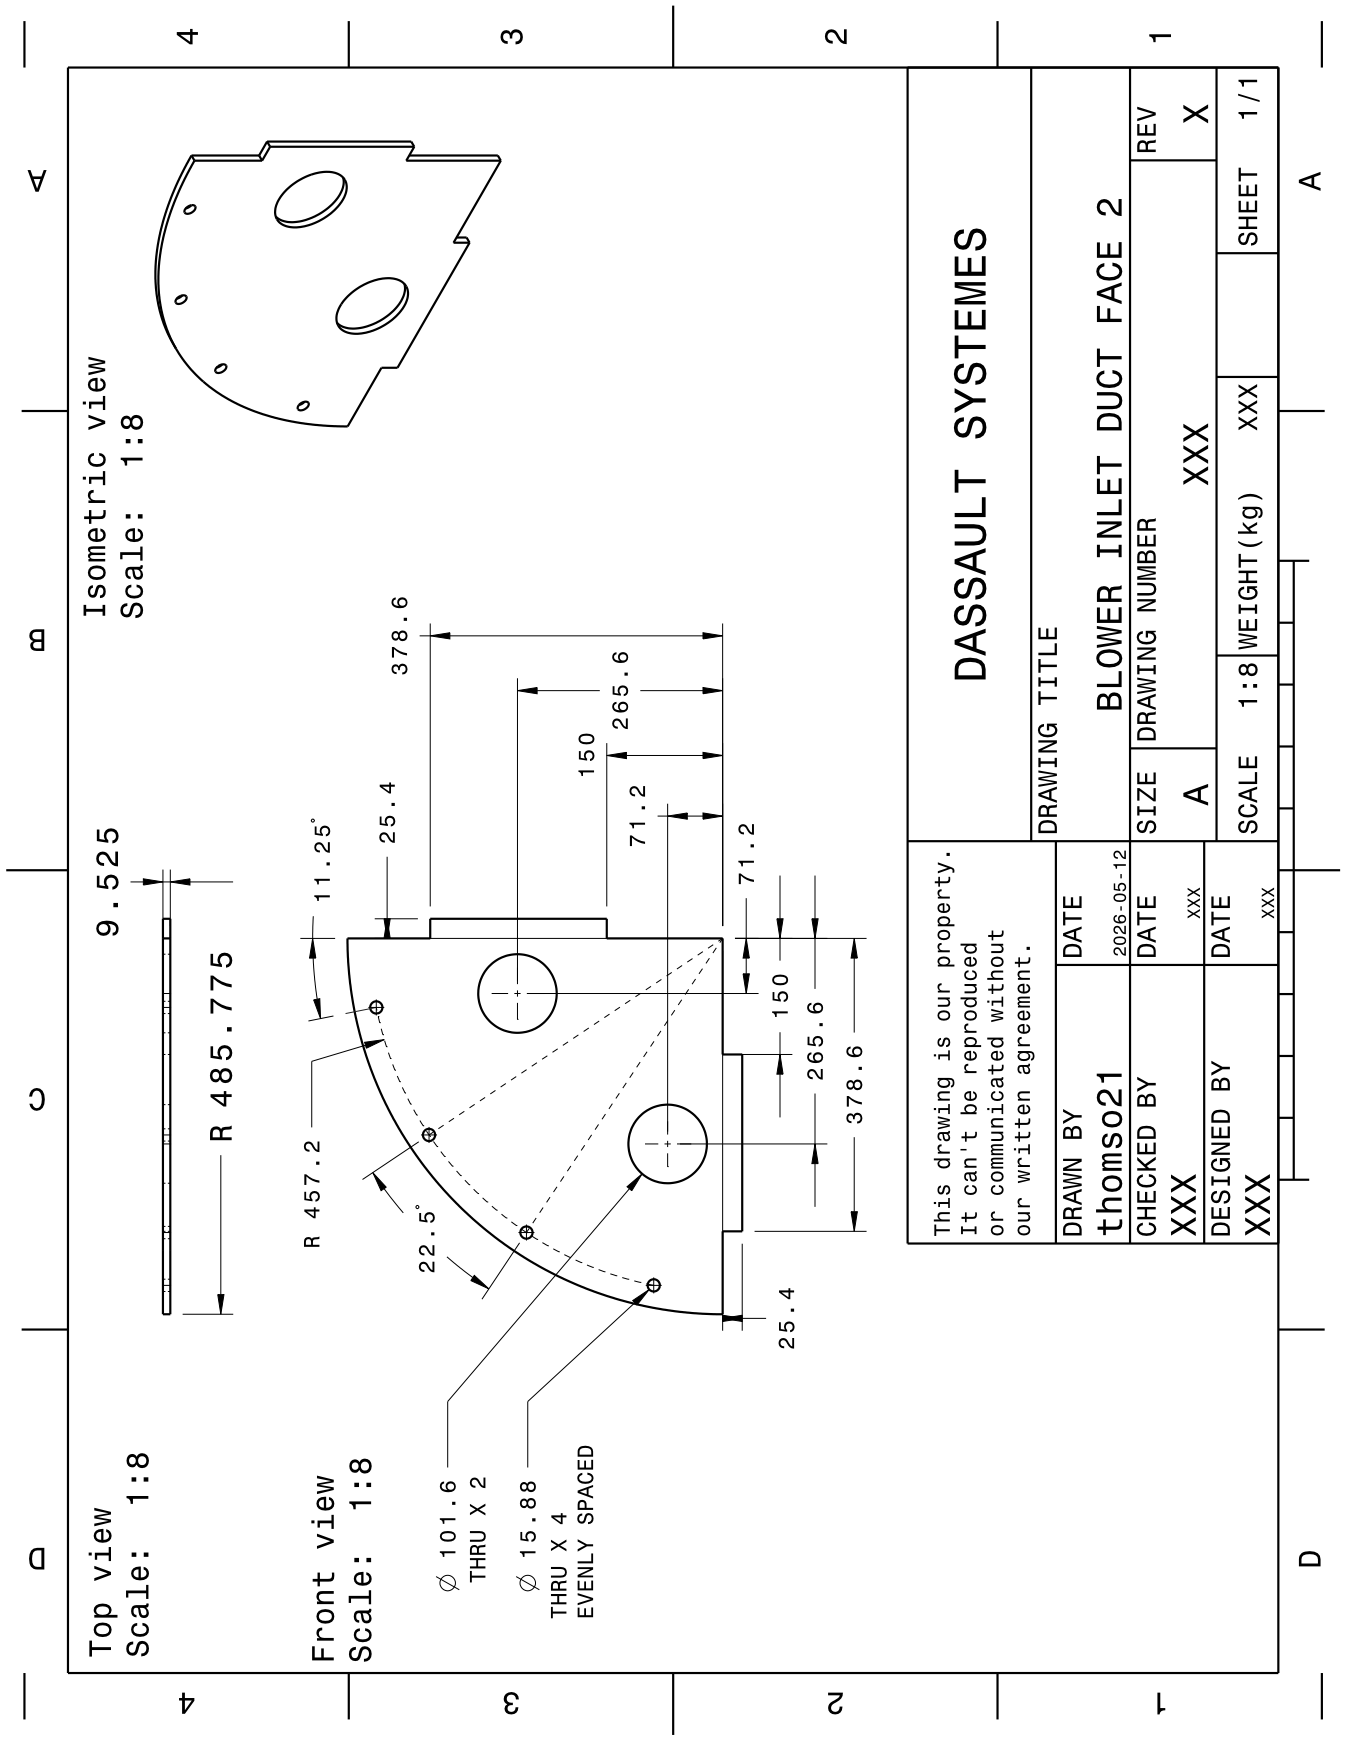
[picture p40: page 1]
