TUFRG/LSF-Rig-GT2026-176284/Engineering Drawings/First Support Base - Updated.pdf

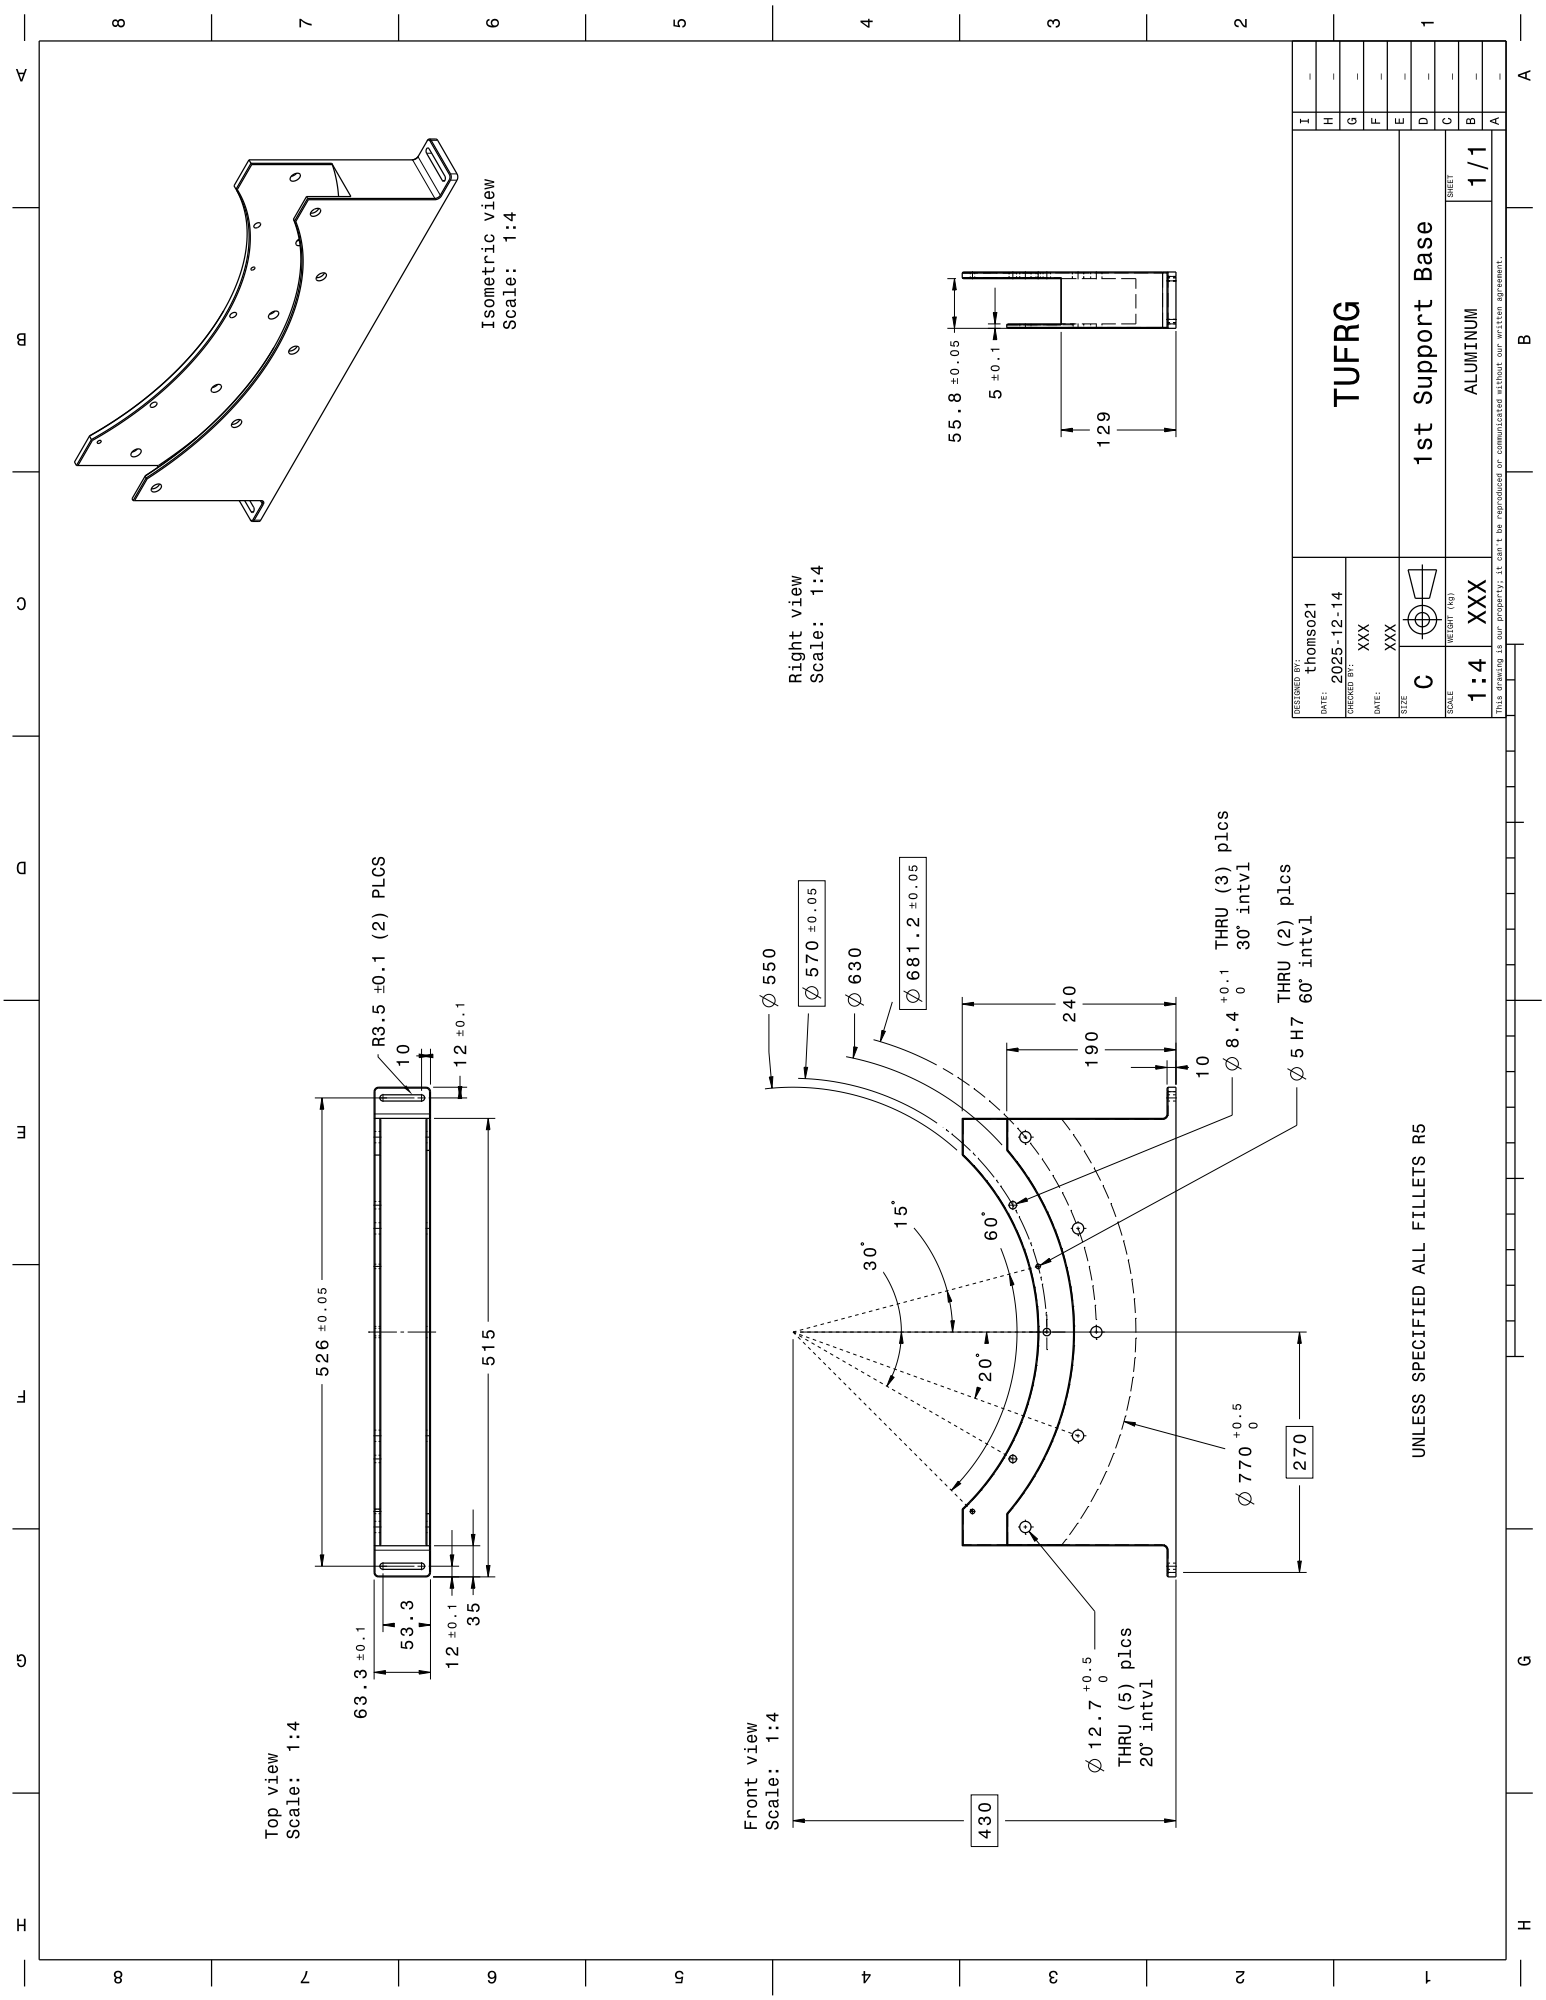
[picture p41: page 1]
