TUFRG/LSF-Rig-GT2026-176284/Engineering Drawings/First Support Base Plate-Revised.pdf

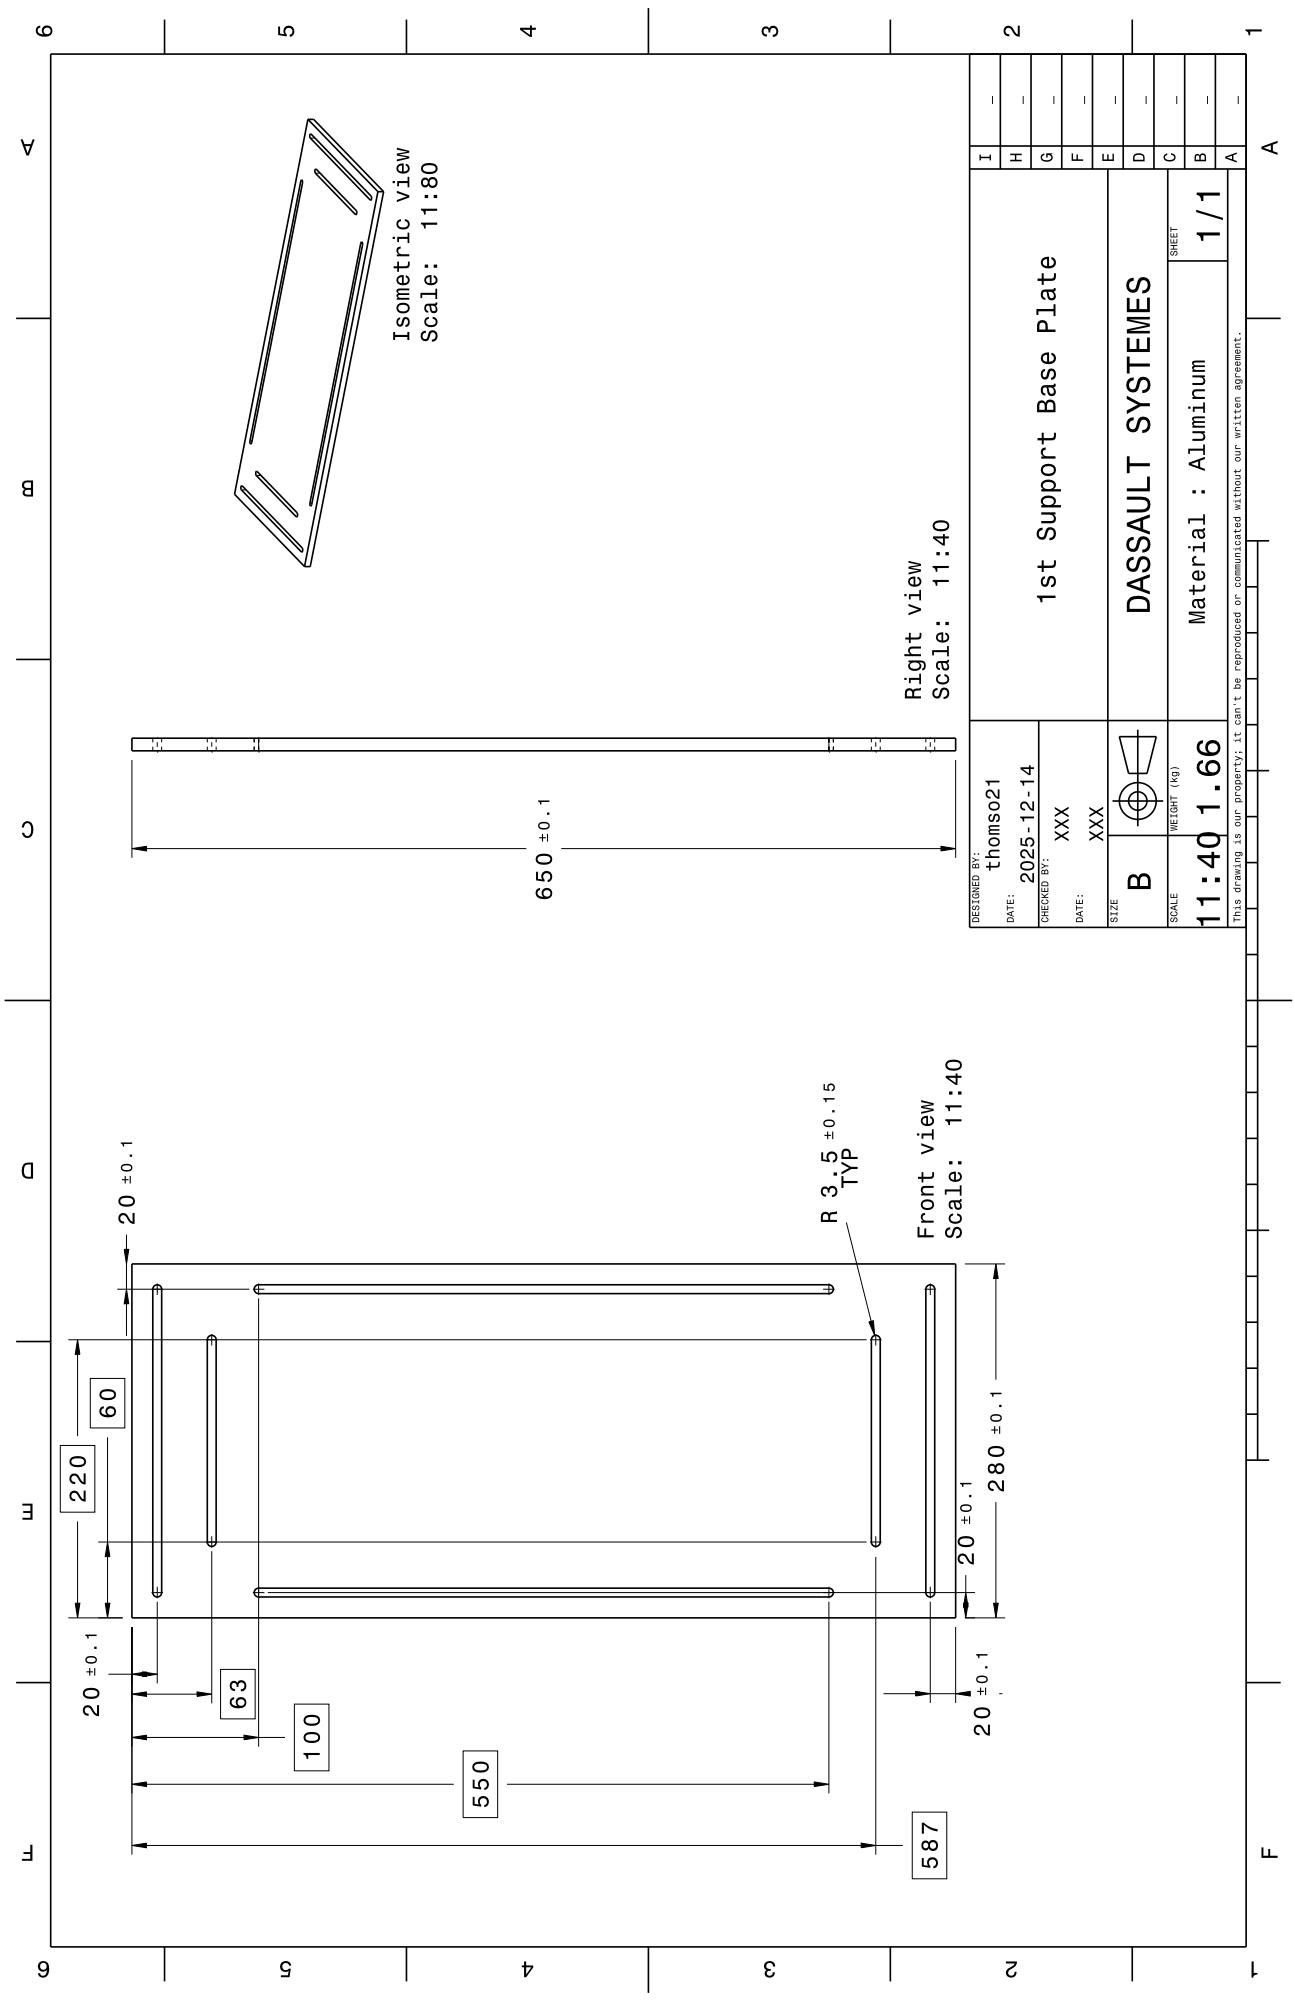
[picture p42: page 1]
