TUFRG/LSF-Rig-GT2026-176284/Engineering Drawings/Hex Motor Face  Drawing.pdf

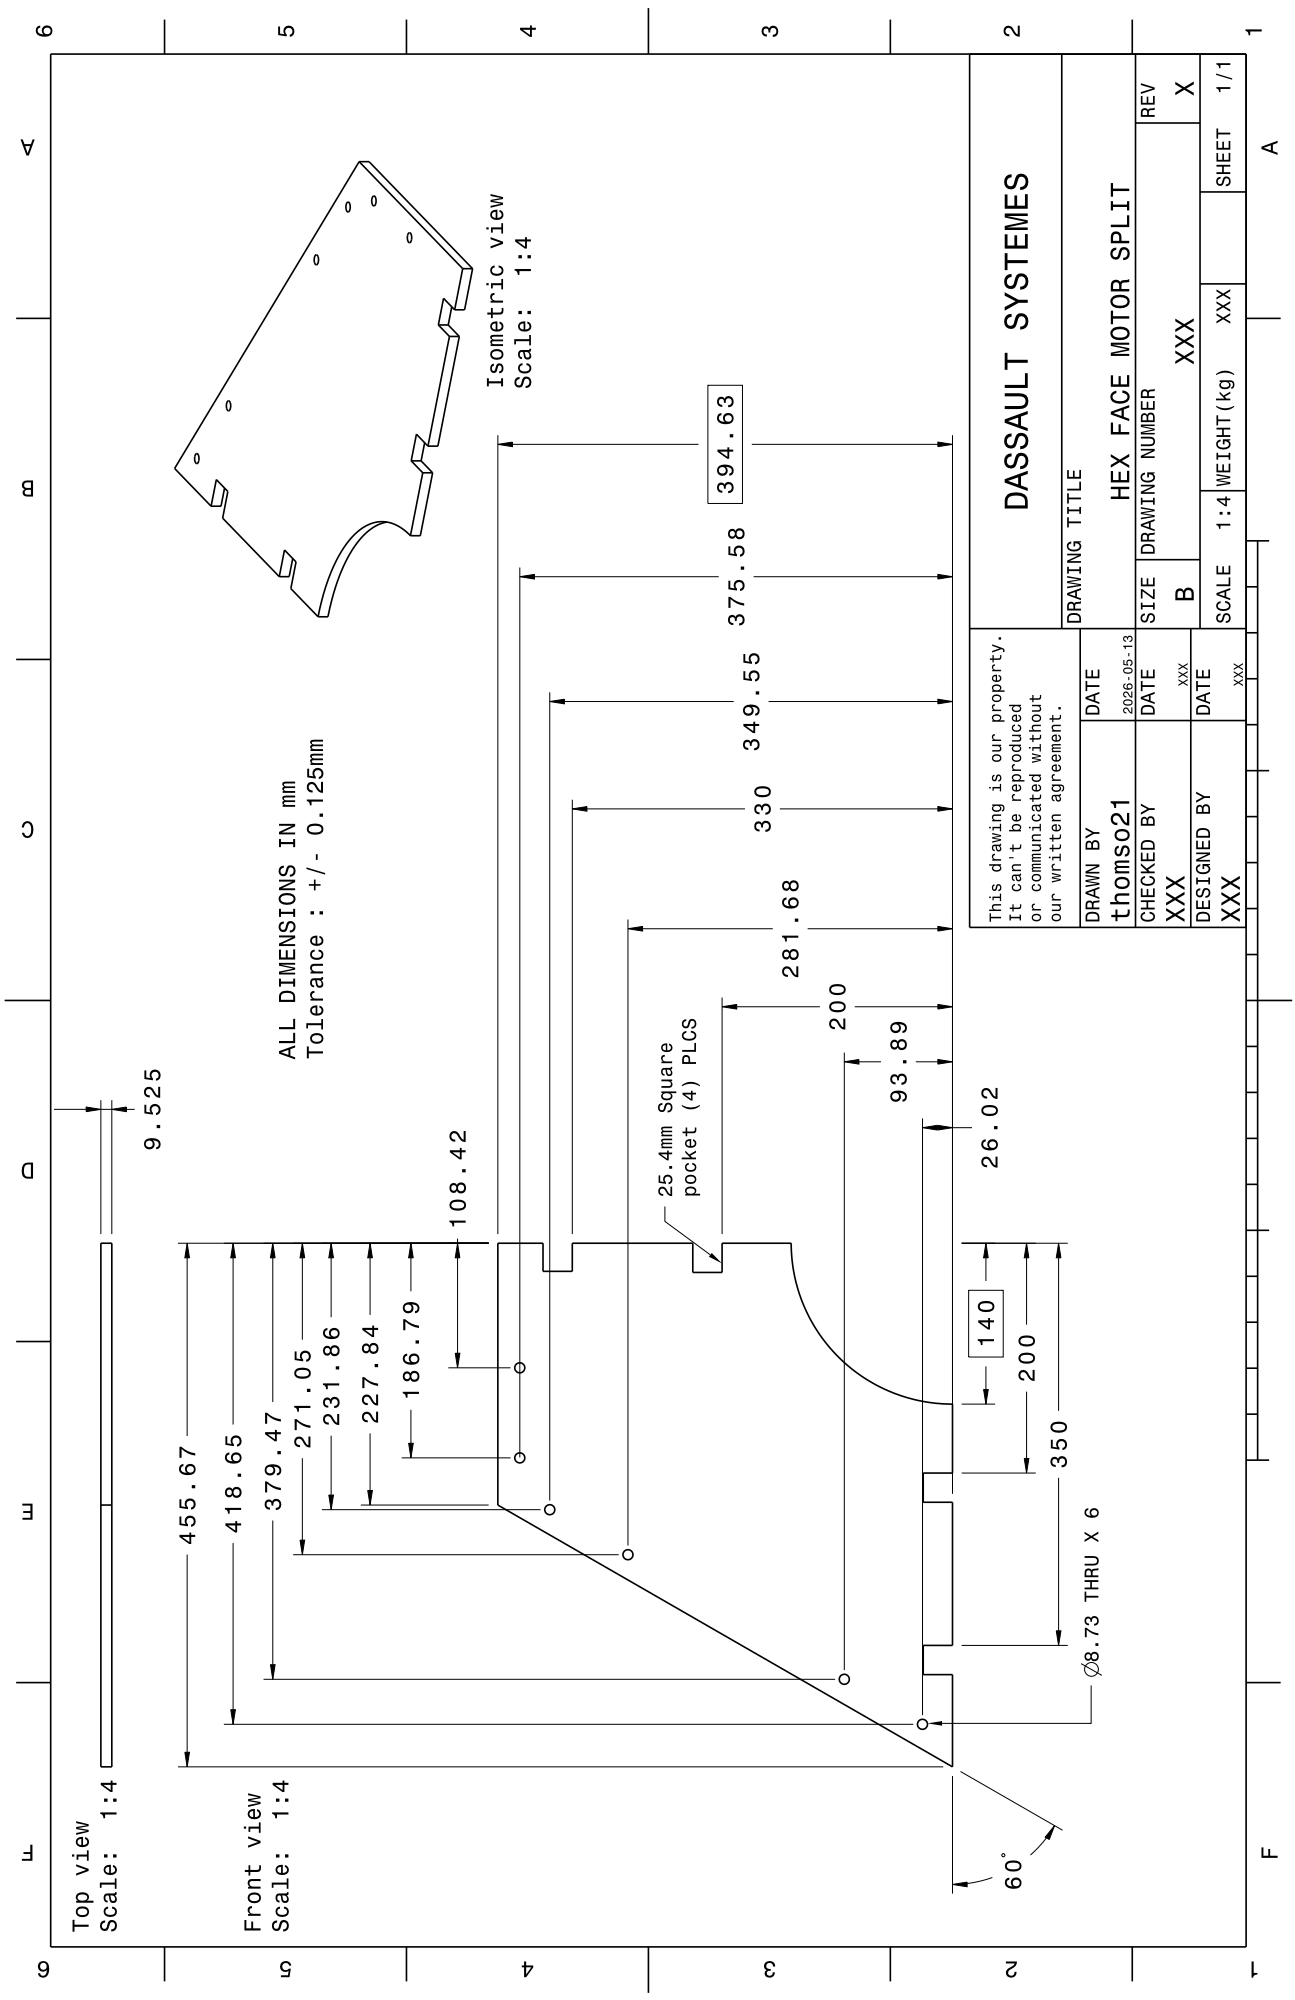
[picture p43: page 1]
