TUFRG/LSF-Rig-GT2026-176284/Engineering Drawings/Hex Motor Face 1 Drawing.pdf

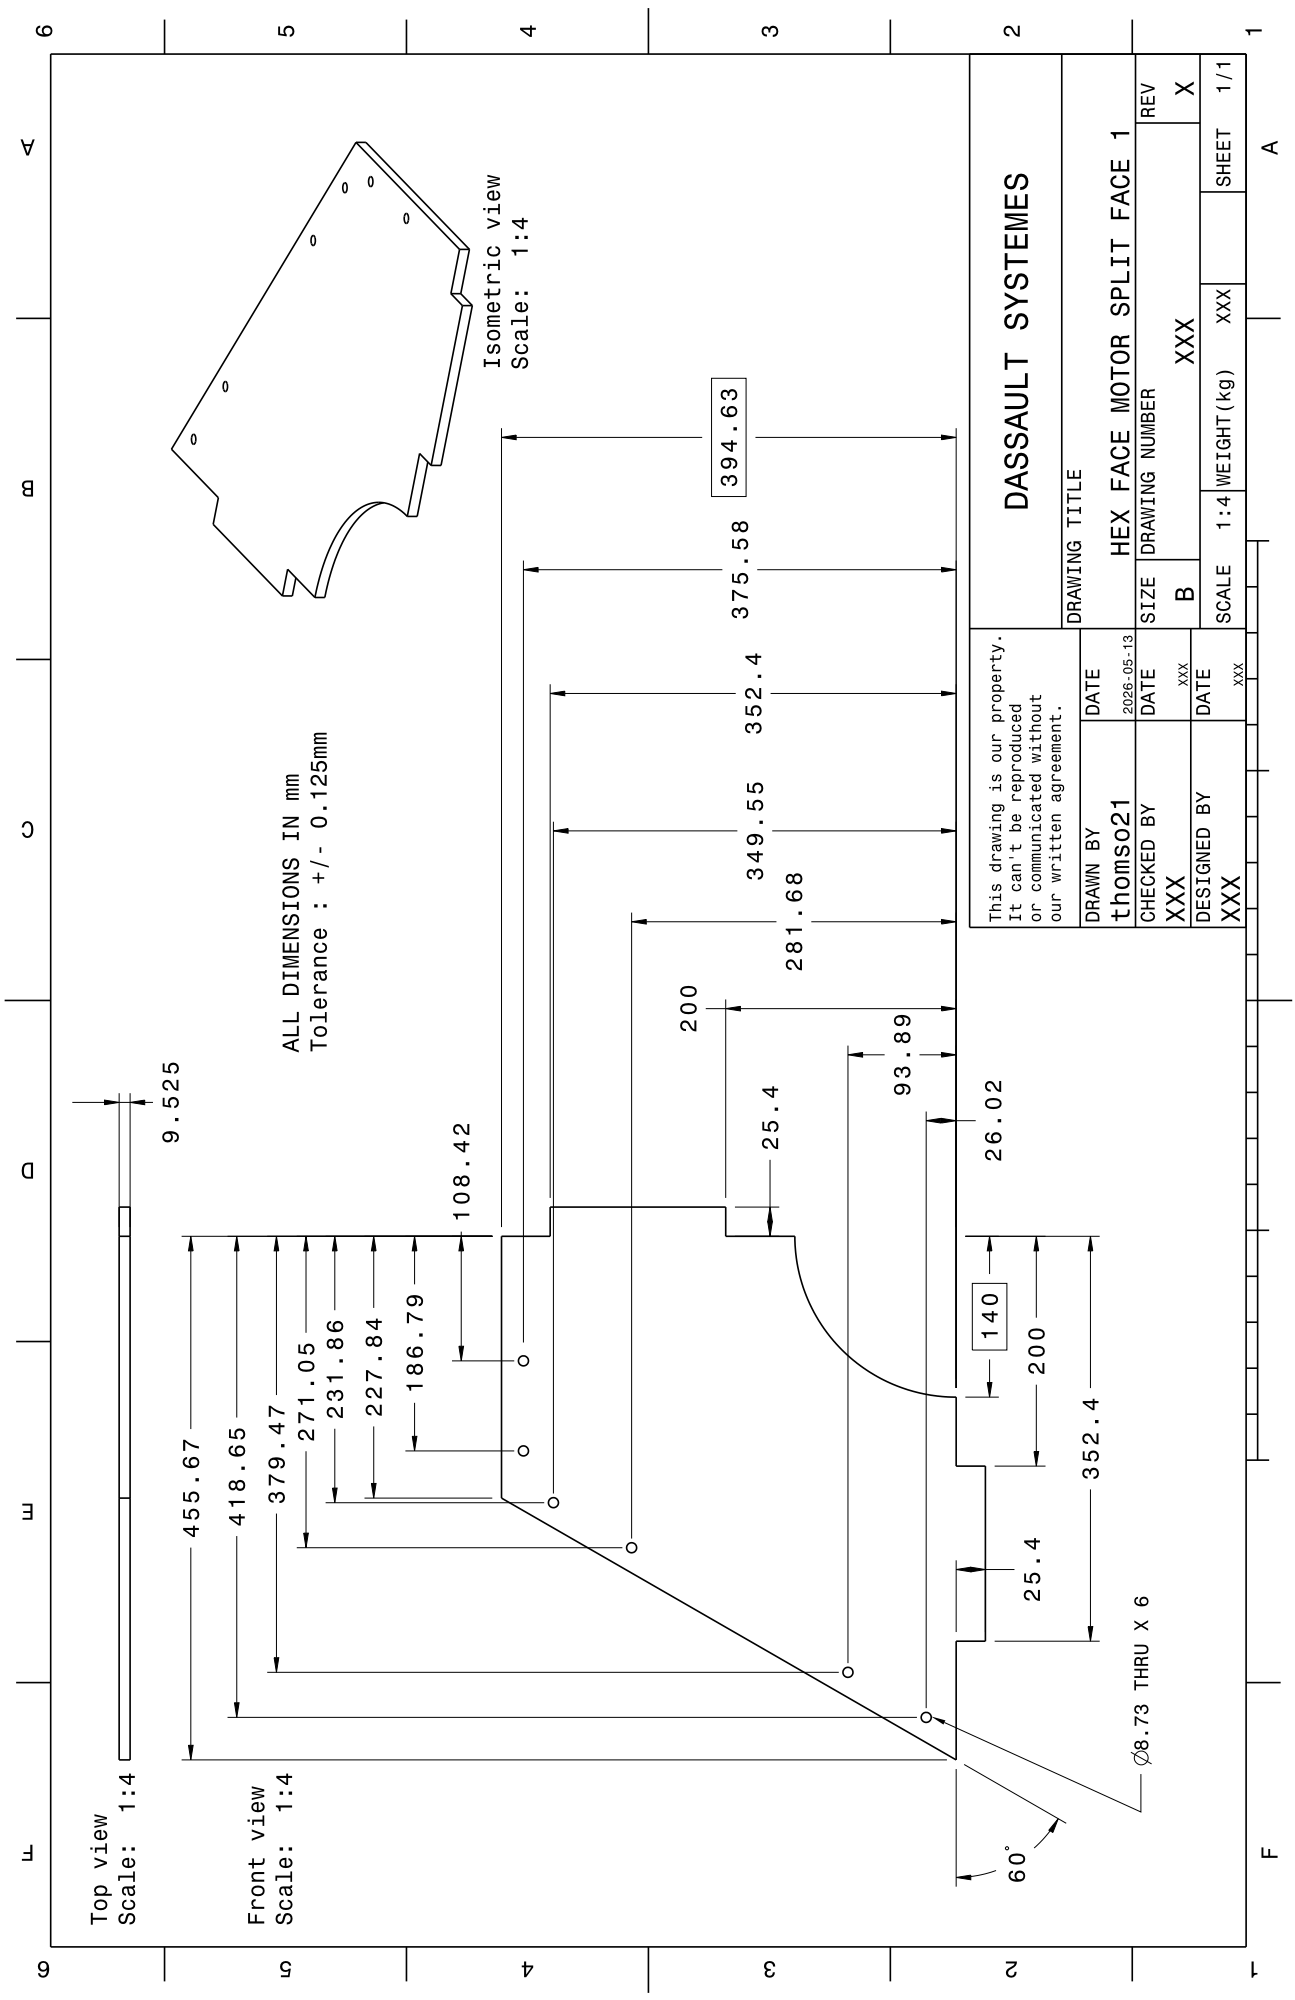
[picture p44: page 1]
