TUFRG/LSF-Rig-GT2026-176284/Engineering Drawings/Hex Motor Face 2  Drawing.pdf

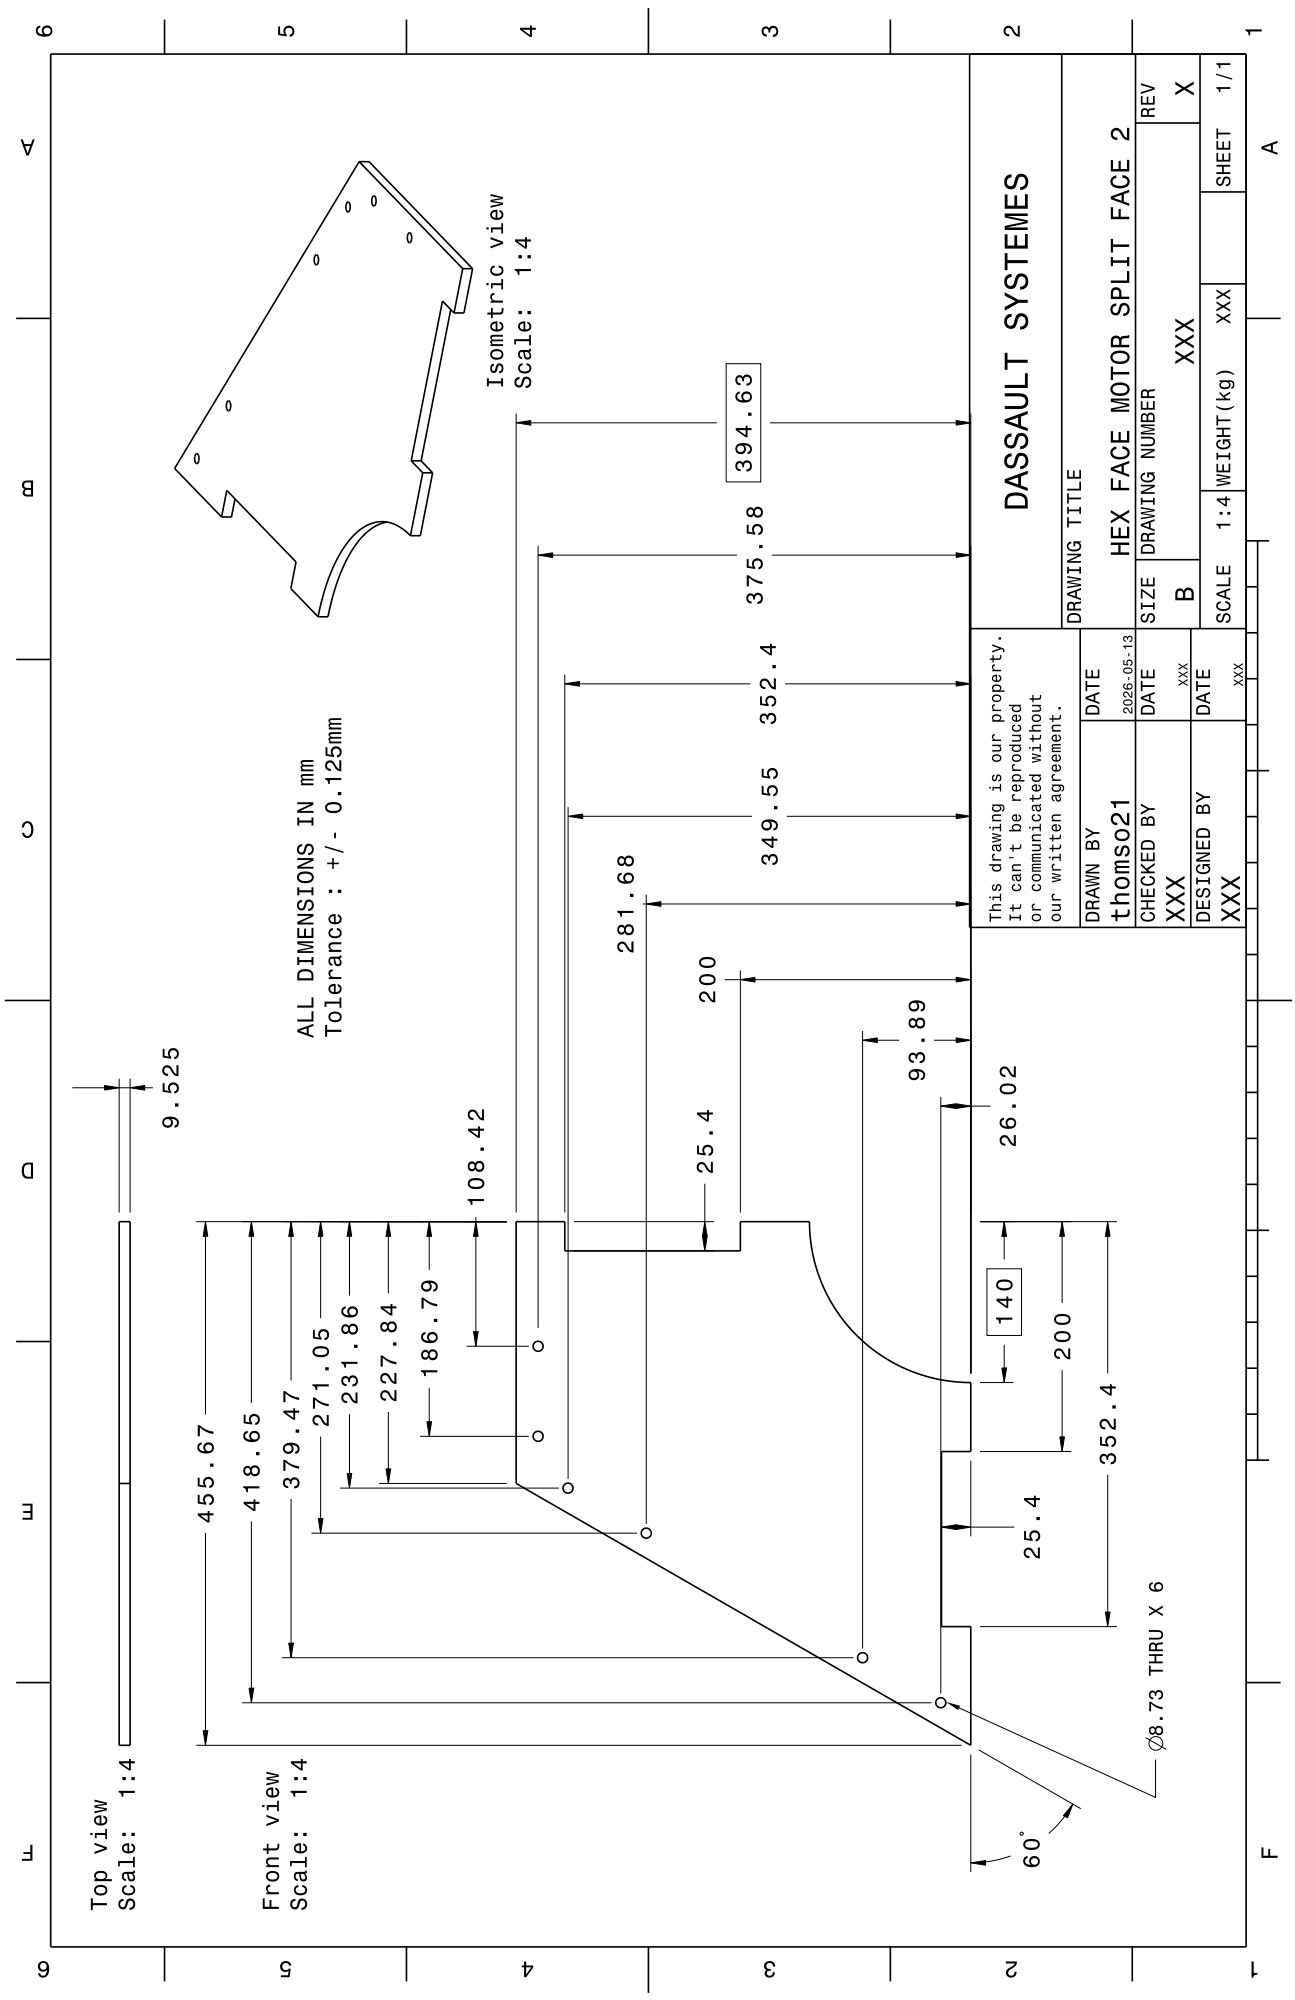
[picture p45: page 1]
