TUFRG/LSF-Rig-GT2026-176284/Engineering Drawings/Hex Rig Face  Drawing.pdf

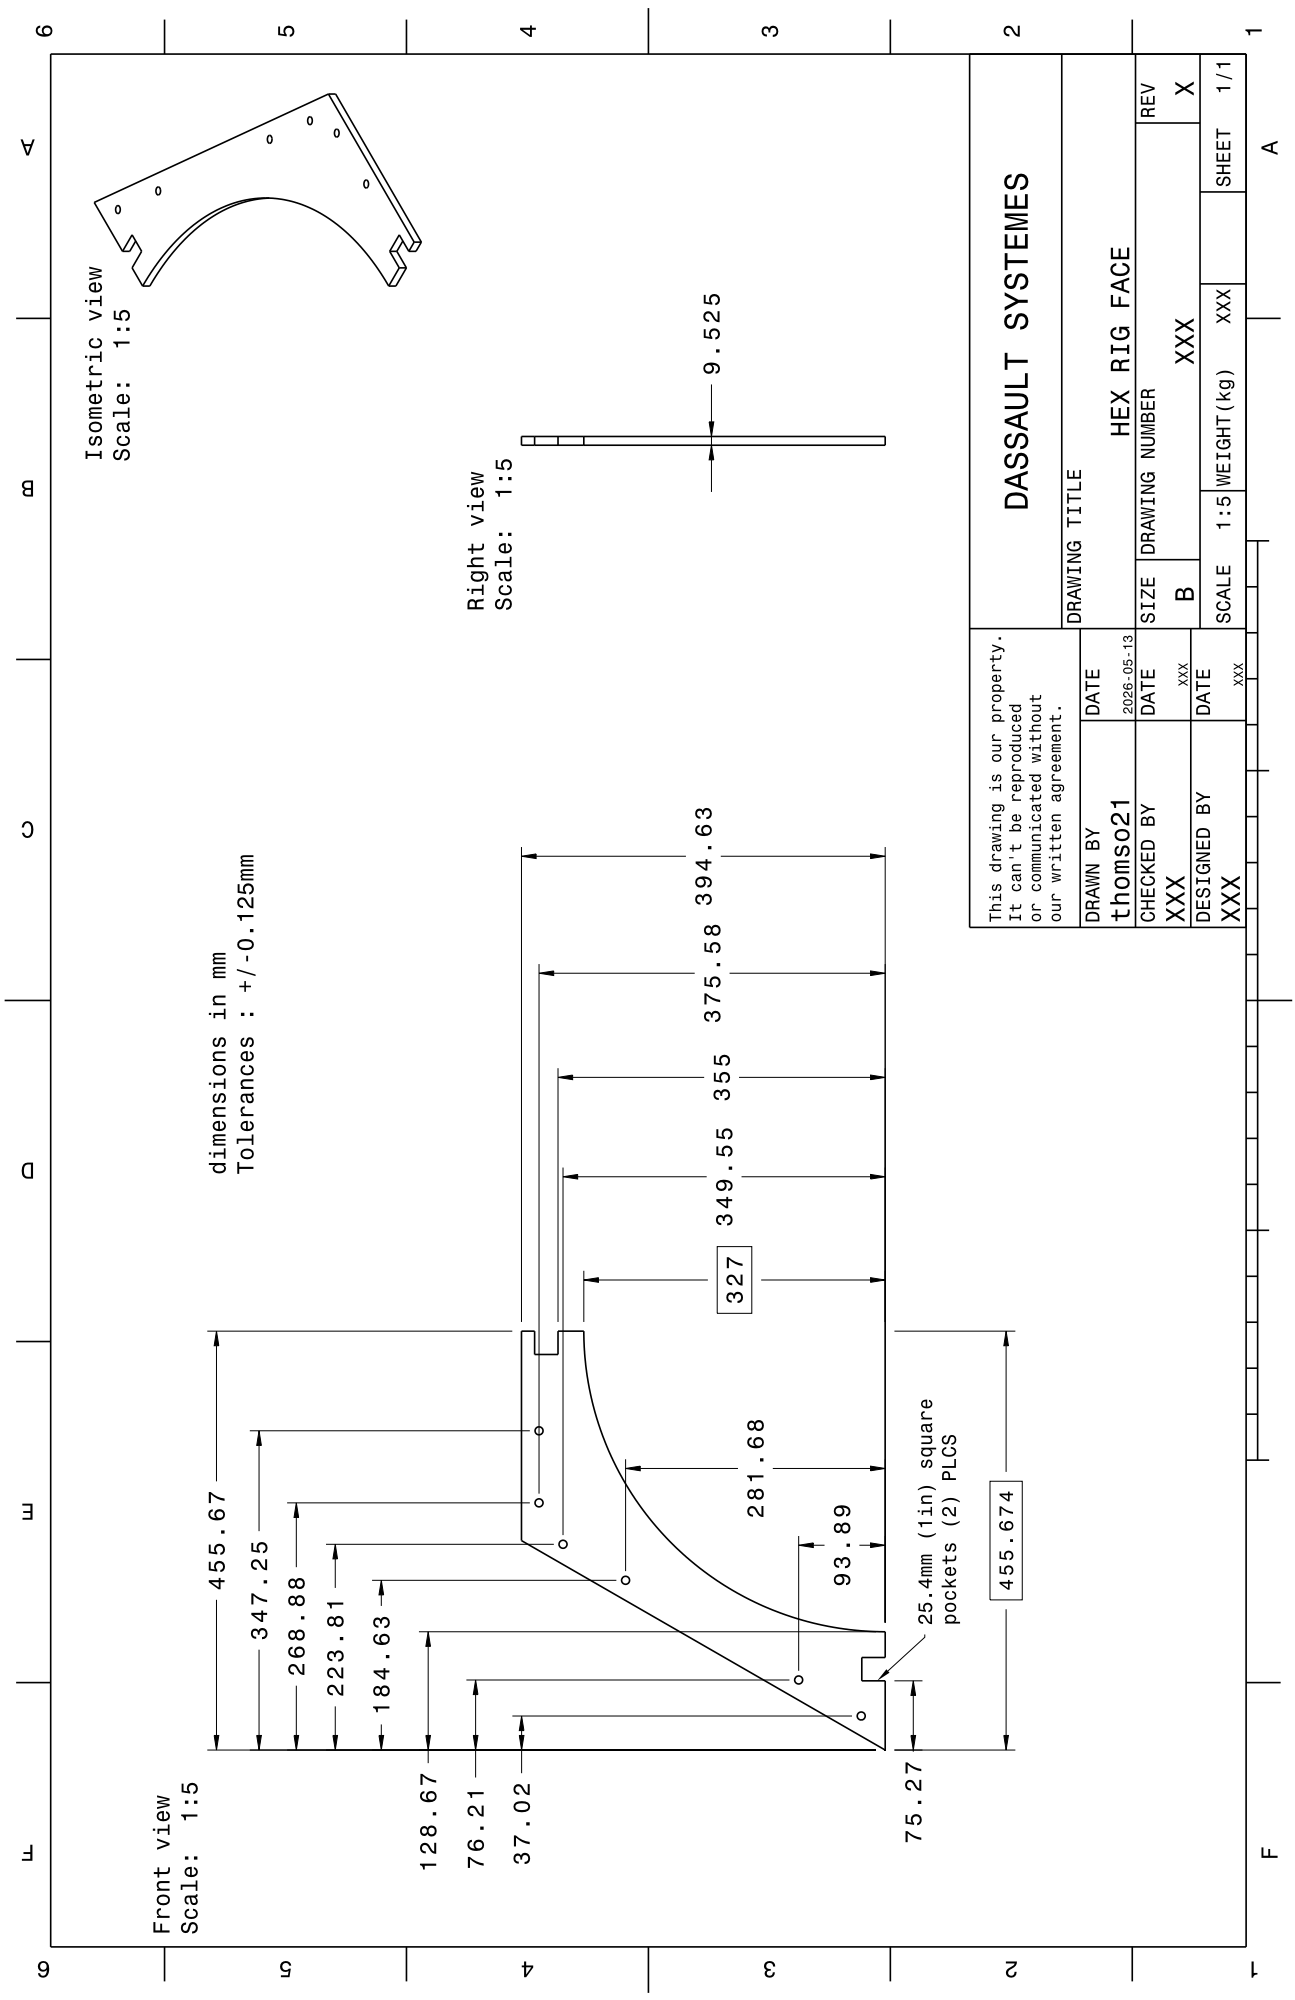
[picture p46: page 1]
