TUFRG/LSF-Rig-GT2026-176284/Engineering Drawings/Hex Rig Face 1 Drawing.pdf

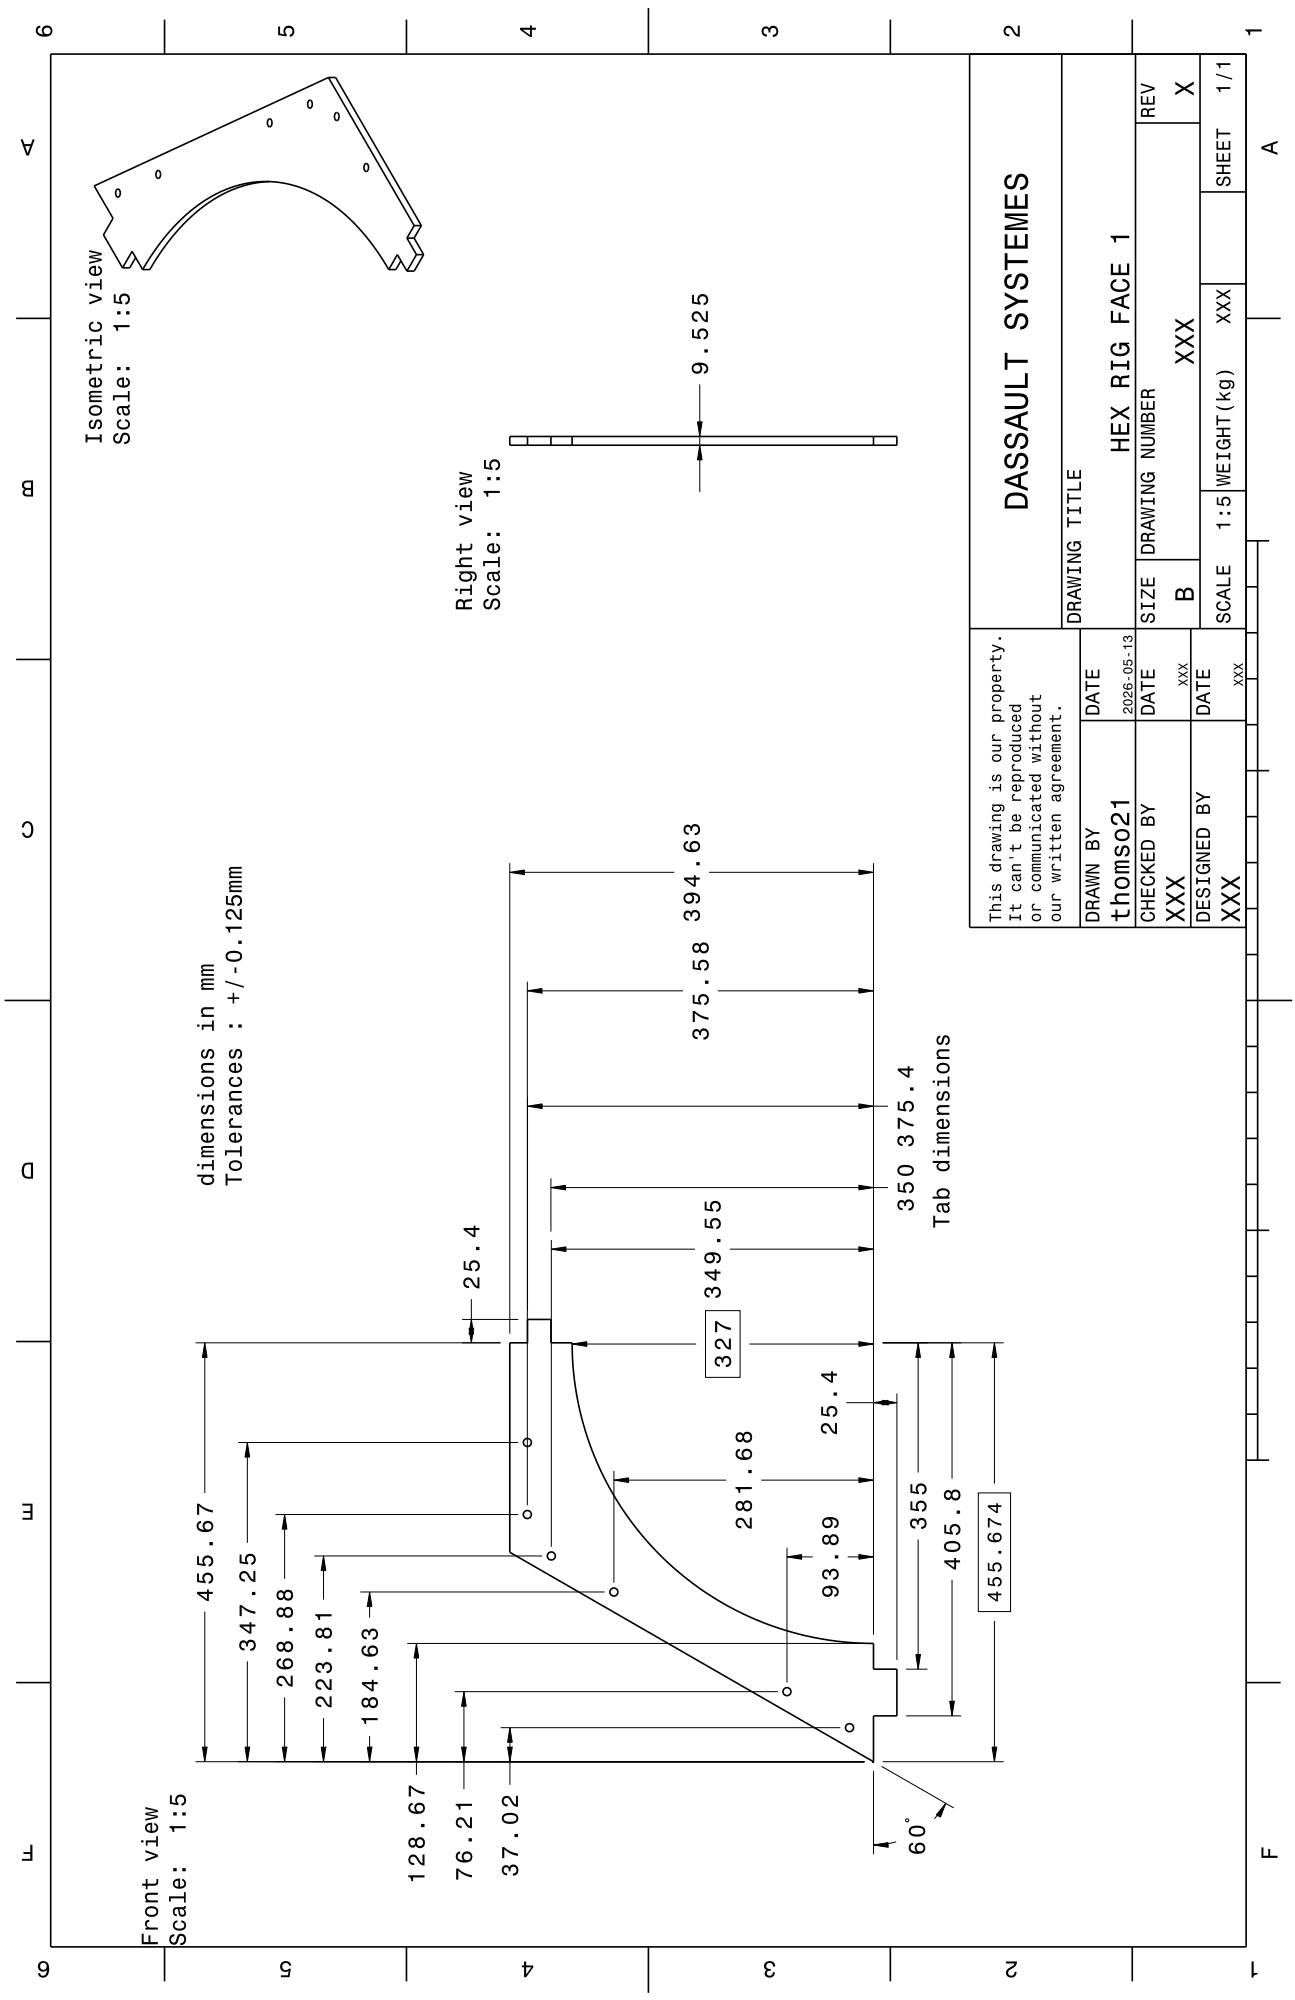
[picture p47: page 1]
