TUFRG/LSF-Rig-GT2026-176284/Engineering Drawings/Hex Rig Face 2 Drawing.pdf

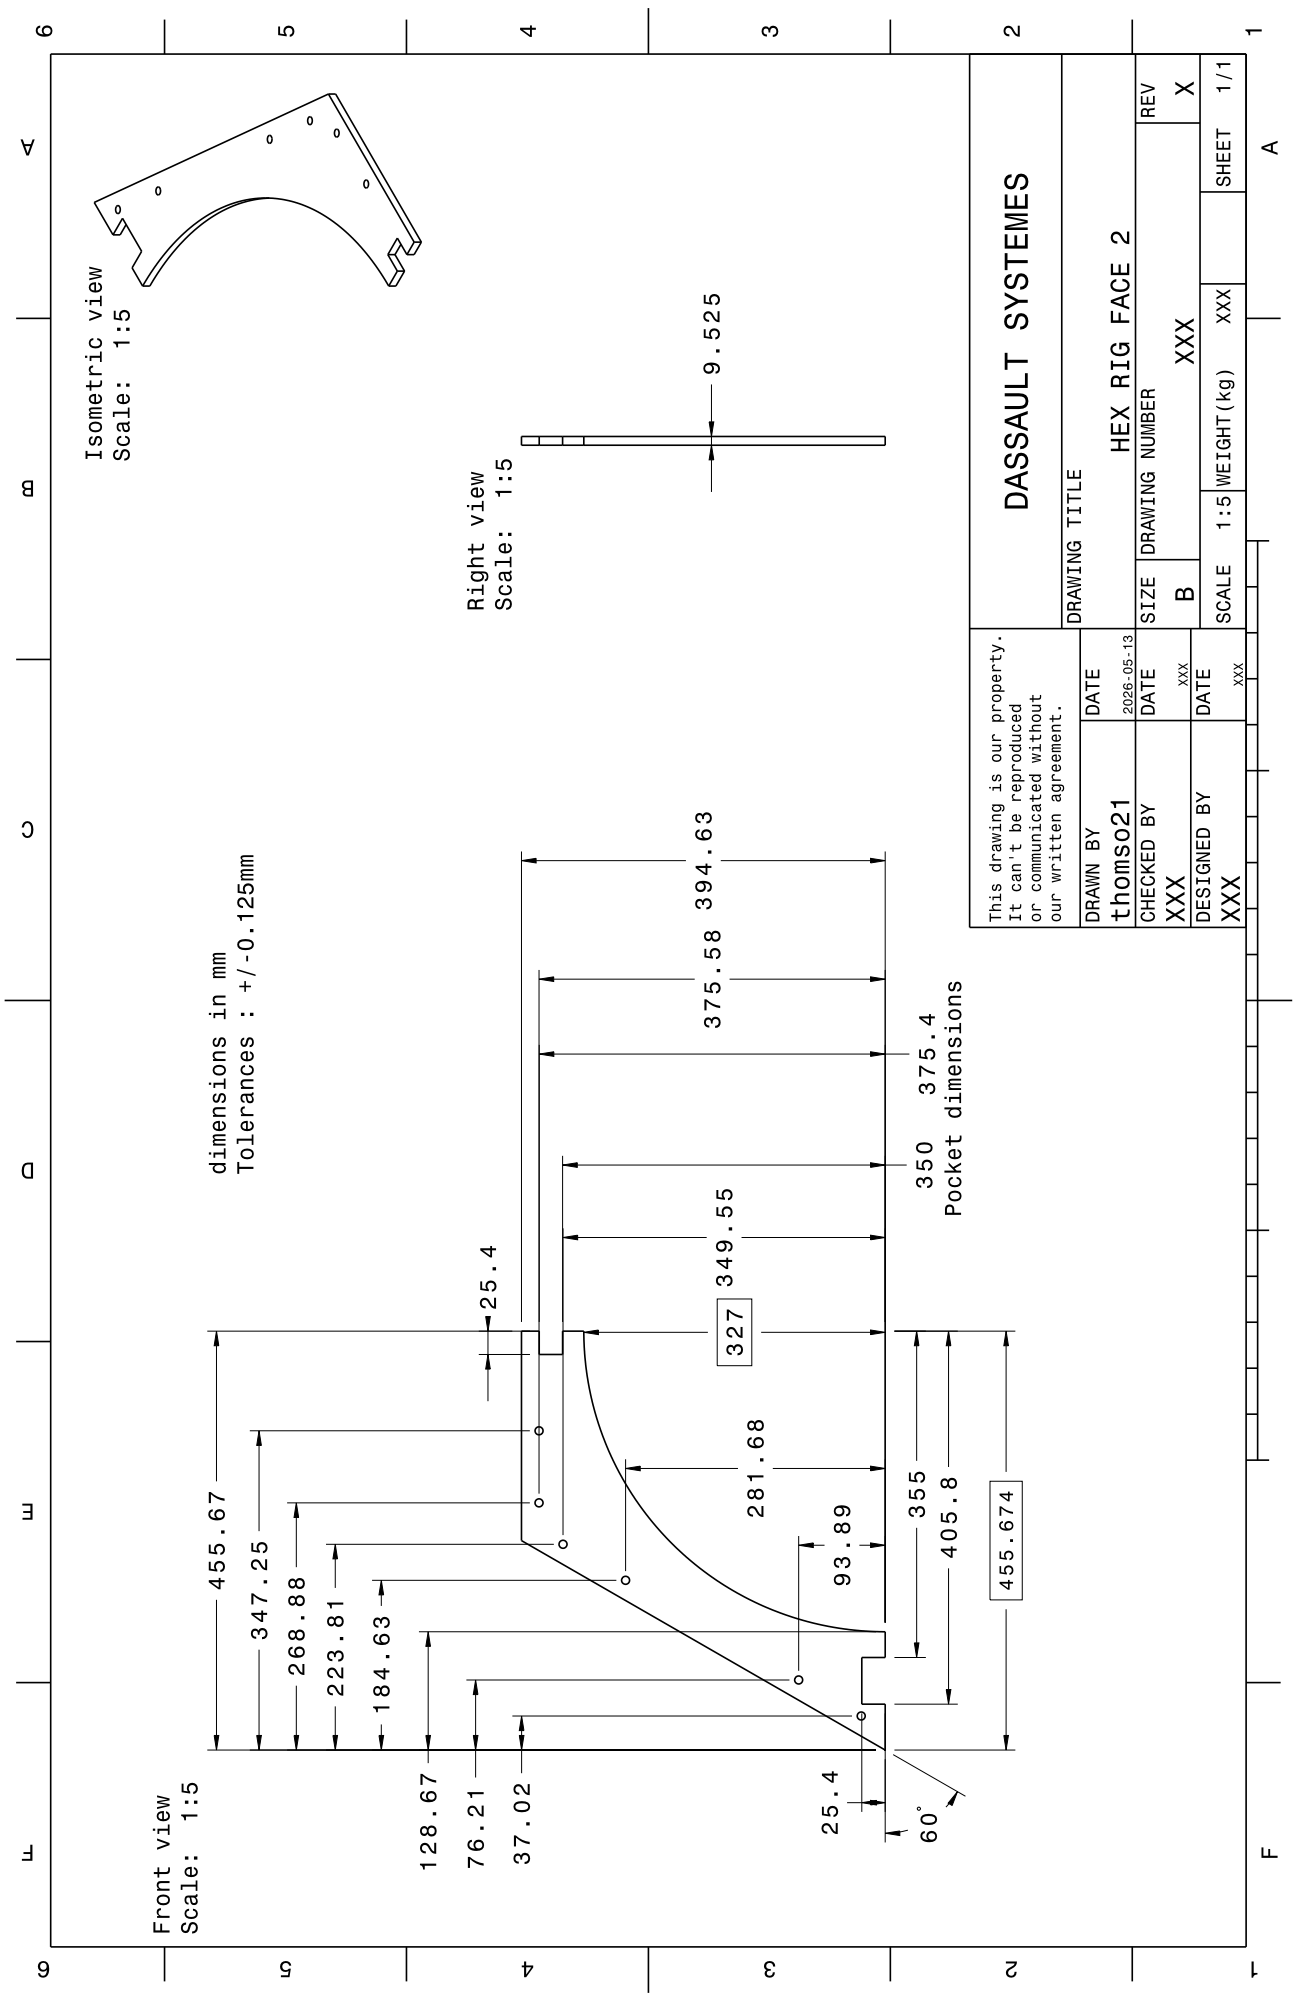
[picture p48: page 1]
