TUFRG/LSF-Rig-GT2026-176284/Engineering Drawings/Hub_Drawing_Bearing_Included.pdf

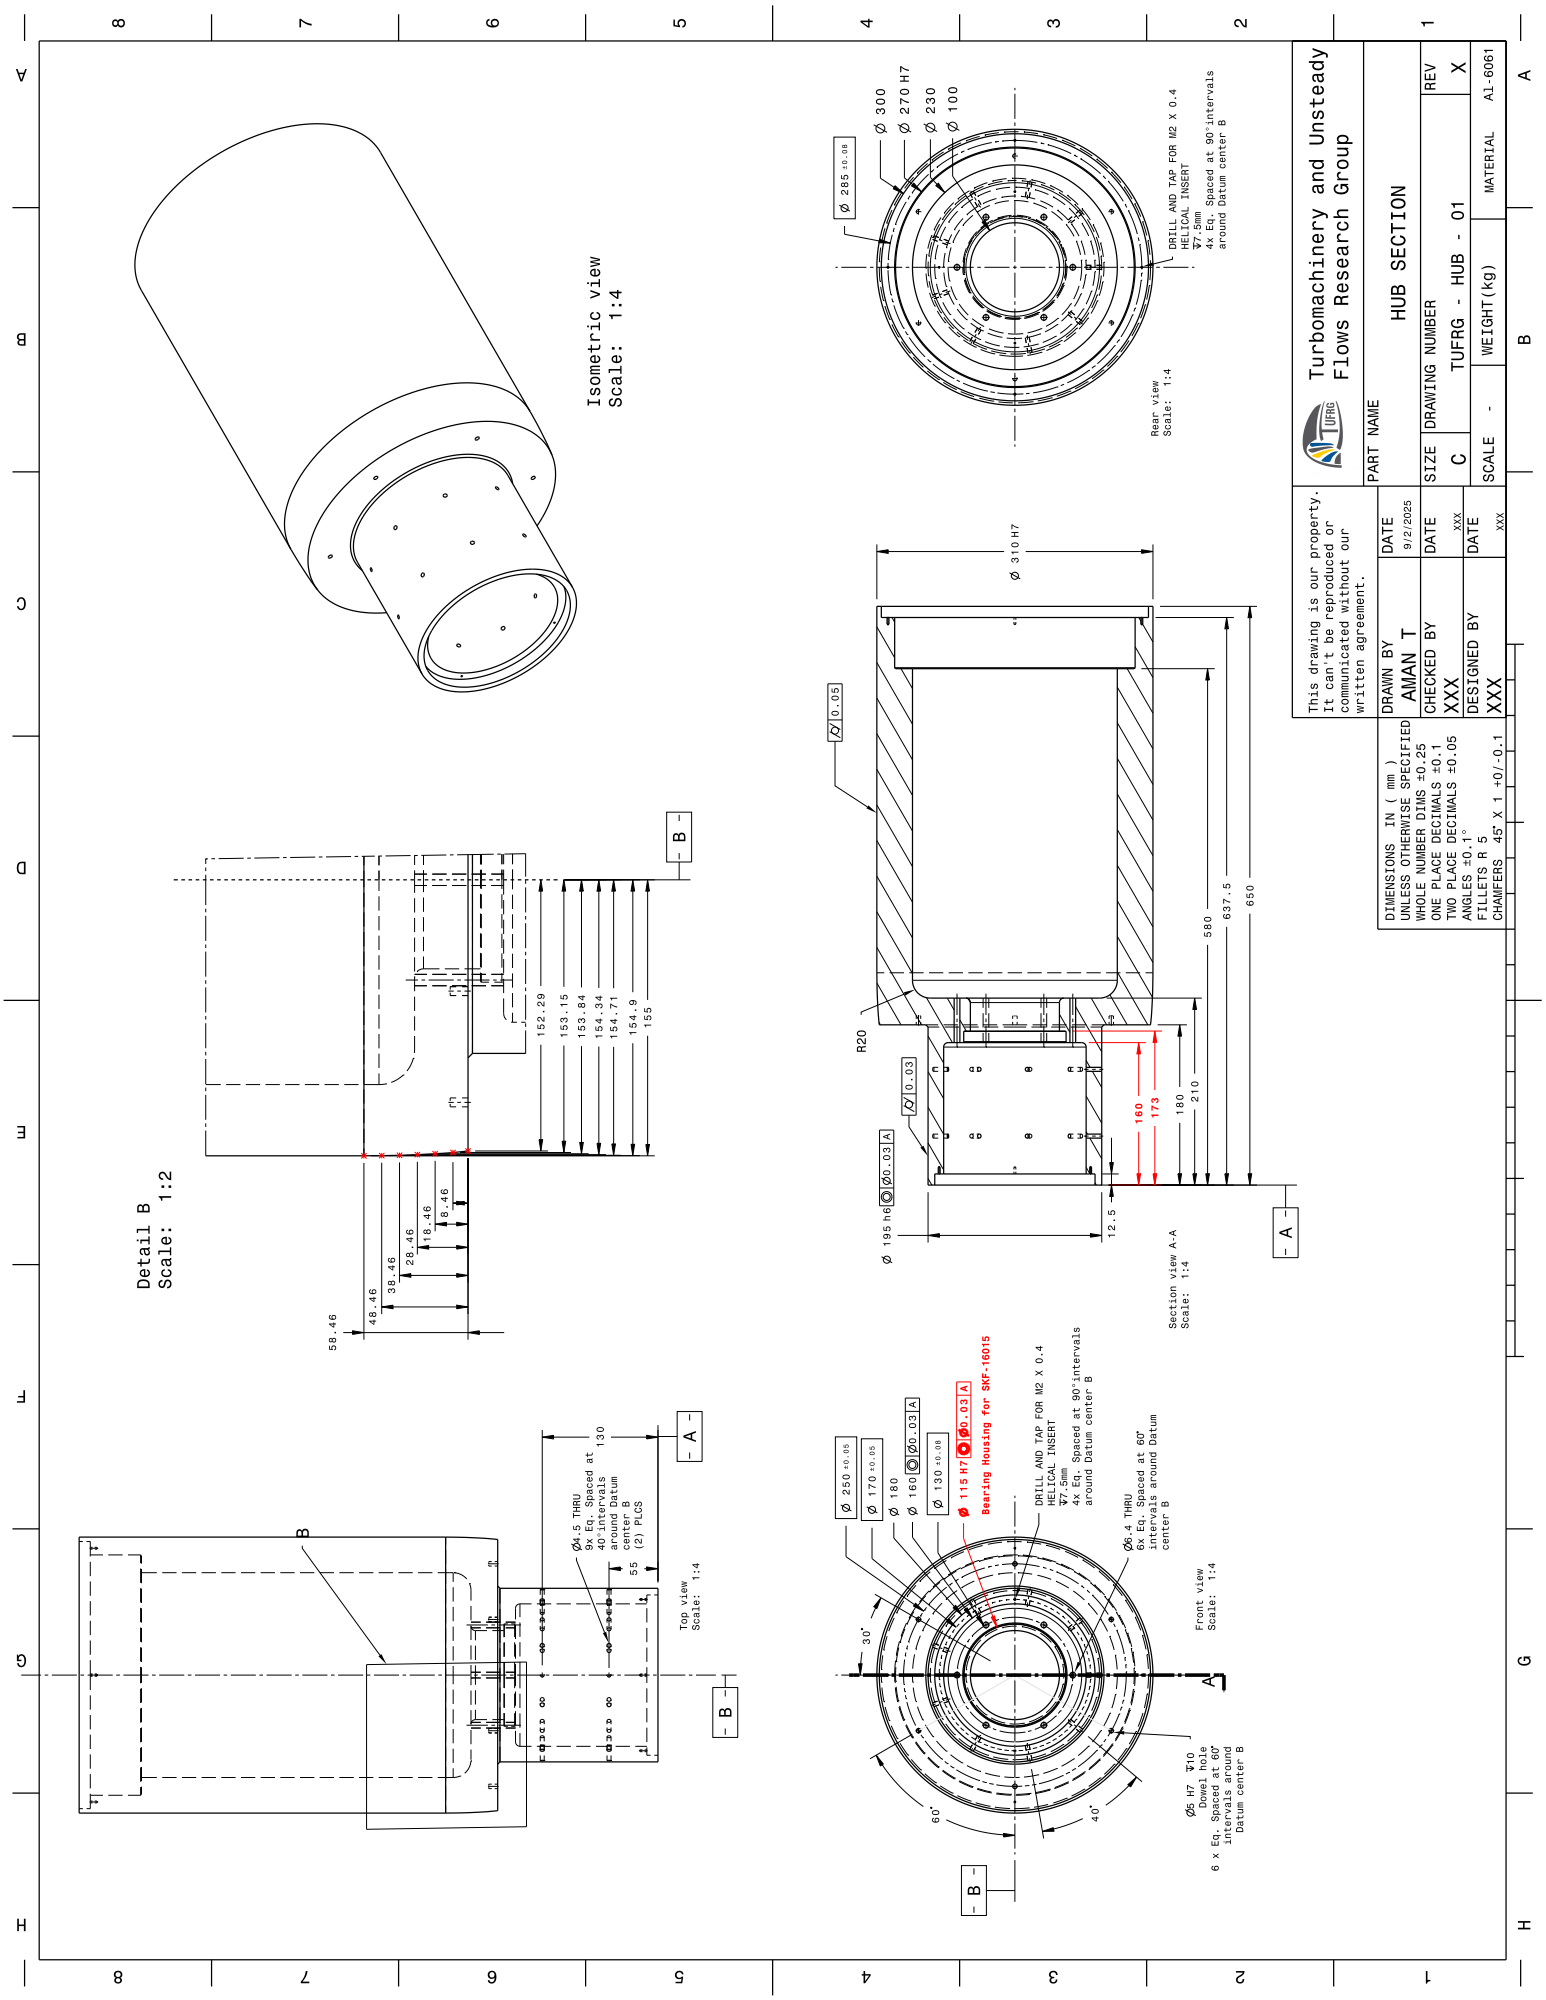
[picture p49: page 1]
