TUFRG/LSF-Rig-GT2026-176284/Engineering Drawings/Motor Support base-10mm.pdf

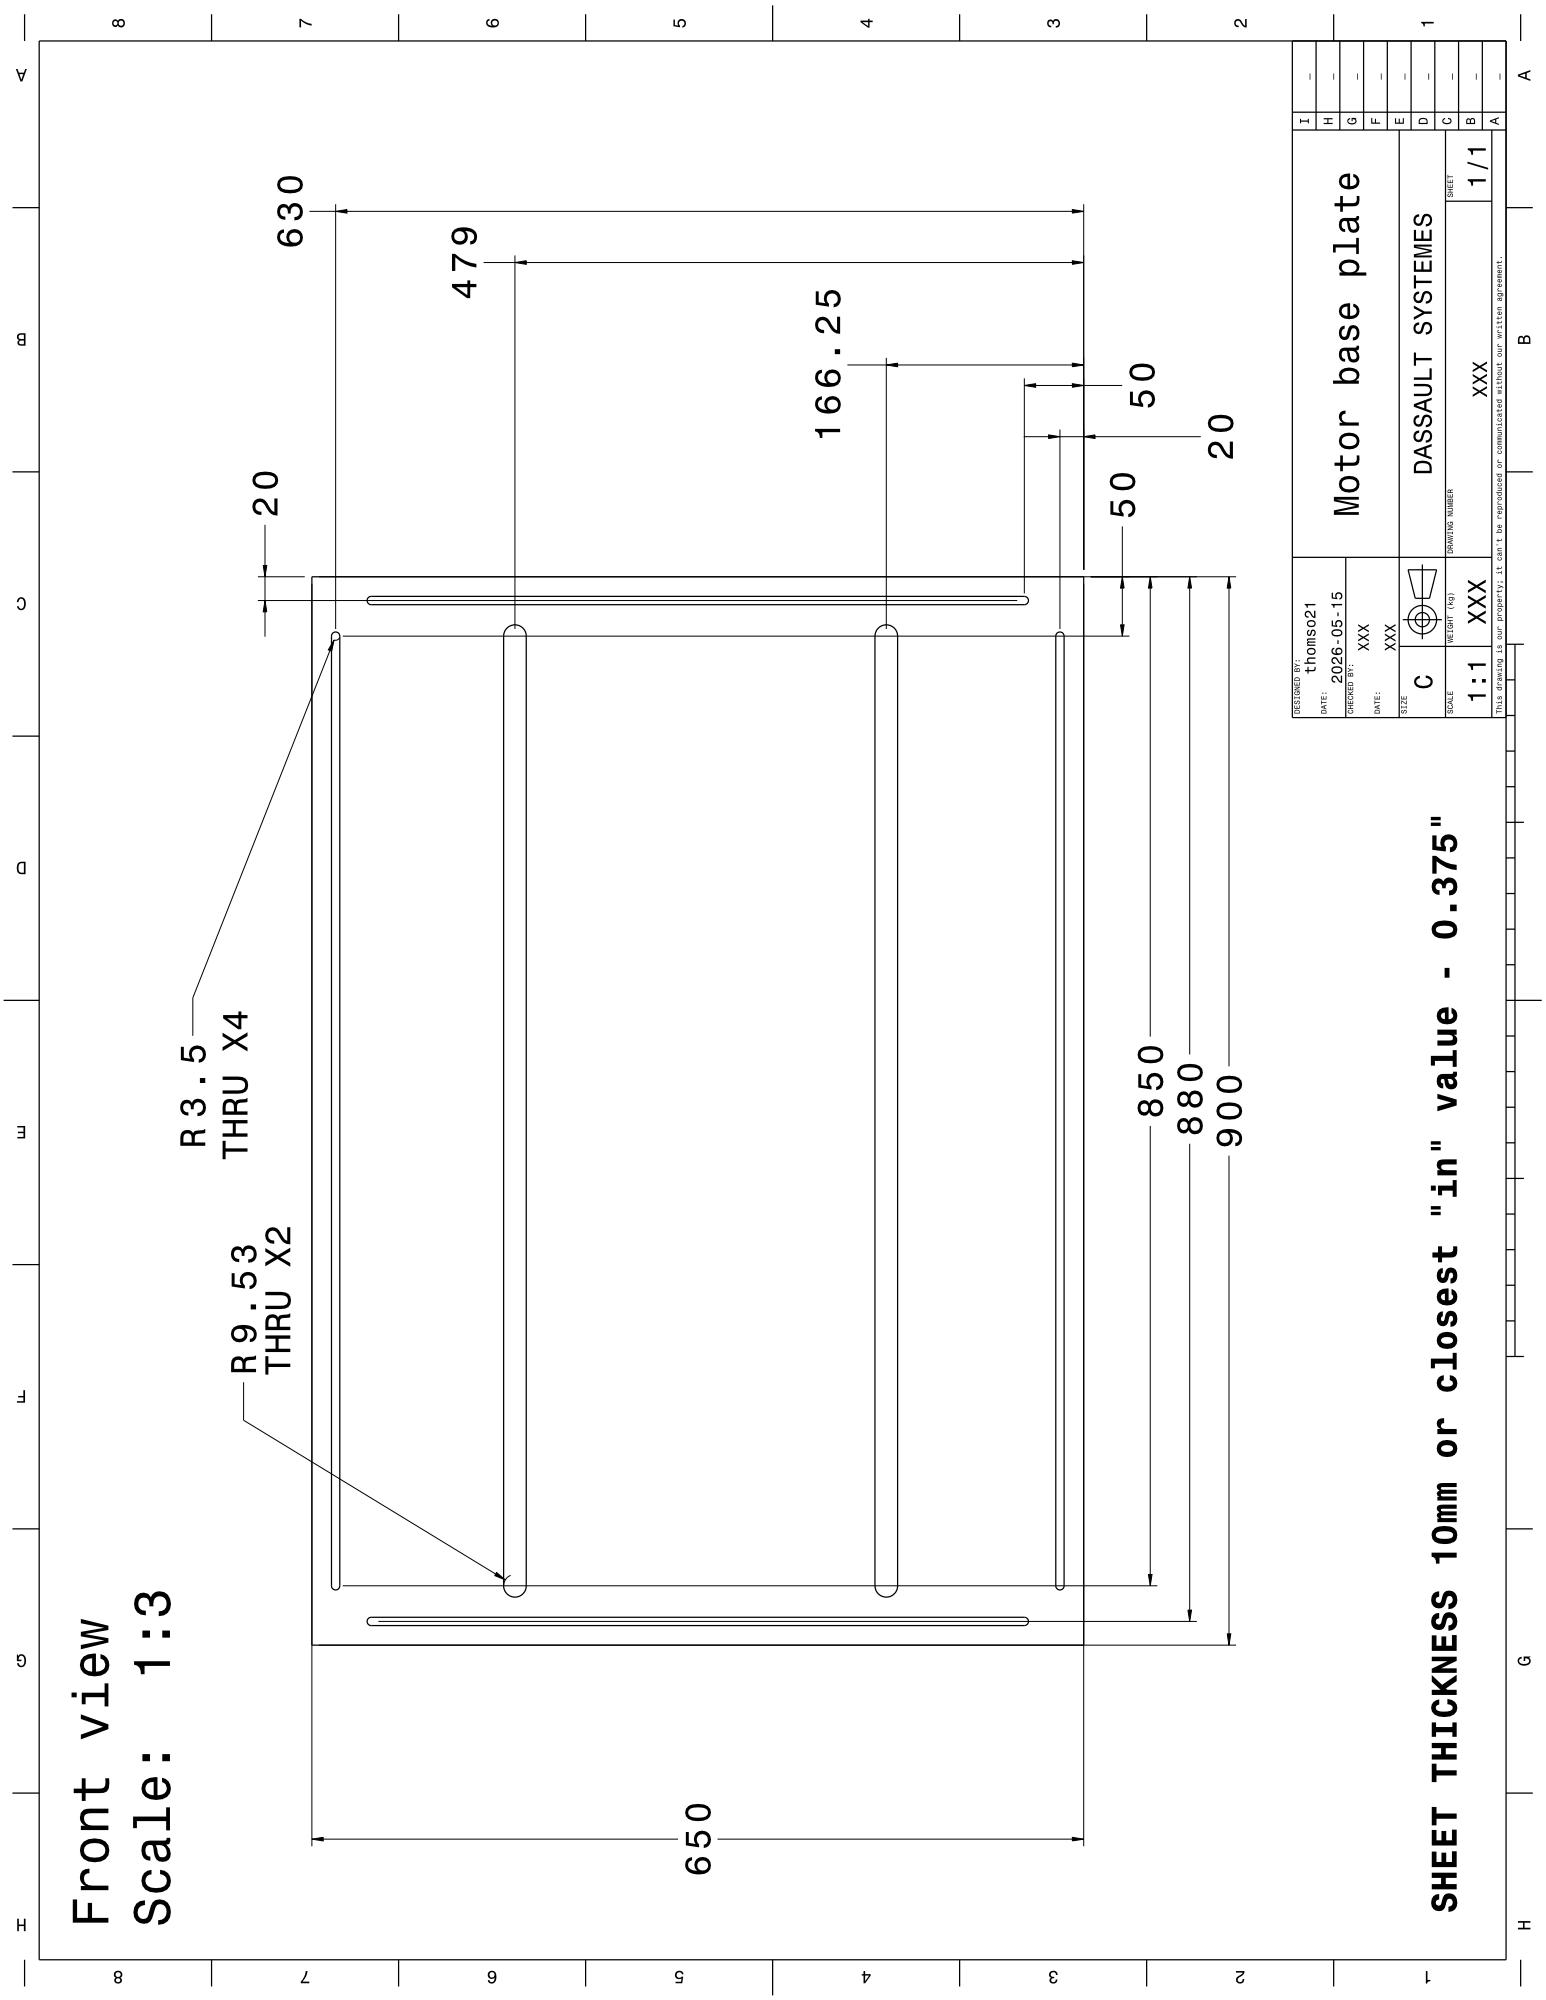
[picture p50: page 1]
