TUFRG/LSF-Rig-GT2026-176284/Engineering Drawings/Motor Support base-8.82mm.pdf

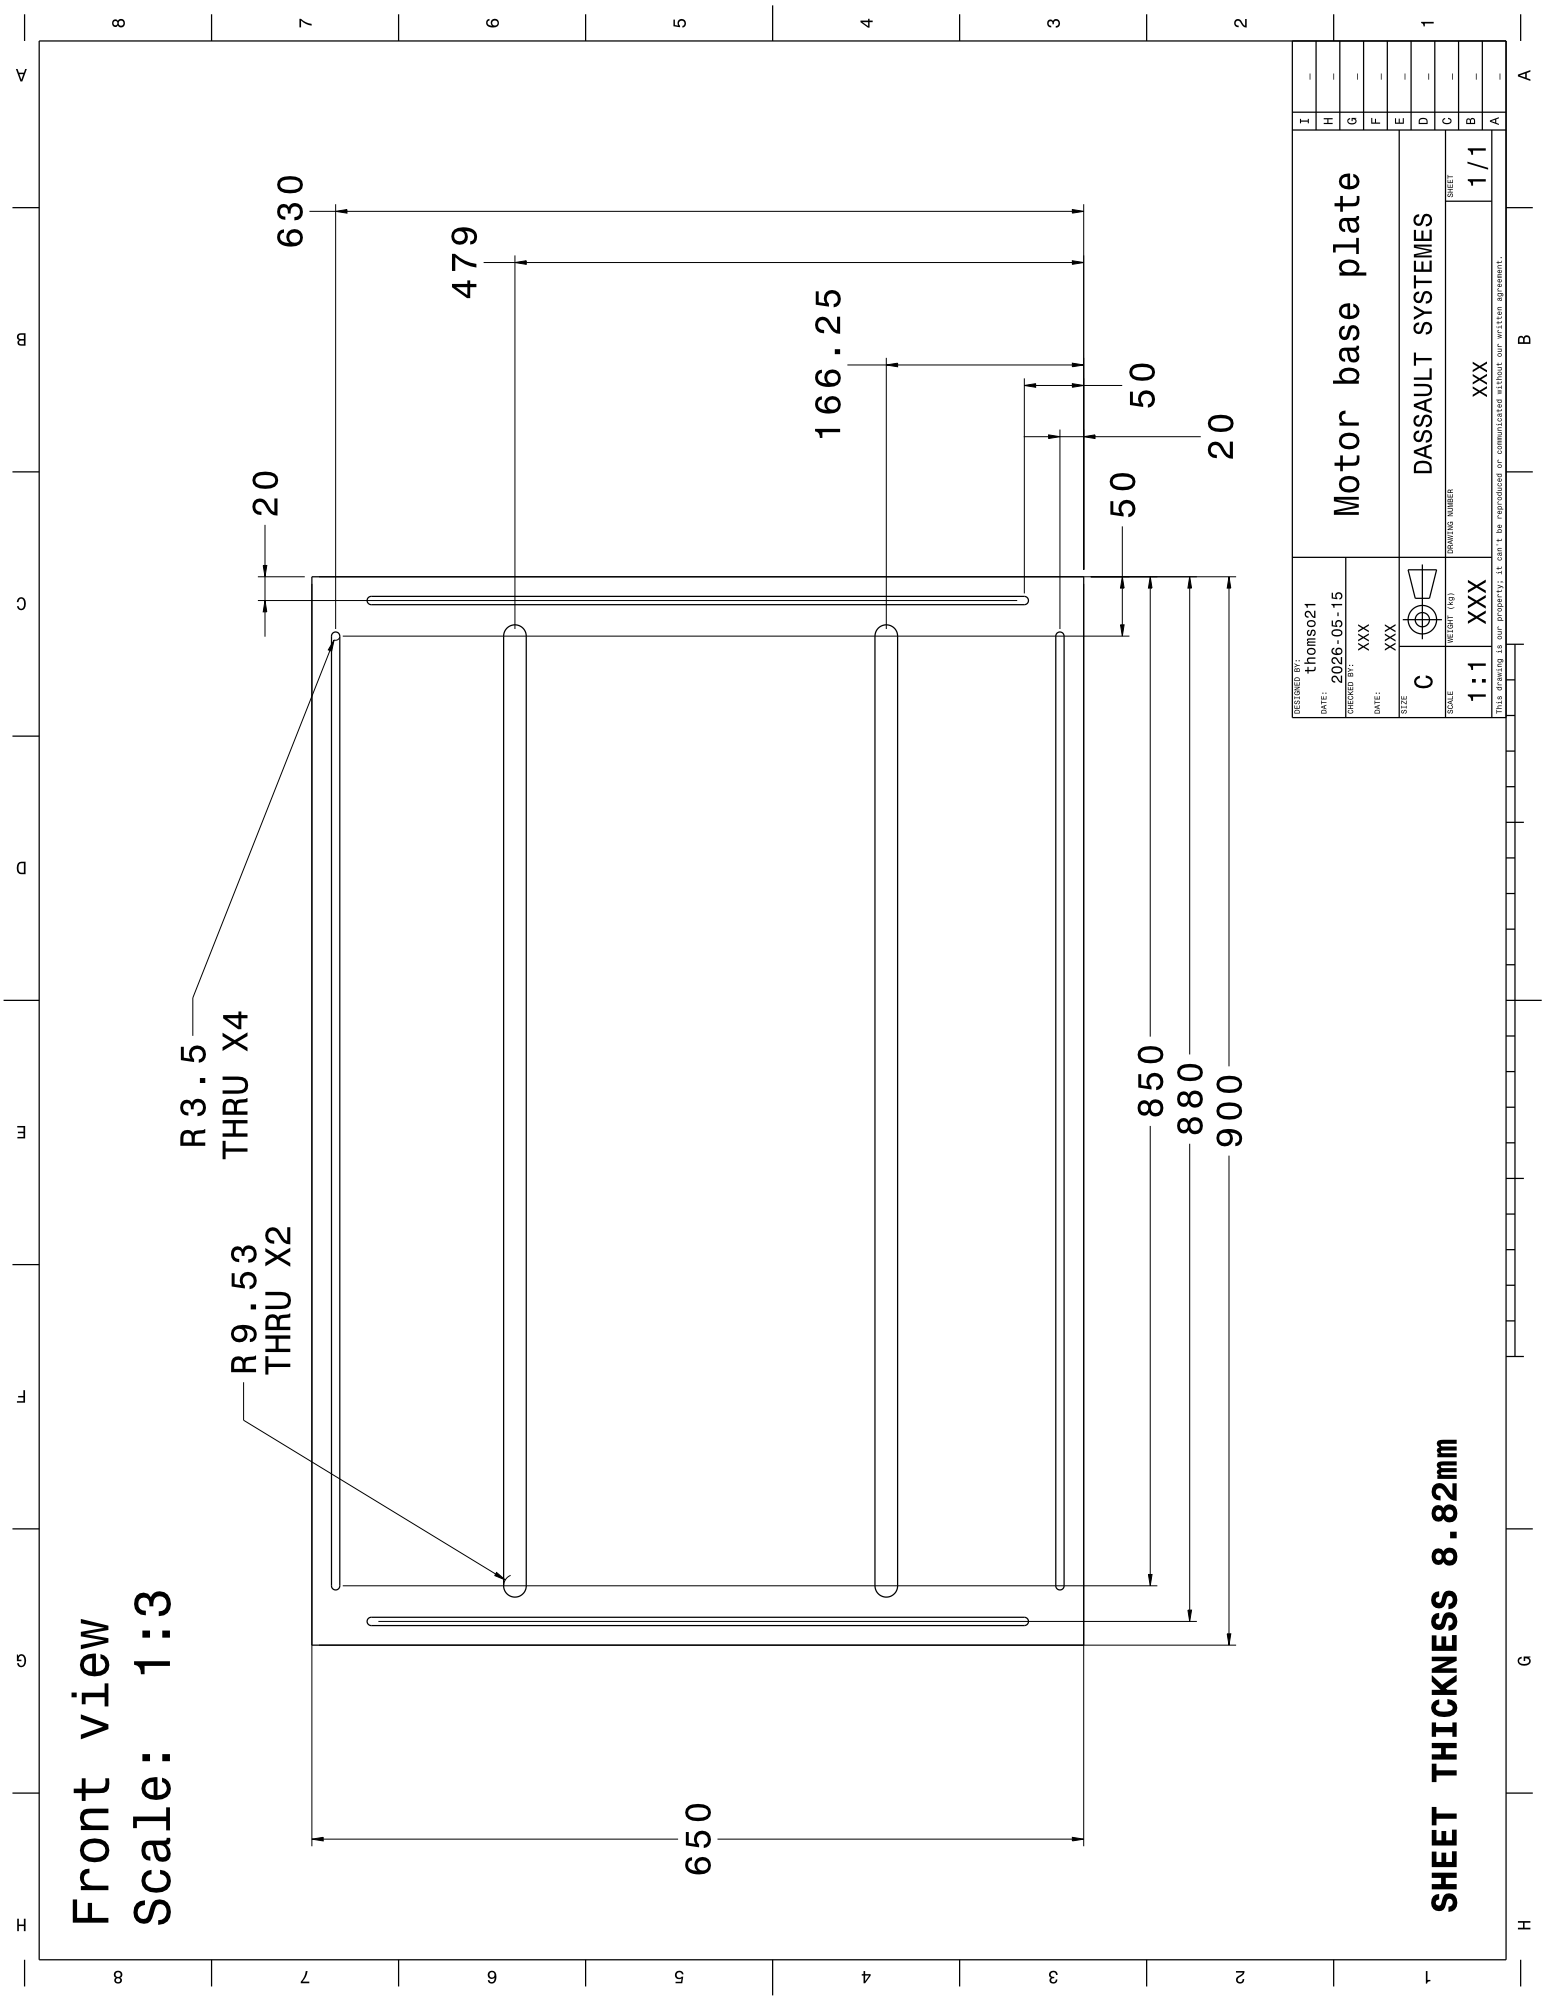
[picture p51: page 1]
