TUFRG/LSF-Rig-GT2026-176284/Engineering Drawings/Plenum Block-Support Structure.pdf

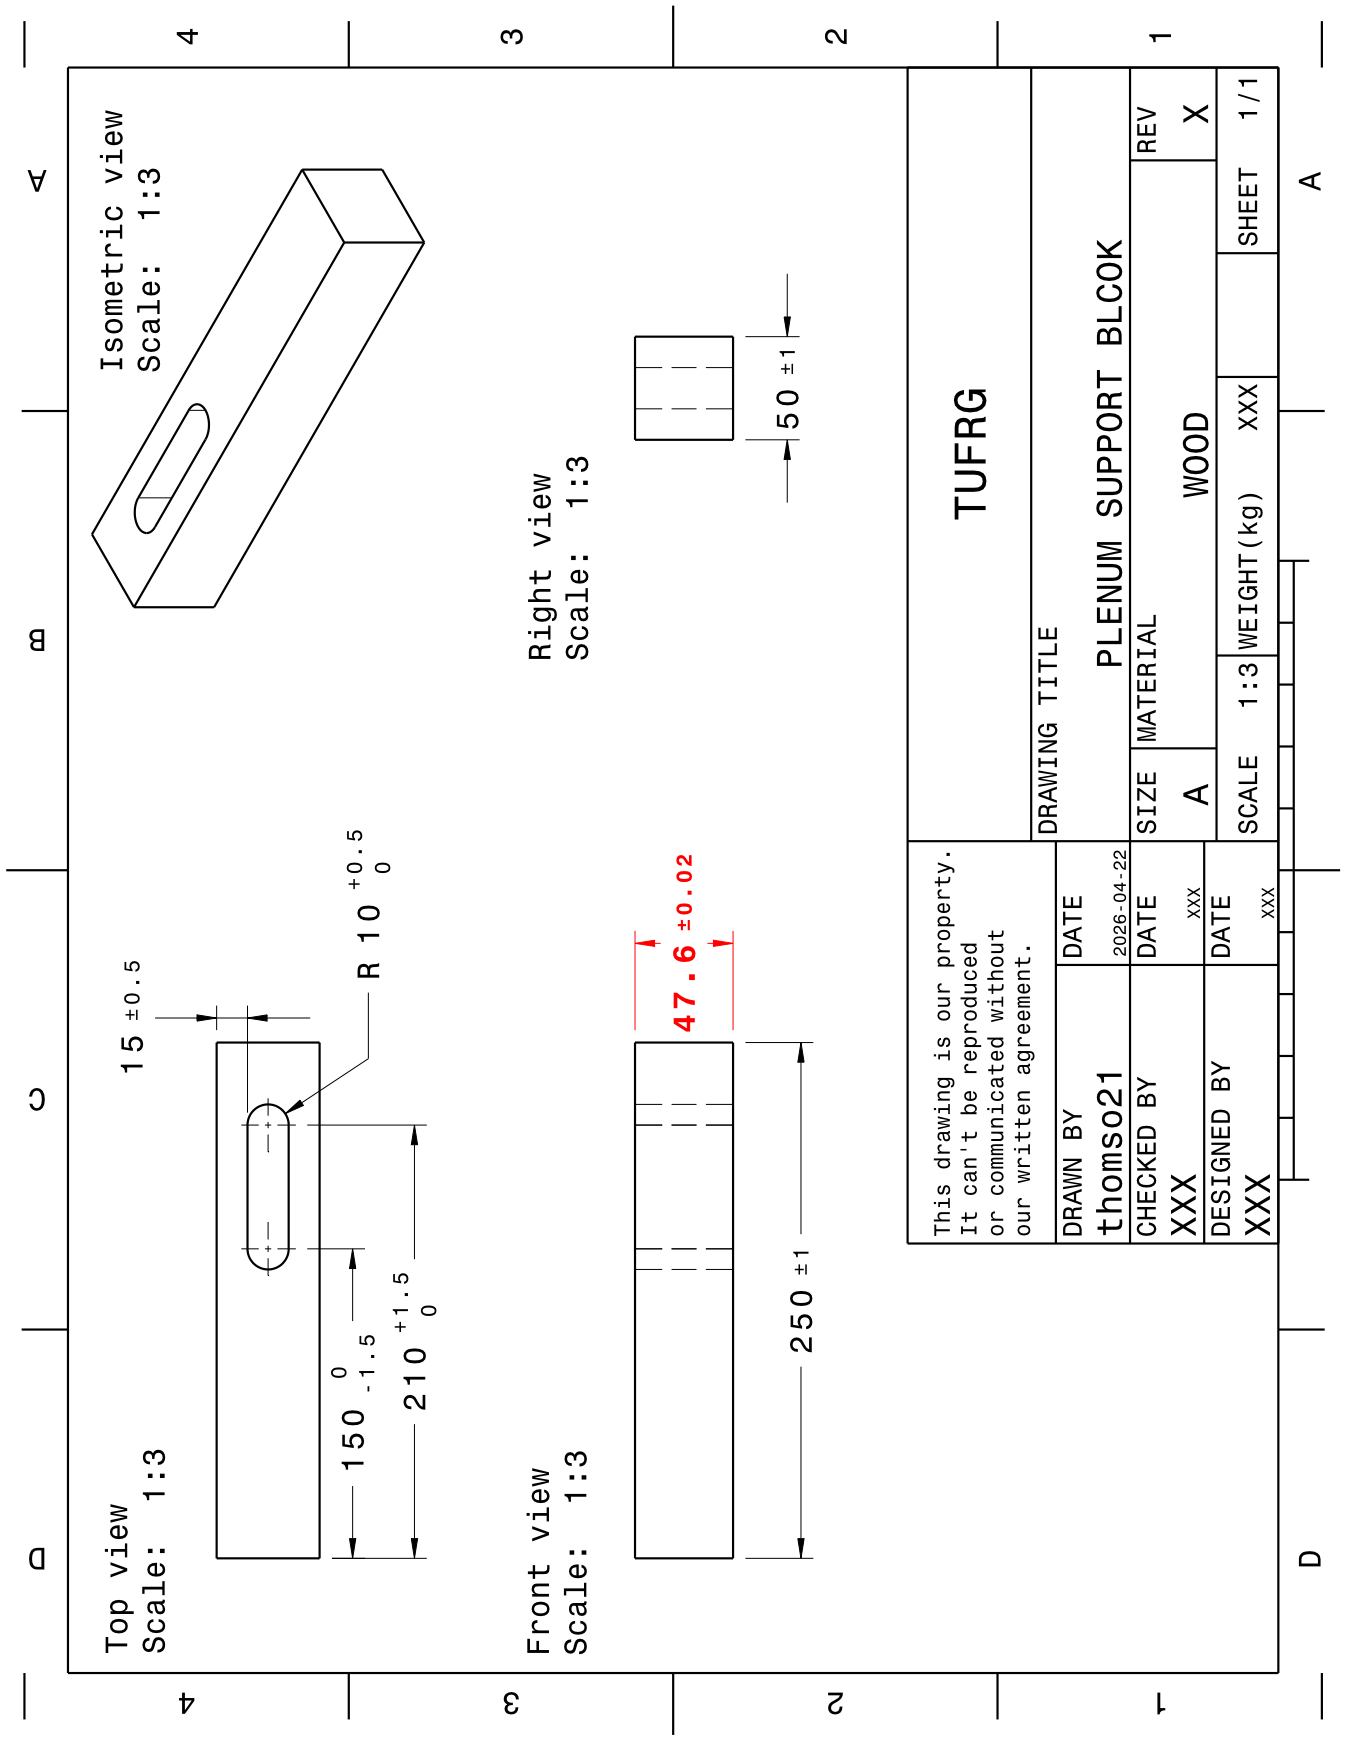
[picture p52: page 1]
