TUFRG/LSF-Rig-GT2026-176284/Engineering Drawings/Rotor Support Base - Updated.pdf

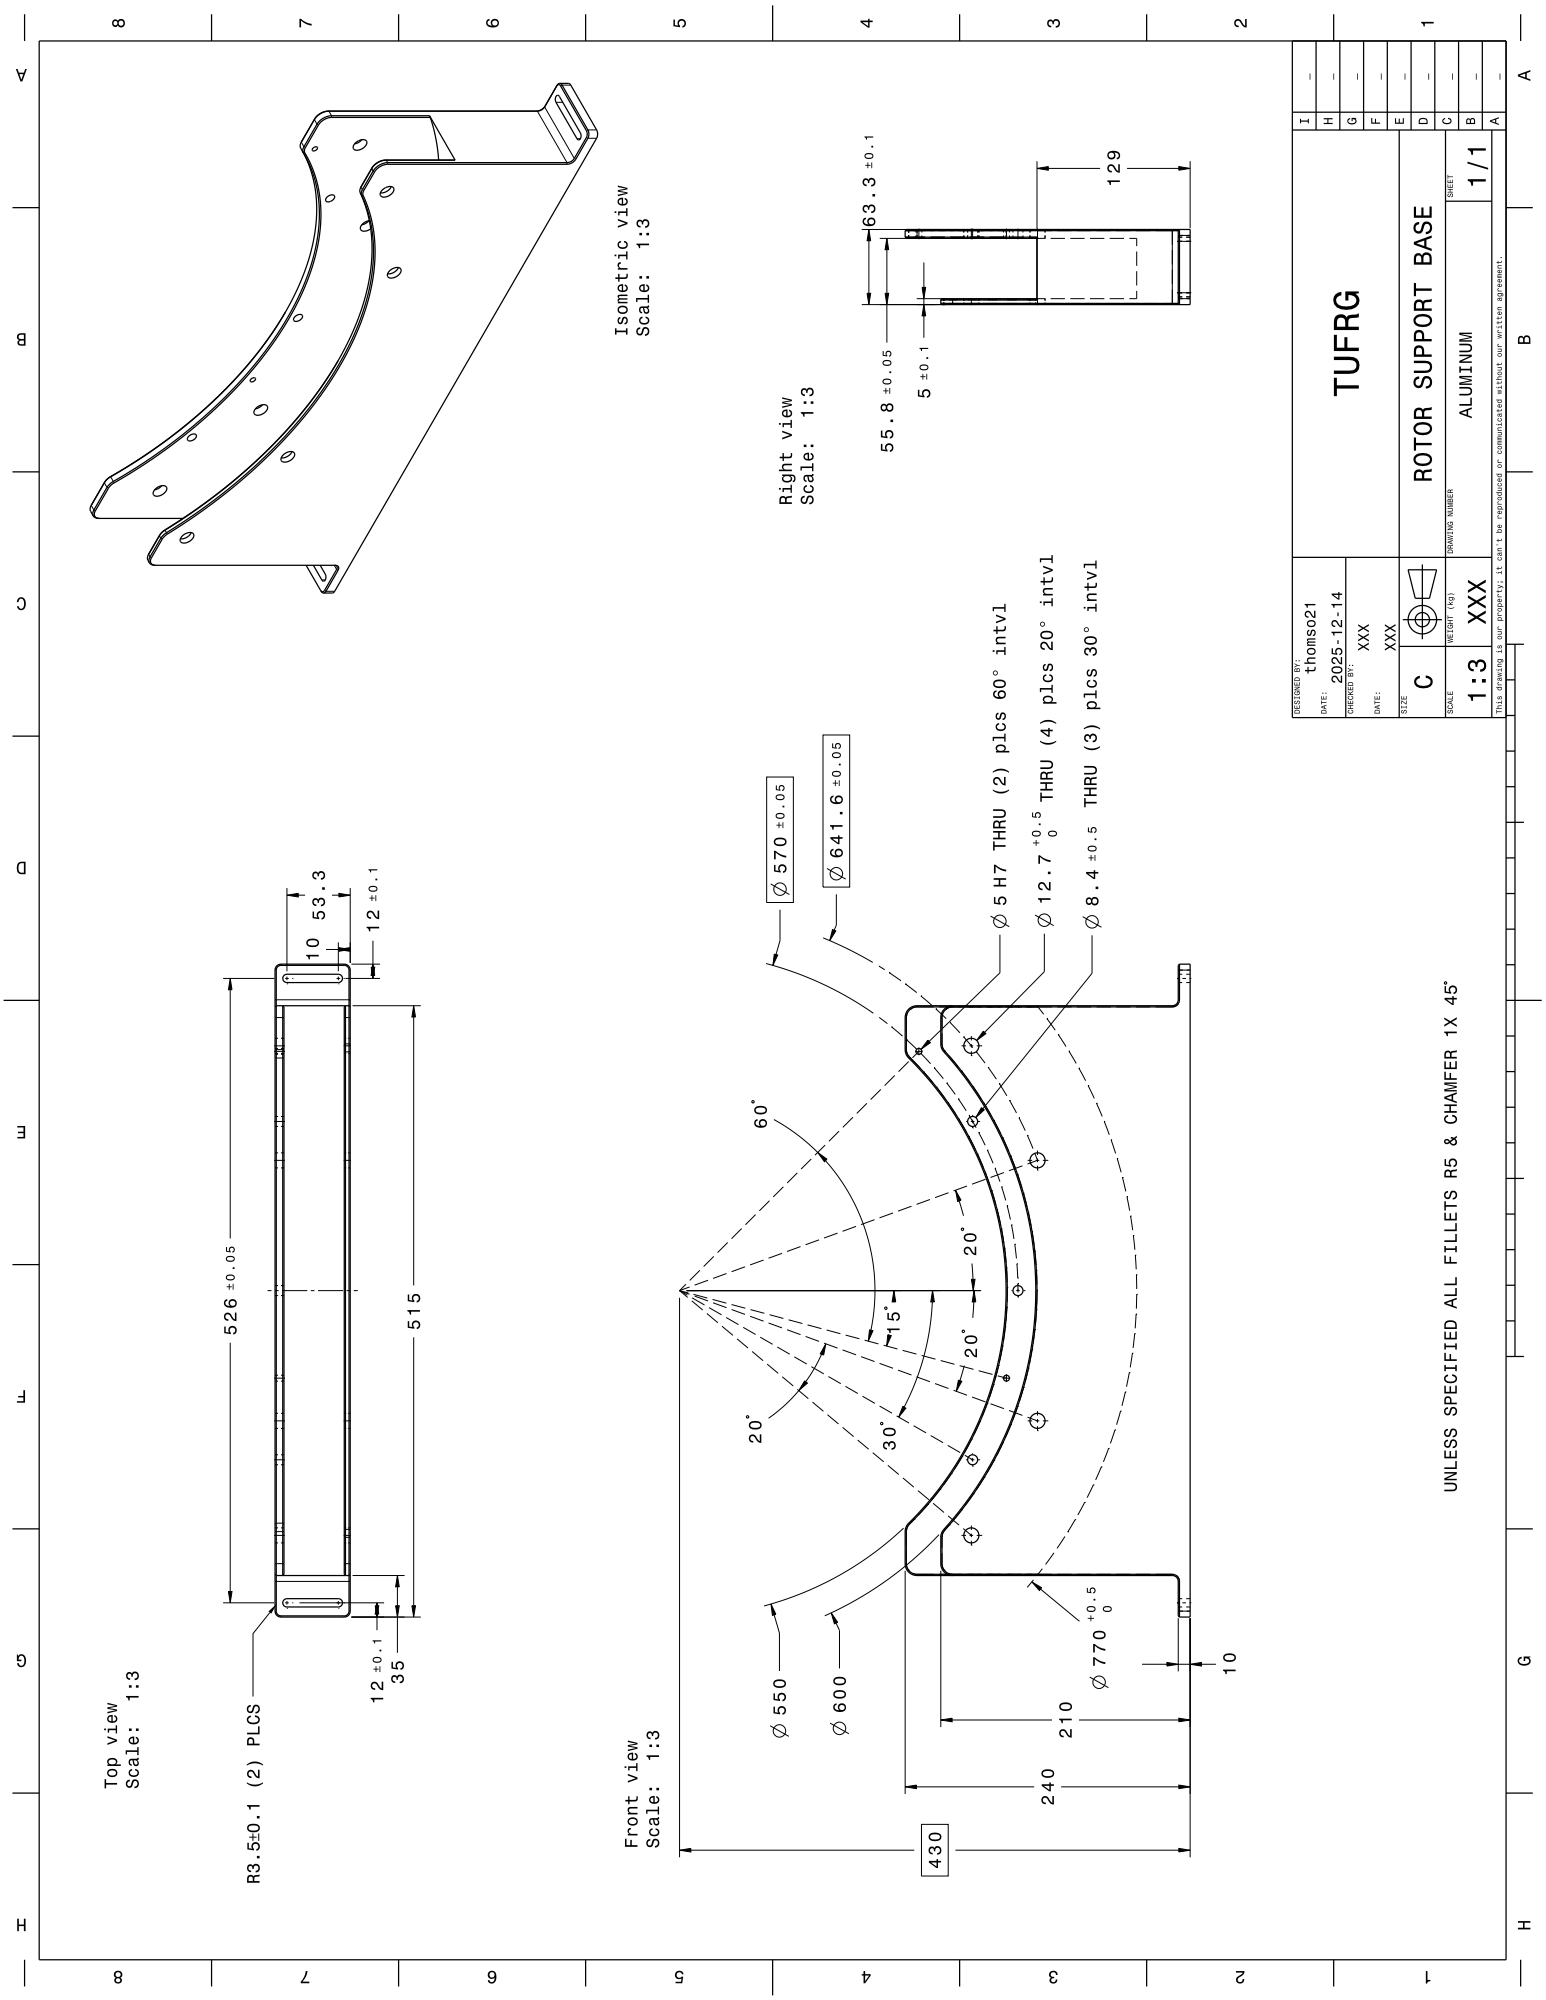
[picture p53: page 1]
