TUFRG/LSF-Rig-GT2026-176284/Engineering Drawings/Rotor Support Base Plate.pdf

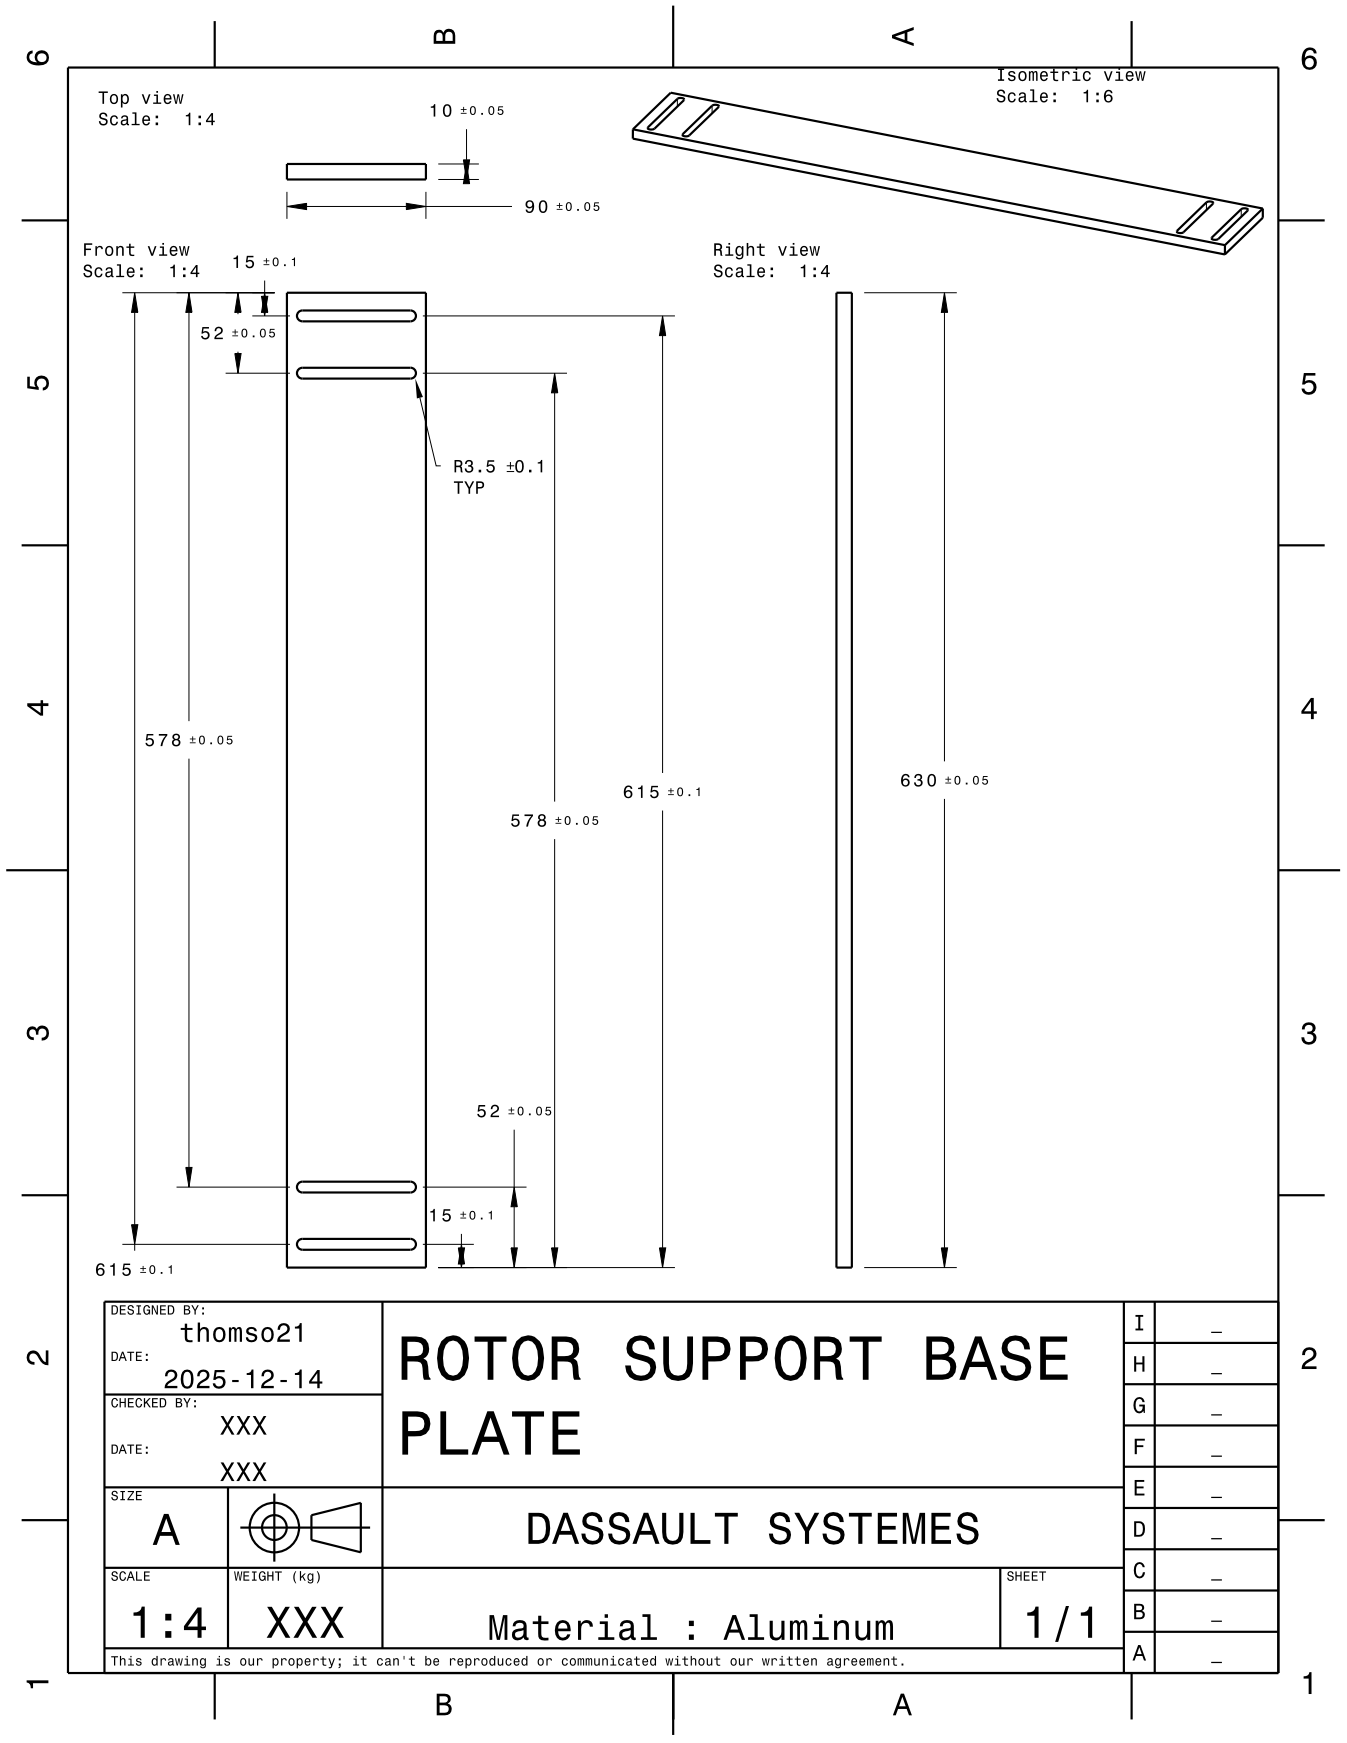
[picture p54: page 1]
