TUFRG/LSF-Rig-GT2026-176284/Engineering Drawings/Stator Support  Base plate.pdf

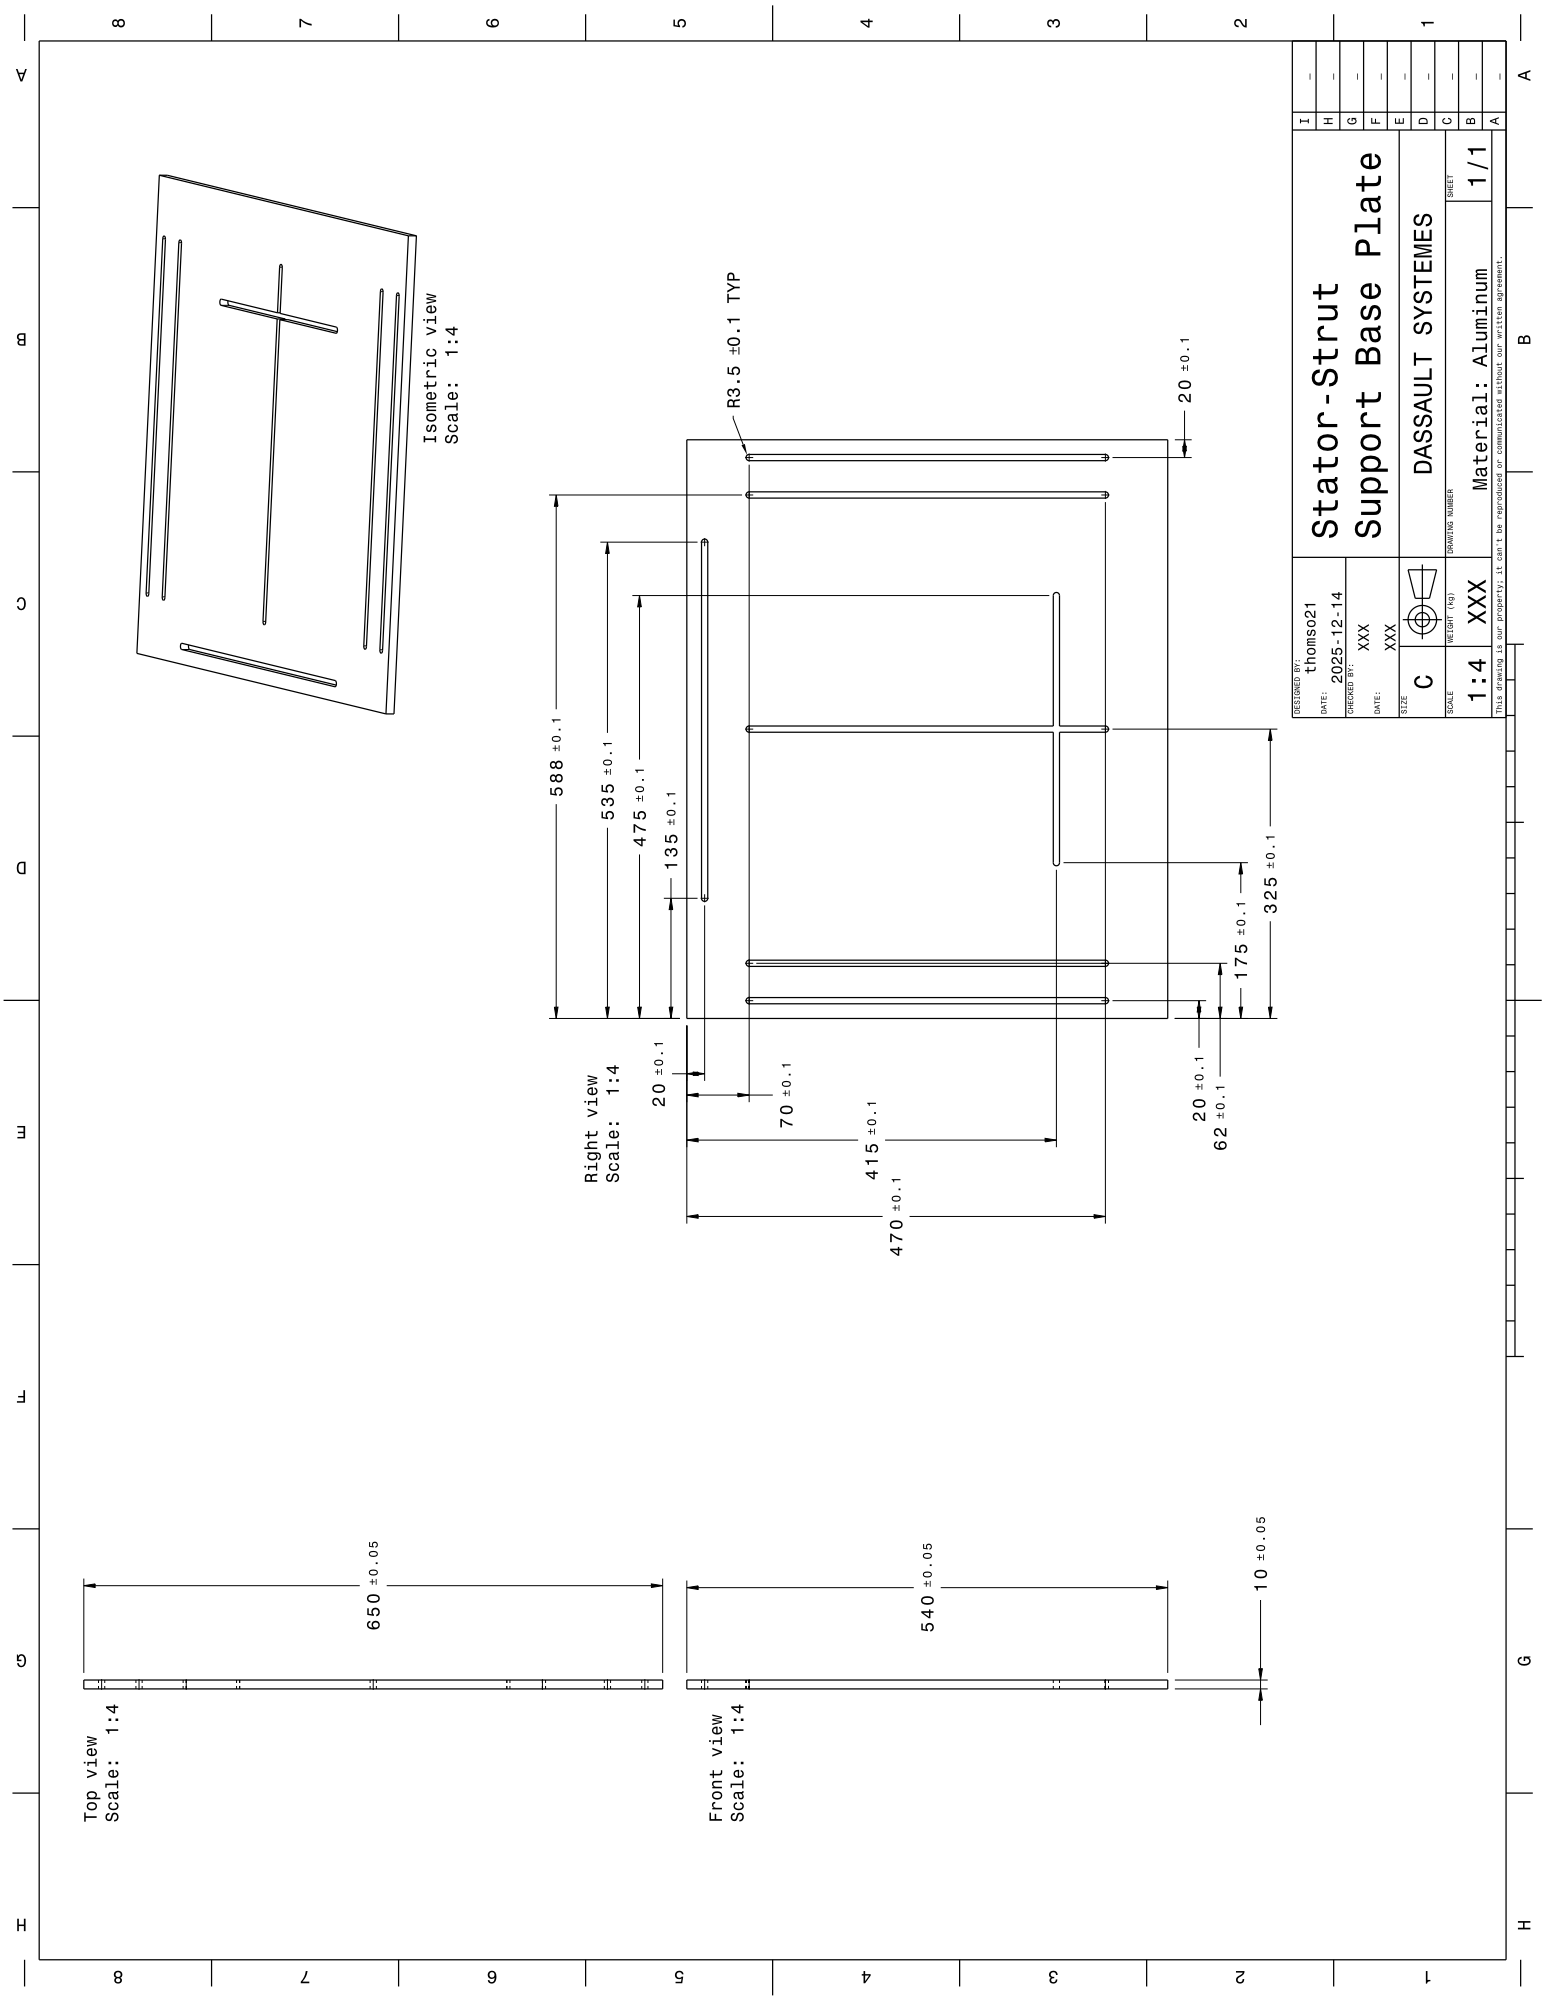
[picture p55: page 1]
