TUFRG/LSF-Rig-GT2026-176284/(commit log)

2026-06-10 Revert "Add files via upload"
    This reverts commit 928d9513ac33233aefbfa730402627218188b85c.
    [0_ISO-Bell Mouth.CATPart, 11-Traverse Sliding Ring.CATPart, 13-Rotor Hub Abradable - 2.CATPart, 13-Rotor Hub Abradable 1.CATPart, 14-Strut Hub Abradable - 2.CATPart, 14-Strut Hub Abradable 1.CATPart, 15-Upstream Traverse Plugs.CATPart, 16-Downstream Traverse Plugs.CATPart]
2026-06-12 Added README for plenum CFD case
2026-10-07 Updates to support structure - #3 and Motor Support to Help improve stiffness and resist deflections
    [1.5ft.CATPart, 100.CATPart, 1000.CATPart, 1000mm.CATPart, 12in brace.CATPart, 18in brace.CATPart, 210mm.CATPart, 2ft.CATPart]
2026-10-13 Removed Redundant files
    [Motor Support.CATPart, Support 1 Assembled.CATPart, Support 3 Assembled.CATPart]
2026-10-14 Probe Holder items
    [1_Distortion Screen Traverse Ring 1D.CATPart, 4232N22_Press-Fit Ball-Nose Spring Plunger.CATPart, 4232N22_Press-Fit Ball-Nose Spring Plunger.STEP, 6391K332_Oil-Embedded 841 Bronze Sleeve Bearing.1.CATPart, 90128A217_Zinc-Plated Alloy Steel Socket Head Screw.STEP, 90591A255_Zinc-Plated Steel Hex Nut.STEP, 91860A030_17-7 PH Stainless Steel Washer.1.CATPart, 92620A540_Zinc Yellow-Chromate Plated Hex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]
2026-10-16 Hole pattern fix - Traverse cover base
    [Base.CATPart, Top part.CATPart, Traverse Covers.CATProduct, traverse cover Base.CATPart]
